kishorkishor/Terrarium/tools/report/assets/bench-photo.jpg

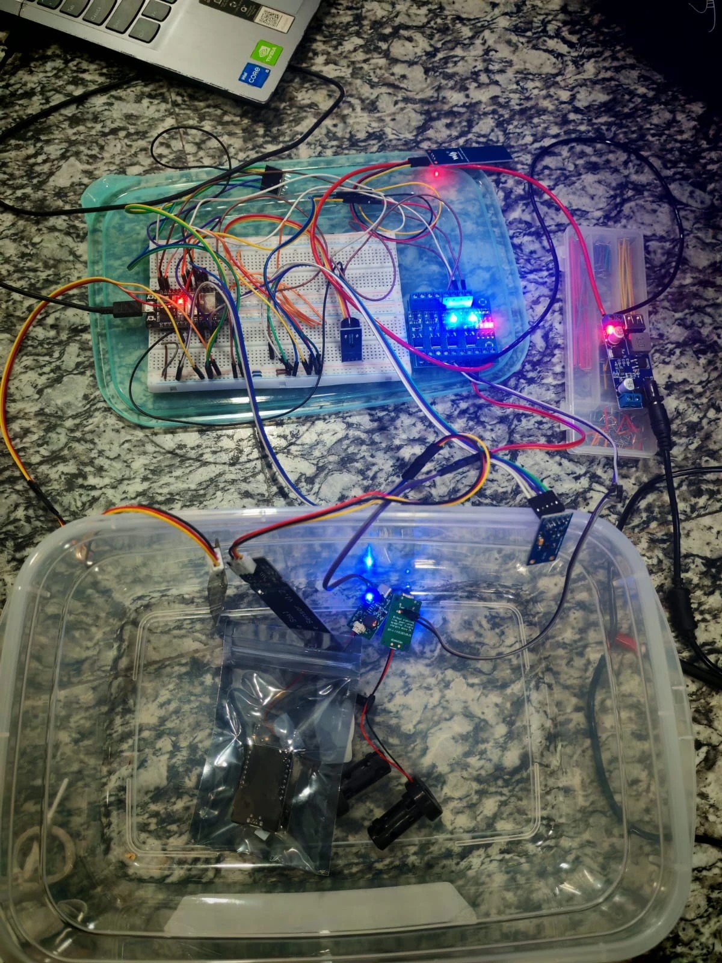
tools/report/assets/bench-photo.jpg
