kishorkishor/Terrarium/tools/report/assets/prototype-photo.jpg

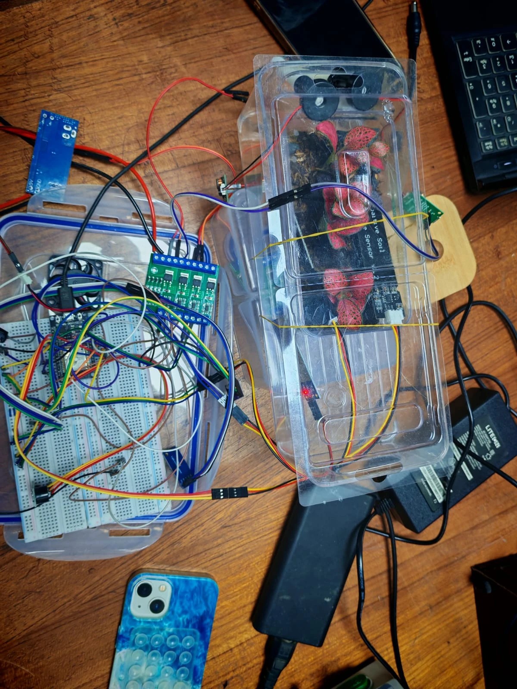
tools/report/assets/prototype-photo.jpg
