kishorkishor/Terrarium/3d/acrylic/README.md

# Bigger transparent enclosure (laser-cut clear acrylic)

Generated by `make_acrylic.py`. Change a number at the top of the script and run it again to resize everything.

## Size

| | mm | ft |
|---|---|---|
| Whole box, outside | 548 x 222 x 256 | 1.80 x 0.73 x 0.84 |
| Terrarium bay, inside (two fittonias) | 320 x 200 x 250 | 1.05 x 0.66 x 0.82 |
| Electronics bay, inside | 110 x 200 x 250 | 0.36 x 0.66 x 0.82 |
| Air-unit bay, inside | 90 x 200 x 250 | 0.30 x 0.66 x 0.82 |

## What to give the cutting shop

Folder `cut-files/`. Each sheet comes as `.ai`, `.pdf`, `.dxf` and `.svg`; they are the same drawing, 1:1 in mm, red hairline cut lines, no text.

| File | Material | Sheet |
|---|---|---|
| `sheet_A_3mm` | 3 mm clear **cast** acrylic | 900 x 600 mm |
| `sheet_B_3mm` | 3 mm clear **cast** acrylic | 900 x 600 mm |
| `sheet_C_2mm` | 2 mm clear acrylic (damper plate only) | 206 x 305 mm offcut |

If their bed is smaller than 900 x 600, they can re-nest the parts; every part is a closed shape.
The `.ai` files are PDF-format Illustrator files. Open in Illustrator and Save As if the shop wants a specific AI version.
`PART-MAP_sheet_*.pdf` shows which outline is which part. Do not send the part map for cutting.

## Every component and where it goes

| Component (firmware pin) | Where | Opening / mount provided |
|---|---|---|
| ESP32 DevKit | electronics bay | `electronics_tray`, 10 mm grid of M3 holes; USB slot in `end_electronics` |
| MOSFET board(s) for fans, light, mist | electronics bay | tray grid |
| LM2596 buck converter | electronics bay | tray grid |
| Two mist driver boards (GPIO25, GPIO16) | electronics bay | tray grid; disc cables through low grommets |
| Buzzer (GPIO26) | electronics bay | tray grid; vents let the sound out |
| 12 V DC input jack | `end_electronics` | 8 mm hole |
| 5x20 fuse holder | `end_electronics` | 12 mm hole |
| Spare switch / button | `end_electronics` | 6 mm hole |
| Electronics cooling | `end_electronics`, `back`, `lid_electronics` | vent slots low and high |
| BME280 + BH1750 (I2C 21/22) | terrarium, hung high on the solid divider | 12 mm high grommet |
| Soil probes x2 (GPIO34, 35) | in the two pots | low grommets, 12 mm x4 |
| Float switch (GPIO27), leak probe (GPIO32) | terrarium floor / water cup | low grommets |
| Mist discs x2 | water cup in the terrarium | low grommets; 25 mm refill port in `lid_terrarium` |
| DS18B20 (GPIO4, reserved) | terrarium | low grommets |
| LED light strip (GPIO19) | under `lid_terrarium` | 6 mm cable hole in the lid |
| Circulation fan 40 mm (GPIO18) | hangs under `lid_terrarium` | `fan_bracket` + two slots in the lid |
| Exhaust fan 40 mm (GPIO17) | `end_fan` | 38 mm hole, 4 x 3.4 mm screws at 32 mm; cable runs through the 8 mm top-corner holes in both dividers |
| Slide damper | between terrarium and air unit | `divider_damper` + `damper_plate` + 2 spacers + 2 covers; notch in `lid_air` |
| Fresh-air intake | `lid_terrarium`, electronics end | 5 slots |
| Peltier (optional) | air-unit bay | 6 mm drain hole in the base; no cutout made, add when the module is chosen |

Measure your DC jack, fuse holder and grommets before cutting. Hole sizes are one line each in the script.

## Assembly

1. Dry-fit first. Cross panels (2 ends, 2 dividers) tab into the front, back and base.
2. Glue with acrylic solvent cement (or chloroform from a sign shop). Run a bead of aquarium silicone along every inside seam of the terrarium bay and over the tab slots in its floor.
3. Damper: glue `guide_spacer` strips to the air-unit side of `divider_damper`, flush with the front and back walls, 5 mm above the floor. Drop the 2 mm plate between them, then glue `guide_cover` strips on top of the spacers so they overhang the plate. Plate resting on the floor = closed. Lift 10 mm and push an M3 screw through the lower tab hole so it rests on the lids = open.
4. Glue four `lid_locator` strips under each lid, just inside the walls, so lids cannot slide.
5. Keep the fittonias in pots or a plastic tray with drainage layer; do not fill the acrylic box itself with water.

## Onshape

- Quick look: import `acrylic-assembled.stl` (units: millimeter).
- Native, editable parts: import the files in `onshape-dxf-per-part/`, then in a Part Studio start a sketch, use **Insert DXF or DWG**, and extrude 3 mm (2 mm for the damper plate).
