kishorkishor/Terrarium/ffffffffffffffffffffffffffff (1) (2).docx

| AMERICAN INTERNATIONAL UNIVERSITY-BANGLADESH (AIUB) Faculty of Engineering Department of CSE, EEE, and CoE EEE4103 MICROPROCESSOR AND EMBEDDED SYSTEMS

COURSE CAPSTONE PROJECT PROPOSAL

Design and Implementation of an IoT-Based Automated Tropical Terrarium Environmental Monitoring and Control System

Semester | Summer 2025-26
Section | [INSERT SECTION]
Faculty Member | [INSERT FACULTY MEMBER]
Project Group No. | [INSERT GROUP NUMBER]
Submission Date | [INSERT DATE]
Survey Link | [INSERT GOOGLE/MICROSOFT FORMS LINK]

Prepared in accordance with the official EEE4103 capstone proposal requirements for Summer 2025-26.

Group Members

Sl. | Student Name | Student ID | Program / Email
1
2
3
4
5
6

Note: The official form permits a maximum of six members. A four-member group may be allowed depending on capability, but the form states that fewer than four students are not permitted.

1. Project Title [2 Marks]

Design and Implementation of an IoT-Based Automated Tropical Terrarium Environmental Monitoring and Control System

The title identifies the target system (a tropical terrarium), the engineering method (ESP32-based embedded control and IoT communication), and the intended outcome (automated environmental monitoring and regulation). Both a physical prototype and a functional simulation will be demonstrated.

2. Project Description and Problem Statement

Indoor terrariums require regular observation and careful balancing of air temperature, relative humidity, soil moisture, illumination, ventilation, and water availability. Manual care may become inconsistent when users are busy, away from home, or unfamiliar with plant requirements. Overwatering can produce waterlogging, root damage, odour, and fungal growth; underwatering, high temperature, poor ventilation, and inadequate lighting can weaken plants. A compact embedded system can reduce these risks by sensing the environment, applying controlled corrective actions, and warning the user when intervention is required.

The proposed system will use an ESP32 DevKit V1 as the local decision-making unit. It will measure temperature and humidity using a DHT22 module, root-zone moisture using a capacitive sensor, illumination using a BH1750, reservoir availability using a sealed float switch, and accidental leakage using a drip-tray sensor. Configurable thresholds, hysteresis, time limits, and safety interlocks will control a 5 V irrigation pump, 5 V mist maker, 5 V exhaust fan, and 5 V grow light through a 3.3 V-trigger opto-isolated relay module. A mobile IoT dashboard will provide live values, historical graphs, alerts, manual control, threshold adjustment, and automatic/manual operating modes. Local automatic operation will continue if Wi-Fi becomes unavailable.

3. Survey [12 Marks]

A Google Forms or Microsoft Forms survey will evaluate the practical need, user expectations, affordability, electrical-safety concerns, environmental value, and societal acceptance of the automated terrarium. The survey contains 20 questions, exceeding the minimum requirement of 12 questions, and will collect at least 40 genuine responses.

No. | Question | Type | Options / Scale
1 | What is your age group? | Multiple choice | Below 18; 18-24; 25-34; 35-44; 45 or above
2 | What is your current occupation? | Multiple choice | Student; Teacher; Service holder; Businessperson; Homemaker; Other
3 | Where do you currently live? | Multiple choice | Urban area; Suburban area; Rural area
4 | Are you familiar with terrariums or enclosed indoor plant ecosystems? | Multiple choice | Yes; Somewhat; No
5 | Do you currently keep indoor plants at your home, office, or educational institution? | Multiple choice | Yes; No; Previously did
6 | How often do you forget to water or care for indoor plants? | Multiple choice | Never; Rarely; Sometimes; Often; Very often
7 | Have any of your indoor plants become unhealthy or died because of improper watering, lighting, temperature, or humidity? | Multiple choice | Yes; No; Not sure
8 | Which environmental factor is the most difficult for you to maintain? | Multiple choice | Soil moisture; Temperature; Humidity; Lighting; Ventilation; All of these
9 | How useful would automatic soil-moisture monitoring and irrigation be? | Linear scale (1-5) | 1 = Not useful; 5 = Extremely useful
10 | How useful would automatic temperature and humidity control be? | Linear scale (1-5) | 1 = Not useful; 5 = Extremely useful
11 | How useful would automatic grow-light control based on environmental light be? | Linear scale (1-5) | 1 = Not useful; 5 = Extremely useful
12 | Would you like to monitor the terrarium's temperature, humidity, soil moisture, light level, and reservoir status through a mobile app? | Multiple choice | Yes; Maybe; No
13 | Which mobile-app feature would be most useful to you? | Multiple choice | Live sensor readings; Manual controls; Alerts; Historical graphs; Adjustable thresholds; All features
14 | Would you prefer the system to have both automatic and manual operating modes? | Multiple choice | Yes; No; Not sure
15 | Which warning would be most important to you? | Multiple choice | Empty water tank; Dry soil; High temperature; Low humidity; Water leakage; Sensor failure
16 | How concerned would you be about electrical safety when using an automated system containing water, pumps, and electronic components? | Linear scale (1-5) | 1 = Not concerned; 5 = Extremely concerned
17 | Would safety features such as low-voltage operation, leakage detection, automatic pump shutdown, and an external electronics box increase your trust in the system? | Multiple choice | Yes; Maybe; No
18 | Do you believe an automated terrarium could encourage indoor gardening and environmental awareness among students and urban residents? | Likert scale | Strongly disagree; Disagree; Neutral; Agree; Strongly agree
19 | Do you believe automatic irrigation could reduce water wastage compared with manual watering? | Likert scale | Strongly disagree; Disagree; Neutral; Agree; Strongly agree
20 | What price range would you consider reasonable for a complete small automated terrarium system in Bangladesh? | Multiple choice | Below BDT 5,000; BDT 5,000-8,000; BDT 8,001-12,000; BDT 12,001-16,000; Above BDT 16,000

Planned analysis: Responses will be summarized using colour pie charts and bar charts for plant-care difficulties, feature acceptance, app-control preference, safety concern, perceived environmental impact, and acceptable price range. The findings will be connected to design decisions such as low-voltage operation, leak detection, local manual controls, and the selection of automatic functions.

Link : https://docs.google.com/forms/d/e/1FAIpQLScDCc7va5FKP2GrCQ1w3iLBoVPyHjYZuqwSofswbJRvDBjAcg/viewform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

1. To design an ESP32-based embedded system that measures air temperature, relative humidity, soil moisture, light intensity, reservoir water level, and accidental leakage in and around a tropical terrarium.

2. To implement automatic control of irrigation, misting, ventilation, and artificial lighting using configurable thresholds, hysteresis, timing limits, and safety interlocks.

3. To integrate a mobile IoT application for real-time monitoring, historical visualization, notification alerts, automatic/manual mode selection, threshold adjustment, and remote actuator control.

4. To simulate the sensor inputs and control logic before hardware integration and compare simulated behaviour with the physical prototype.

5. To evaluate the system using measurable indicators including sensor error, actuator response time, irrigation volume, connectivity reliability, water usage, and environmental stability.

6. To develop a low-voltage, externally enclosed, and leak-protected prototype suitable for educational demonstration and responsible indoor plant care.

5. Literature Review [12 Marks]

Recent publications show that IoT sensors, embedded controllers, cloud dashboards, and automatic actuators can improve environmental awareness, plant-growth control, and resource management. Seven recent studies were reviewed to identify useful design ideas and gaps relevant to a compact terrarium.

Publication | Approach | Useful finding | Identified limitation | Use in proposed project
Galon, Tumaliwan, and Sejera, 2025 [1] | ESP32 and Blynk greenhouse monitoring and control of temperature, humidity, light, and soil moisture. | Directly demonstrates ESP32/mobile monitoring and multi-parameter actuator control. | The work targets a greenhouse and does not emphasise compact leak protection, terrarium substrate, or offline safety logic. | Adopt ESP32/Blynk concepts while adding local fail-safe operation, float-switch protection, leak sensing, and a glass enclosure.
Gupta et al., 2025 [2] | IoT-enabled automated irrigation using soil moisture, temperature, and humidity data with predictive resource optimisation. | Shows the value of data-based irrigation and water/energy efficiency. | Agricultural-scale predictive design is more complex than required for a compact indoor system. | Use calibrated moisture thresholds, short timed irrigation, a soak delay, and a maximum runtime.
Witczak and Szymoniak, 2024 [3] | Review of IoT monitoring/control architectures, applications, protocols, data integration, and challenges. | Supports a clear sensing-network-processing-application architecture. | Broad review without a validated terrarium prototype. | Keep the cloud interface separate from local automatic control so the system remains functional offline.
Thomopoulos et al., 2024 [4] | Small-scale smart greenhouse using fuzzy logic and IoT to create a self-regulating microclimate. | Demonstrates the feasibility of autonomous environmental adjustment in a small controlled plant enclosure. | Fuzzy control and greenhouse infrastructure may be unnecessarily complex for an introductory capstone. | Use understandable threshold/hysteresis logic while retaining multi-actuator microclimate control.
Kumar et al., 2024 [5] | Comprehensive review of IoT in smart irrigation, crop monitoring, greenhouses, and sustainable agriculture. | Highlights reduced resource waste and improved monitoring, while identifying cost, connectivity, security, and adoption issues. | Review is broad and not focused on a single indoor prototype. | Use low-cost components, simple app controls, local display, and safe autonomous operation.
Rajak et al., 2023 [6] | Review of IoT smart sensors for monitoring moisture, humidity, temperature, soil, and other agricultural variables. | Confirms that integrated smart sensors are central to resource-aware plant monitoring. | Cost, digital literacy, and data-security challenges remain; no single compact ecosystem is proposed. | Use common sensors, a simple dashboard, and limited data collection without sensitive user information.
Kaur, Upadhyaya, and Chawla, 2023 [7] | Comparison of automated and unautomated IoT-enabled controlled-environment vertical farming. | Reports measurable plant-growth benefits from automated environmental control. | Hydroponic pH/TDS control and vertical-farm infrastructure are unsuitable for a simple soil terrarium. | Retain temperature, humidity, lighting, and water control while using a layered soil substrate.

## 5.1 Identified Research and Design Gap

Existing work commonly targets agricultural fields, full-size greenhouses, hydroponics, or monitoring-only platforms. A compact educational terrarium requires a different balance: layered soil, condensation management, low-voltage operation near water, local autonomous control, app-based manual override, reservoir protection, leak shutdown, and simple maintenance. The proposed project addresses this gap by combining these features in one demonstrable embedded-system prototype.

6. Experimental Block Diagram [6 Marks]

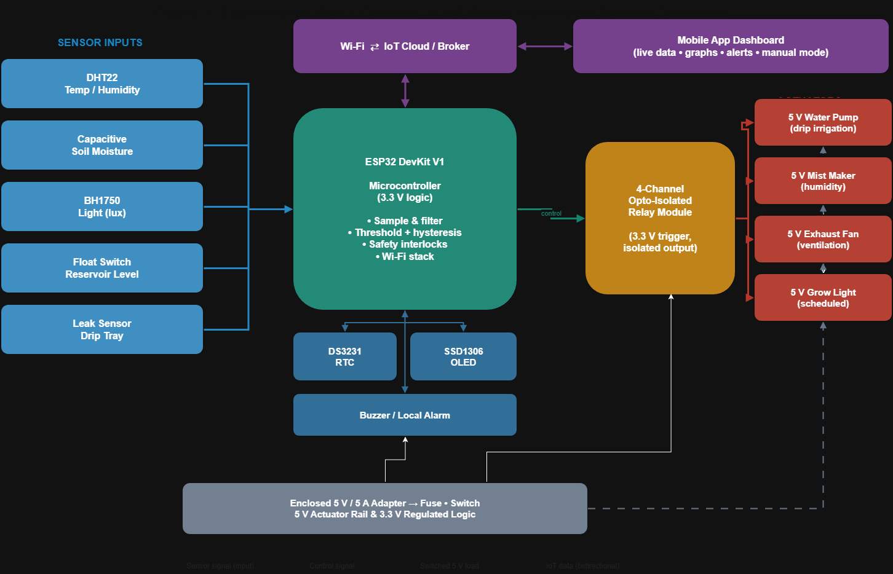
[picture p9: figure]

Figure 1. Experimental block diagram showing sensor inputs, ESP32 processing, IoT communication, isolated switching, actuators, and low-voltage power distribution.

## 6.1 Physical Terrarium Structure

Layer / assembly | Recommended specification | Function
Glass enclosure | Approx. 45 cm x 30 cm x 35 cm, open top, aquarium-safe silicone joints | Provides a visible enclosed plant environment.
Removable acrylic lid | Approx. 3 mm acrylic with fan, intake, tube, and cable openings | Allows safe machining without drilling glass and supports ventilation.
Drainage layer | 3-4 cm LECA or washed aquarium gravel | Stores excess water below the root zone.
Separator mesh | Fibreglass or plastic mesh | Prevents soil from entering the drainage layer.
Charcoal layer | Thin horticultural activated-charcoal layer | Reduces odour and improves lower-layer cleanliness.
Growing substrate | Coco peat, perlite, bark/coco chips, and a small amount of vermicompost | Provides moisture retention, aeration, and plant support.
Plants | Fittonia, small Peperomia, small fern/Selaginella, and live moss | Uses species with broadly compatible tropical moisture requirements.
External reservoirs | Separate irrigation reservoir and mist chamber | Keeps standing water outside the glass enclosure.
External electronics box | ABS project box mounted above reservoir level | Separates ESP32, relay, and power distribution from humidity and splashes.

## 6.2 Main Components and Compatibility

Component | Qty. | Role | Compatibility / safety requirement
ESP32 DevKit V1 | 1 | Main embedded controller and Wi-Fi interface | 3.3 V GPIO; powered from regulated 5 V input.
DHT22 module | 1 | Air temperature and humidity | Use a module compatible with 3.3 V data levels.
Capacitive soil-moisture sensor | 1 | Root-zone moisture estimation | Power from 3.3 V so analog output remains within ESP32 ADC range.
BH1750 light sensor | 1 | Digital light intensity in lux | 3.3 V-compatible I2C device.
Sealed float switch | 1 | Low-reservoir detection | Passive switch with ESP32 pull-up; physically sealed.
Leak sensor | 1 | Detects water in external drip tray | Triggers water-output shutdown and alert.
SSD1306 I2C OLED | 1 | Local readings and equipment status | Shares I2C bus with BH1750 and RTC.
DS3231 RTC | 1 | Offline day/night lighting schedule | Maintains time when Wi-Fi is unavailable.
3.3 V-trigger opto-isolated relay module | 1 x 4-channel | Switches the four 5 V loads | Must explicitly accept 3.3 V trigger signals; output terminals enclosed.
5 V submersible pump | 1 | Timed drip irrigation | Powered from actuator rail, never from ESP32 pin.
5 V complete mist-maker kit | 1 | Humidity increase | Complete driver, atomizer, wick, and external chamber.
5 V brushless fan | 1 | Heat/excess-humidity exhaust | Mounted with guards and passive intake.
5 V USB grow light | 1 | Scheduled supplemental lighting | Low-voltage DC only; no exposed mains wiring near water.
Enclosed 5 V / 5 A adapter | 1 | System power | Low-voltage fuse, switch, terminal distribution, and suitable wire.

## 6.3 Working Principle

1. At startup, the ESP32 initializes the sensors, OLED, real-time clock, Wi-Fi connection, and mobile application interface.

2. The controller samples temperature, humidity, soil moisture, light intensity, reservoir state, and leak state at fixed intervals.

3. Readings are filtered and compared with upper and lower thresholds. Hysteresis prevents rapid switching.

4. If soil moisture is below the calibrated minimum and the reservoir is available, the pump runs for a short fixed interval, then waits for a soak delay before the next decision.

5. If humidity is below the lower limit, the mist maker runs for a limited interval. Excessive humidity blocks misting and may activate ventilation.

6. If temperature or humidity exceeds its upper limit, the exhaust fan operates while a passive intake provides replacement air.

7. During the configured daytime schedule, the grow light turns on only when illumination is below the selected threshold.

8. If the reservoir is empty or leakage is detected, the pump and mist maker are disabled, the buzzer activates, and an app notification is generated.

9. Manual commands are accepted in manual mode, but maximum runtimes and safety interlocks remain active.

10. If Wi-Fi fails, the ESP32 continues local automatic operation and displays the connection status on the OLED.

## 6.4 Proposed Control Conditions

Condition | Automatic action | Stop/reset condition | Safety rule
Soil moisture below calibrated minimum | Pump ON for 2-5 s | Timed cycle ends; recheck after soak delay | Blocked by empty reservoir or leak state.
Humidity below lower threshold | Mist maker ON for a limited interval | Humidity reaches upper threshold or timer ends | Maximum runtime and reservoir check.
Temperature or humidity above upper threshold | Ventilation fan ON | Values return below lower thresholds | Fan remains available if app is offline.
Low lux during daytime schedule | Grow light ON | Lux rises or daytime schedule ends | Maximum daily lighting duration.
Reservoir empty | Pump and mist OFF; buzzer/app alert | Reservoir refilled and state acknowledged | No manual bypass for water outputs.
Leak detected | Pump and mist OFF; alert | Leak cleared and manual reset performed | Highest-priority shutdown condition.

7. Simulation and Hardware Implementation Plan

## 7.1 Simulation

The system will be simulated using Wokwi or an equivalent microcontroller simulator. DHT22 inputs will represent temperature and humidity. Potentiometers or virtual analog controls will represent soil moisture, light level, water availability, and leak state when direct models are unavailable. LEDs will represent the pump, mist maker, fan, and grow light. The serial monitor and virtual OLED will show measured values and output states. Test cases will include dry soil, low humidity, high temperature, low light, empty reservoir, leakage, manual mode, and Wi-Fi interruption logic.

## 7.2 Hardware Implementation

- Construct and leak-test the glass enclosure before adding plants or electronics.
- Prepare drainage, mesh, charcoal, and substrate layers; plant species with compatible humidity requirements.
- Prototype and calibrate each sensor separately on a breadboard.
- Test each actuator using the external 5 V supply and relay module before connecting it to the terrarium.
- Assemble the final circuit on veroboard or a custom PCB with labelled detachable connectors.
- Mount electronics outside the terrarium and above reservoir level; route cables through acrylic-lid glands.
- Integrate the mobile dashboard and verify that automatic operation continues when the app is disconnected.
- Perform fuse, low-water, leak-shutdown, and emergency-output-disable tests before extended operation.

## 7.3 Evaluation Metrics

Metric | Method | Proposed acceptance target
Temperature error | Compare with a reference thermometer | Report mean absolute error; target approximately within 1-2 C.
Humidity error | Compare with a reference hygrometer | Report mean absolute error and compare with sensor specification.
Soil calibration | Record dry and saturated ADC endpoints | Stable percentage conversion with repeatable threshold switching.
Actuator response time | Time condition/command to output activation | Target below 2 s for local automatic actions.
Irrigation volume | Measure water delivered per timed cycle | Repeatable small dose without visible flooding.
Connectivity reliability | Record app updates and reconnection | Automatic control continues during network loss.
Safety response | Trigger empty-tank and leak states | Immediate pump/mist shutdown and visible/audible alert.
Environmental stability | Log values during repeated operation | Reduced extreme excursions compared with no-control operation.

8. Possible Outcomes and Societal/Cultural Impact [4 Marks]

- A functional glass tropical terrarium capable of continuous environmental sensing and automatic corrective control.
- Reduced dependence on frequent manual observation and lower risk of overwatering, underwatering, overheating, prolonged high humidity, or inadequate lighting.
- More deliberate water use through measured irrigation cycles rather than unrestricted manual watering.
- Remote awareness through live mobile readings, history graphs, and alerts when users are away.
- An educational demonstration of microcontrollers, sensors, feedback control, IoT communication, electrical safety, plant biology, and environmental responsibility.
- Encouragement of indoor gardening and environmental interest in homes, classrooms, and small urban spaces.
- A modular platform that can later be adapted for seedling boxes, indoor plant cabinets, small greenhouses, or educational ecosystem displays.
- A reproducible performance report containing calibration data, response times, irrigation measurements, and safety-test results.

9. Project Timeline (Gantt Chart) [7 Marks]

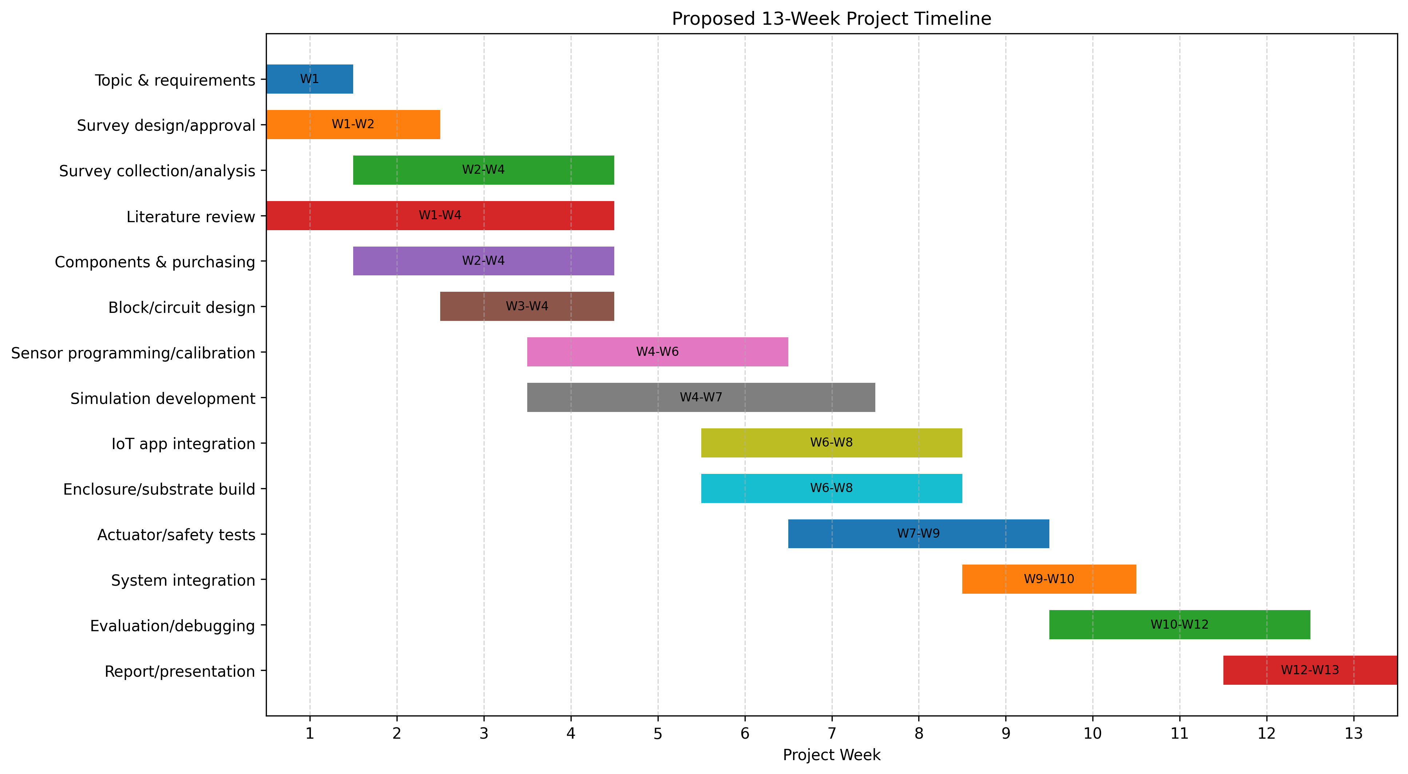
[picture p10: figure]

Figure 2. Proposed 13-week development schedule showing the active period for each project task.

10. References [3 Marks]

[1] M. L. Q. Galon, M. V. R. Tumaliwan, and M. M. Sejera, “Automated Monitoring and Control System of Solar Greenhouse Using ESP32 and Blynk Application,” Engineering Proceedings, vol. 92, no. 1, Art. no. 57, 2025, doi: 10.3390/engproc2025092057.

[2] S. Gupta, S. Chowdhury, R. Govindaraj, K. T. T. Amesho, S. Shangdiar, T. Kadhila, and S. Iikela, “Smart agriculture using IoT for automated irrigation, water and energy efficiency,” Smart Agricultural Technology, vol. 12, Art. no. 101081, 2025, doi: 10.1016/j.atech.2025.101081.

[3] D. Witczak and S. Szymoniak, “Review of Monitoring and Control Systems Based on Internet of Things,” Applied Sciences, vol. 14, no. 19, Art. no. 8943, 2024, doi: 10.3390/app14198943.

[4] V. Thomopoulos, F. Tolis, T.-F. Blounas, D. Tsipianitis, and A. Kavga, “Application of Fuzzy logic and IoT in a small-scale Smart Greenhouse System,” Smart Agricultural Technology, vol. 8, Art. no. 100446, 2024, doi: 10.1016/j.atech.2024.100446.

[5] V. Kumar, K. V. Sharma, N. Kedam, A. Patel, T. R. Kate, and U. Rathnayake, “A comprehensive review on smart and sustainable agriculture using IoT technologies,” Smart Agricultural Technology, vol. 8, Art. no. 100487, 2024, doi: 10.1016/j.atech.2024.100487.

[6] P. Rajak, A. Ganguly, S. Adhikary, and S. Bhattacharya, “Internet of Things and smart sensors in agriculture: Scopes and challenges,” Journal of Agriculture and Food Research, vol. 14, Art. no. 100776, 2023, doi: 10.1016/j.jafr.2023.100776.

[7] G. Kaur, P. Upadhyaya, and P. Chawla, “Comparative analysis of IoT-based controlled environment and uncontrolled environment plant growth monitoring system for hydroponic indoor vertical farm,” Environmental Research, vol. 222, Art. no. 115313, 2023, doi: 10.1016/j.envres.2023.115313.

Appendix A: Complete Bill of Materials

Category | Items | Quantity / specification | Purpose
Structure | Glass enclosure; acrylic lid; aquarium-safe silicone; rubber feet; drip tray; ABS electronics box; cable glands | 45 x 30 x 35 cm enclosure; approx. 3 mm lid; 1 set | Safe visible enclosure and external electronics protection.
Drainage/substrate | LECA/gravel; mesh; activated charcoal; coco peat; perlite; bark/coco chips; vermicompost; sphagnum moss | 4-5 L LECA; 500 g charcoal; 5 L coco peat; 2 L perlite; 1.5 L bark; 500 g compost | Stable tropical growing medium and drainage.
Plants | Fittonia; Peperomia; small fern/Selaginella; live moss | Approx. 4-5 small plants | Compatible tropical plant community.
Controller/sensors | ESP32; DHT22; capacitive soil sensor; BH1750; float switch; leak sensor; DS3231; OLED | 1 each | Monitoring, timing, decision-making, and display.
Actuators | 5 V pump; 5 V mist-maker kit; 5 V fan; 5 V USB grow light; buzzer | 1 each | Irrigation, humidity, ventilation, lighting, and alarm.
Switching/power | 4-channel opto-isolated relay; 5 V/5 A enclosed adapter; fuse; switch; terminal blocks; suitable wire; heat-shrink | 1 set | Safe low-voltage load switching and power distribution.
Water system | 1.5-2 L reservoir; mist chamber; 8 x 6 mm tube; T-piece; check valve; drip emitters; clamps | 1 set | Controlled irrigation and external mist generation.
Assembly/testing | Breadboard; jumper wires; veroboard; JST connectors; screw terminals; multimeter; reference thermometer/hygrometer; measuring cup | As required | Prototype, final assembly, calibration, and evaluation.

Appendix B: Pre-Submission Compliance Checklist

Check | Requirement | Status / Notes
[ ] | Project title clearly identifies the engineering problem, method, target, and expected outcome.
[ ] | Embedded platform, sensors, actuators, hardware implementation, and simulation are clearly identified.
[ ] | Survey contains at least 12 questions and has at least 40 genuine respondents.
[ ] | Survey link and colour pie/bar charts have replaced the placeholders.
[ ] | At least three measurable objectives use action verbs such as design, implement, integrate, simulate, and evaluate.
[ ] | At least six recent published papers are reviewed with problems, limitations, and relevance.
[ ] | Colour block diagram shows sensor, control, actuator, IoT, and power flows.
[ ] | Possible societal and cultural outcomes are explained.
[ ] | Gantt chart shows ordered tasks across specific weeks.
[ ] | References use IEEE style and published journal/conference sources.
[ ] | Group member, section, faculty, group number, date, and survey link fields are completed.
[ ] | All pages, diagrams, tables, and charts are printed in colour.

IoT Automated Terrarium Capstone Proposal Page

AIUB | EEE4103 Microprocessor and Embedded Systems
