kishorkishor/Terrarium/3d/acrylic/cut-files/CUT-LIST.pdf

# Terrarium enclosure: cut list

Cut each file ONE time. Every piece is already drawn the number of times it is needed, so nothing has to be repeated.

File | Material | Sheet size | Cut how many times
sheet_A_3mm.ai | 3 mm clear CAST acrylic | 900 x 600 mm | 1
sheet_B_3mm.ai | 3 mm clear CAST acrylic | 900 x 600 mm | 1
sheet_C_2mm.ai | 2 mm clear acrylic | 206 x 305 mm | 1

### Pieces you should receive

Part | Pieces | On sheet
front | 1 | A
back | 1 | A
end wall, electronics side | 1 | A
end wall, fan side | 1 | A
base | 1 | B
divider, solid (5 round holes) | 1 | B
divider, damper (27 slots) | 1 | B
lid, electronics | 1 | B
lid, terrarium | 1 | B
lid, air unit | 1 | B
electronics tray (hole grid) | 1 | B
guide spacer strip, 6 x 240 mm | 2 | B
guide cover strip, 16 x 240 mm | 2 | B
fan bracket | 1 | B
lid locator strip, 10 x 50 mm | 12 | B
damper plate | 1 | C
TOTAL | 29

Scale 1:1, units millimetres. Check: the front panel is 548 mm long. All lines are cut lines, no engraving. Use cast acrylic only, never PVC. Parts may be re-nested onto smaller sheets.
