kishorkishor/Terrarium/3d/acrylic/PART-MAP_sheet_A_3mm.pdf

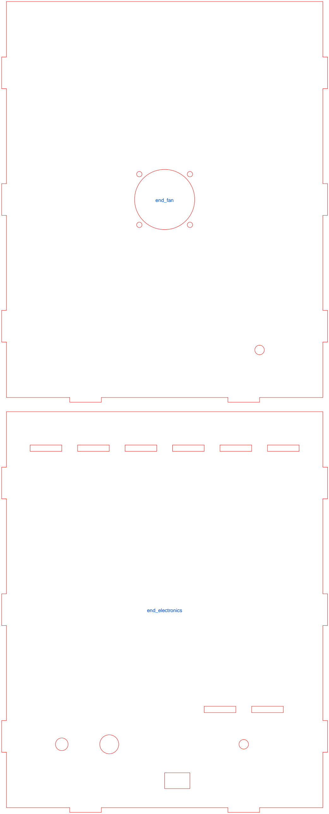
[picture p14: figure]
end_electronics; end_fan

front

back
