kishorkishor/Terrarium/3d/acrylic/cut-files/sheet_A_3mm.pdf

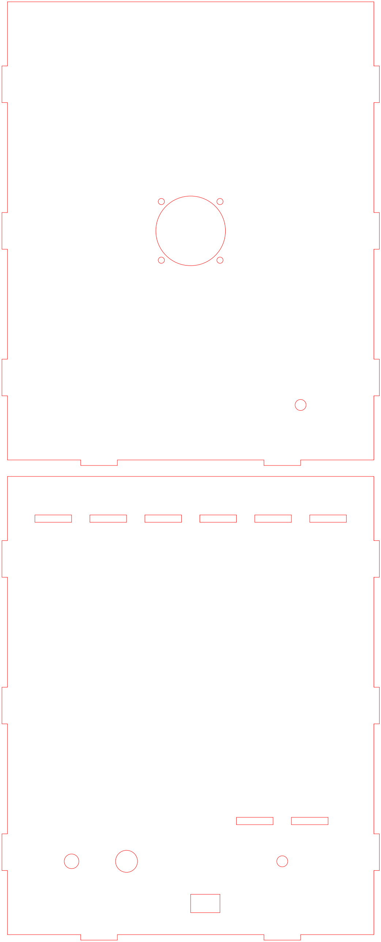
[picture p15: figure]
