kishorkishor/Terrarium/3d/acrylic/preview_exploded.png

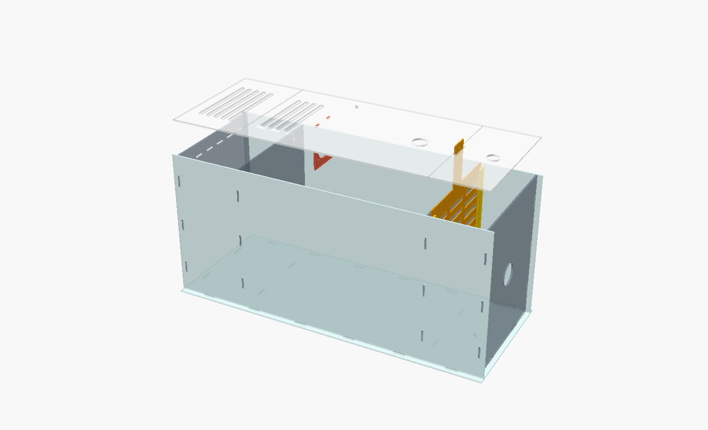
3d/acrylic/preview_exploded.png
