kishorkishor/Terrarium/3d/acrylic/preview_sheets.png

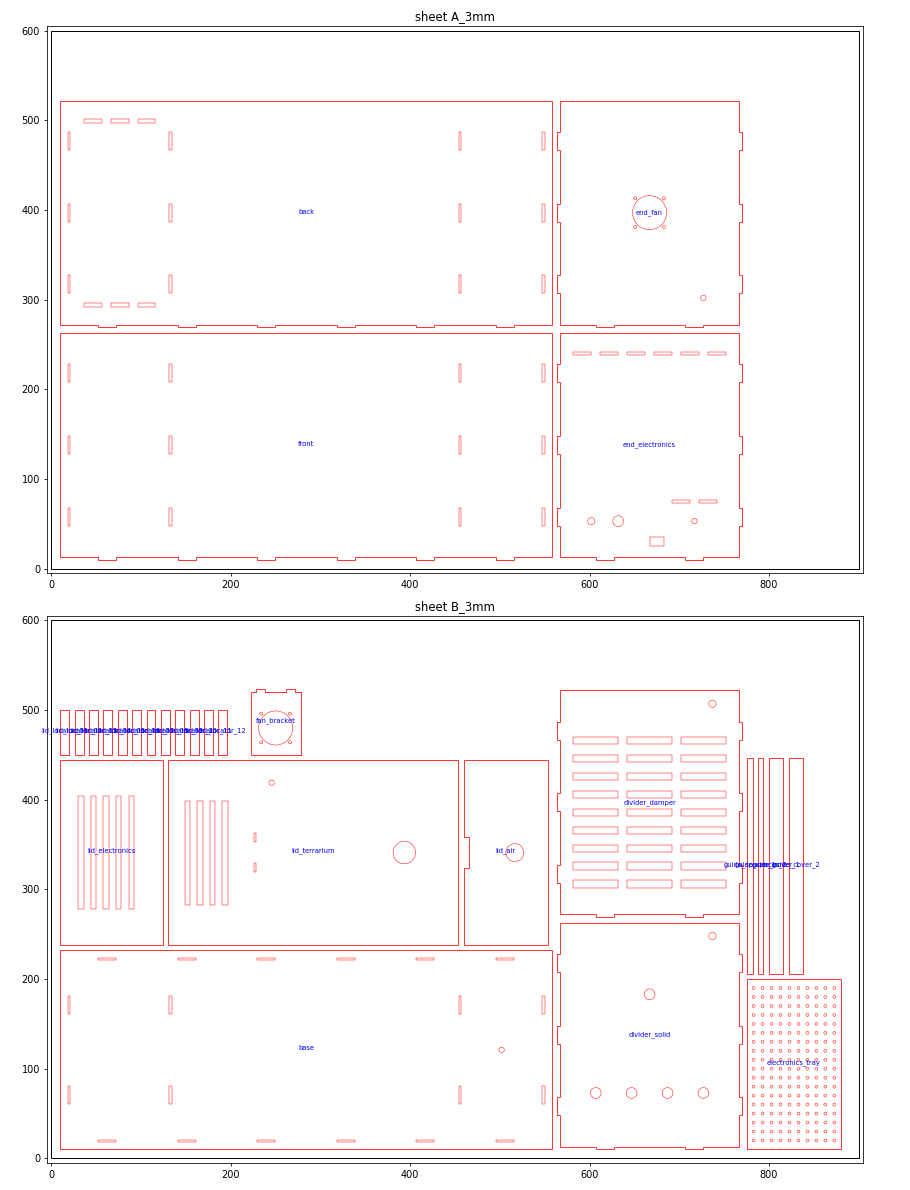
3d/acrylic/preview_sheets.png
