kishorkishor/Terrarium/3d/preview_3bay_damper_end.png

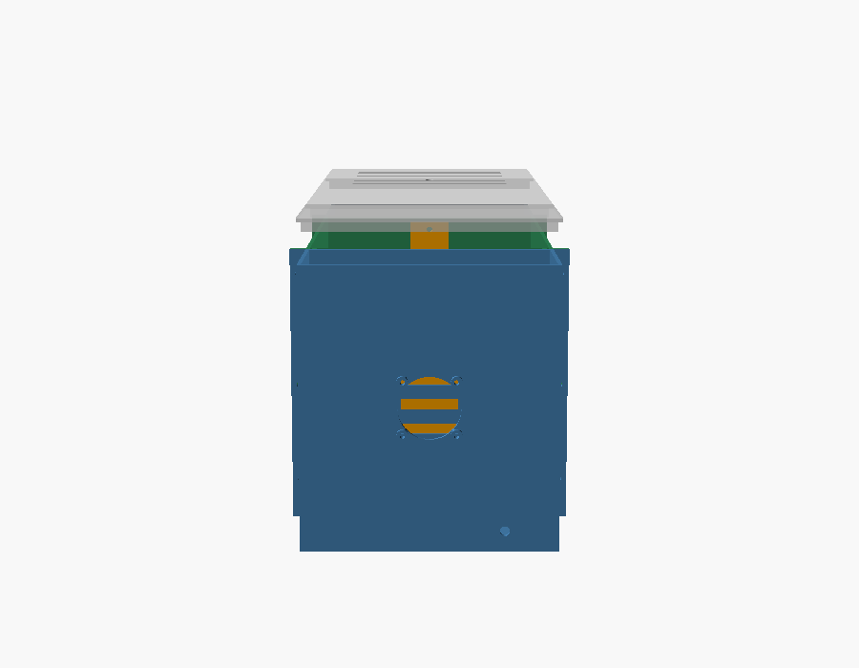
3d/preview_3bay_damper_end.png
