kishorkishor/Terrarium/3d/preview_box.png

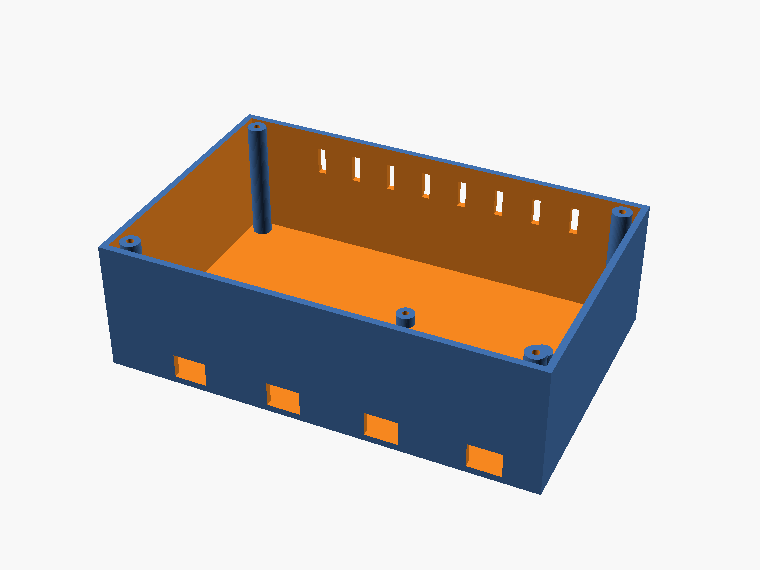
3d/preview_box.png
