kishorkishor/Terrarium/3d/preview_fan_duct.png

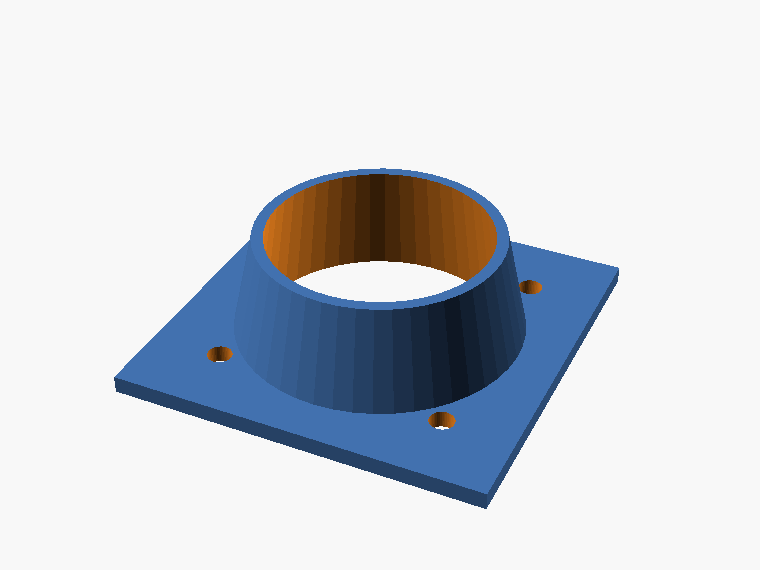
3d/preview_fan_duct.png
