kishorkishor/Terrarium/3d/preview_grommet.png

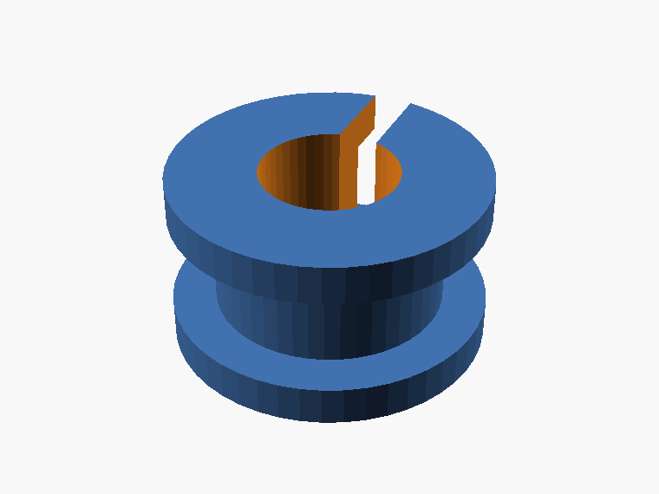
3d/preview_grommet.png
