kishorkishor/Terrarium/3d/preview_lid.png

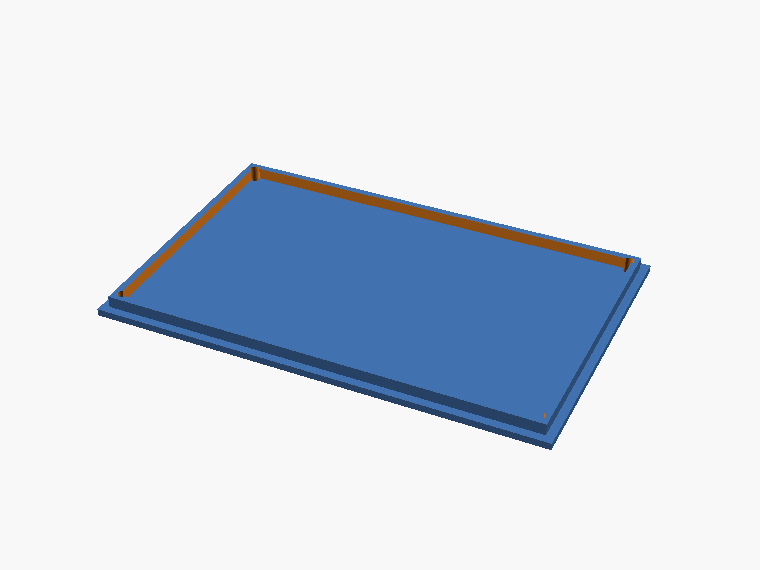
3d/preview_lid.png
