kishorkishor/Terrarium/3d/preview_sensor_shield.png

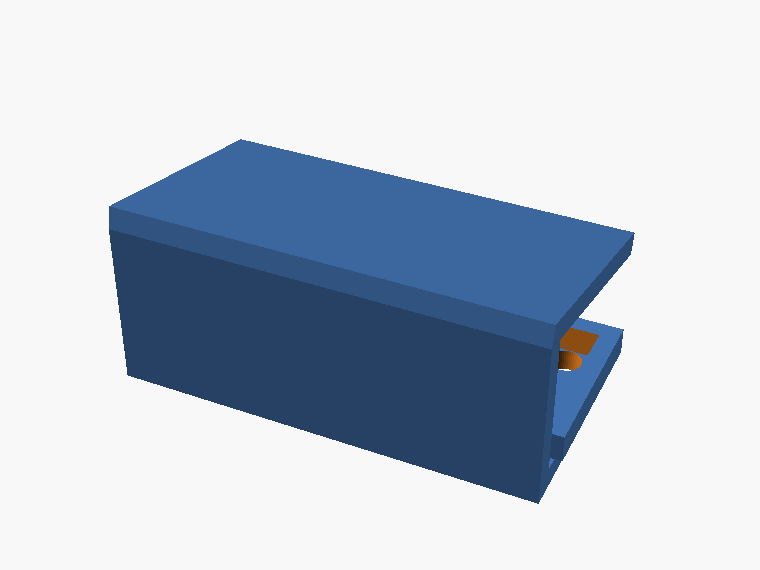
3d/preview_sensor_shield.png
