kishorkishor/Terrarium/3d/preview_soil_collar.png

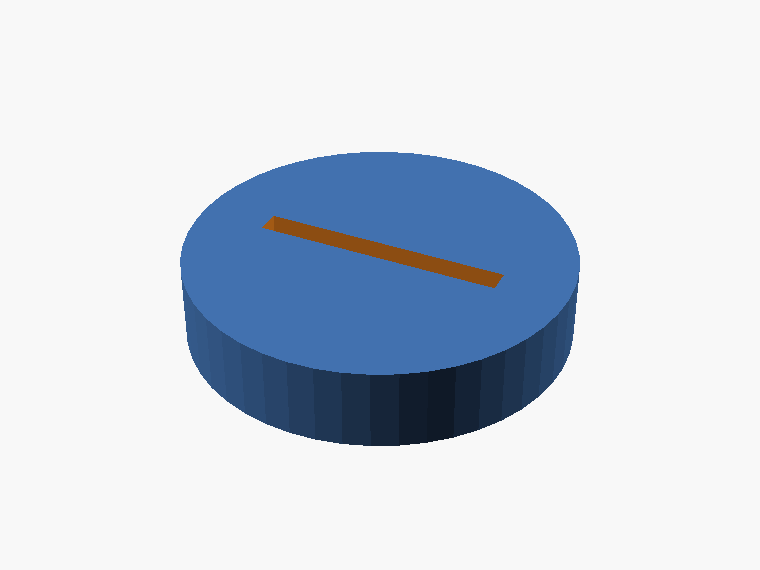
3d/preview_soil_collar.png
