kishorkishor/Terrarium/3d/sys_canopy_corner.png

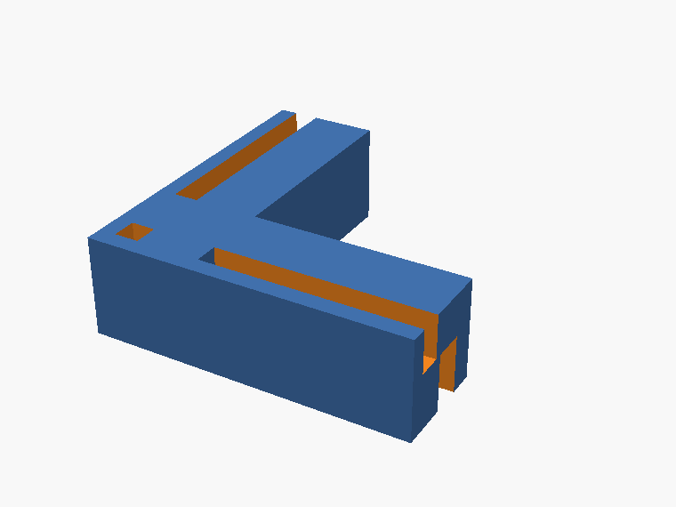
3d/sys_canopy_corner.png
