kishorkishor/Terrarium/3d/sys_canopy_rail.png

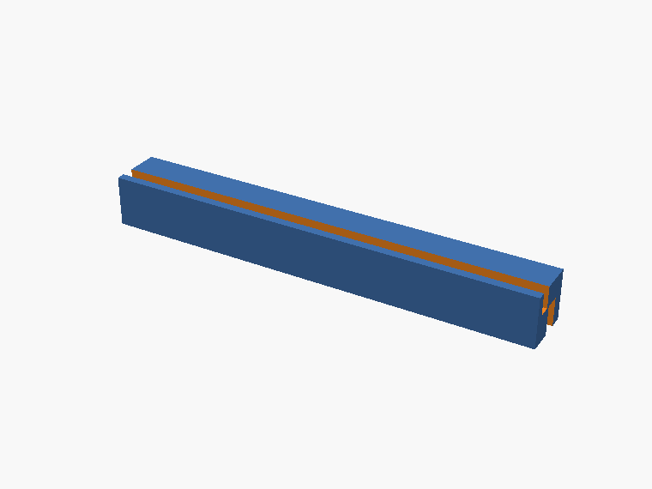
3d/sys_canopy_rail.png
