kishorkishor/Terrarium/3d/sys_divider.png

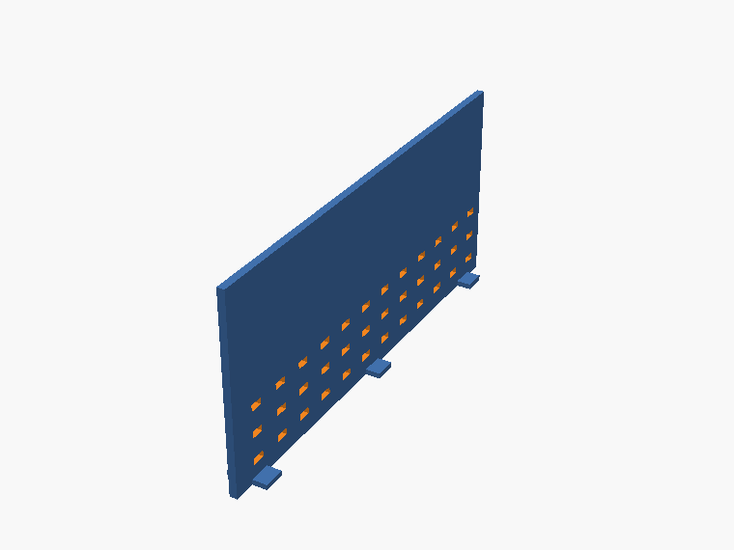
3d/sys_divider.png
