kishorkishor/Terrarium/3d/sys_fan_module.png

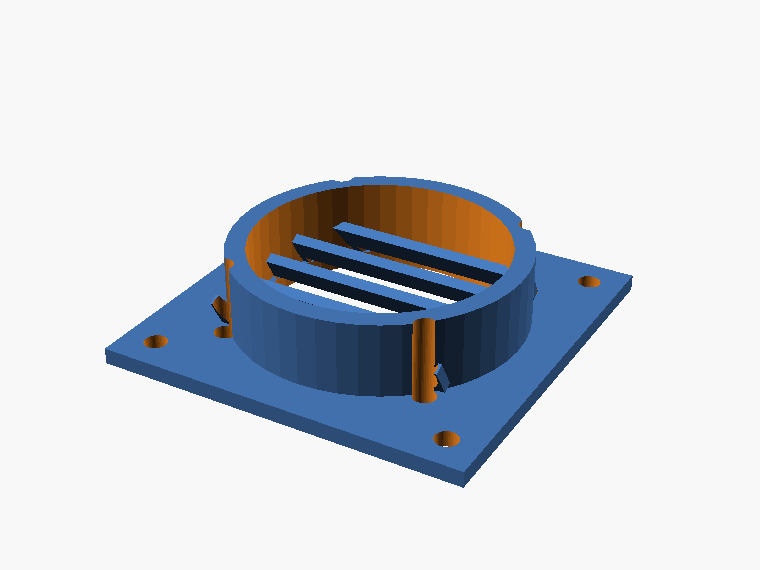
3d/sys_fan_module.png
