kishorkishor/Terrarium/3d/sys_light_rail.png

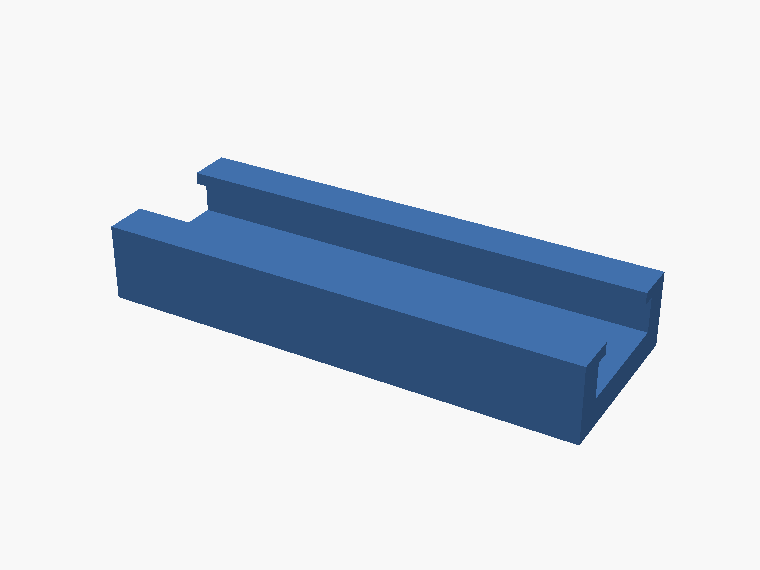
3d/sys_light_rail.png
