kishorkishor/Terrarium/data/box-humidity-2026-09-25.png

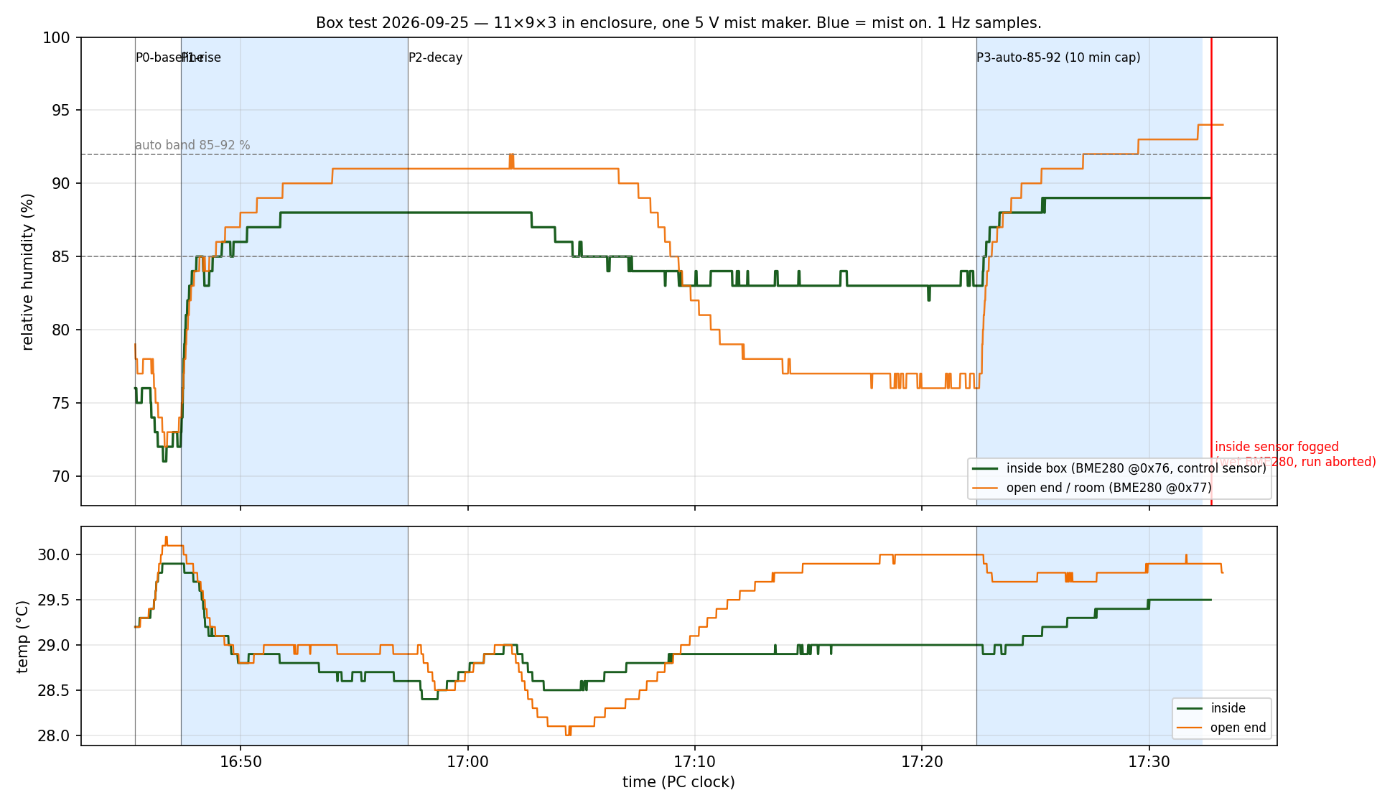
data/box-humidity-2026-09-25.png
