kishorkishor/Terrarium/docs/figures/brain-sim-demo.png

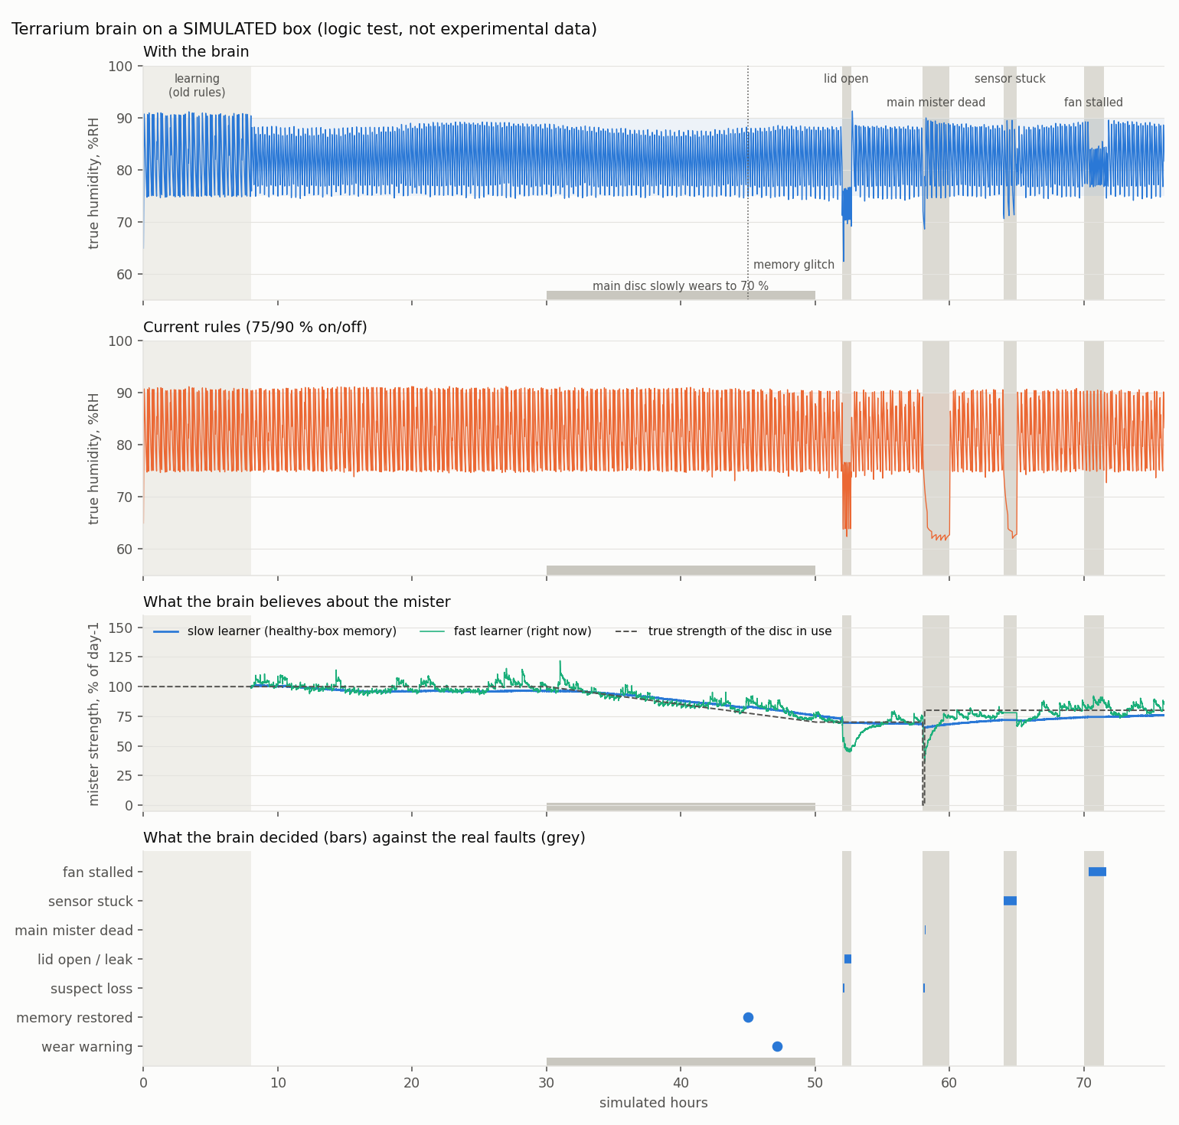
docs/figures/brain-sim-demo.png
