kishorkishor/Terrarium/docs/figures/session-2026-09-26.png

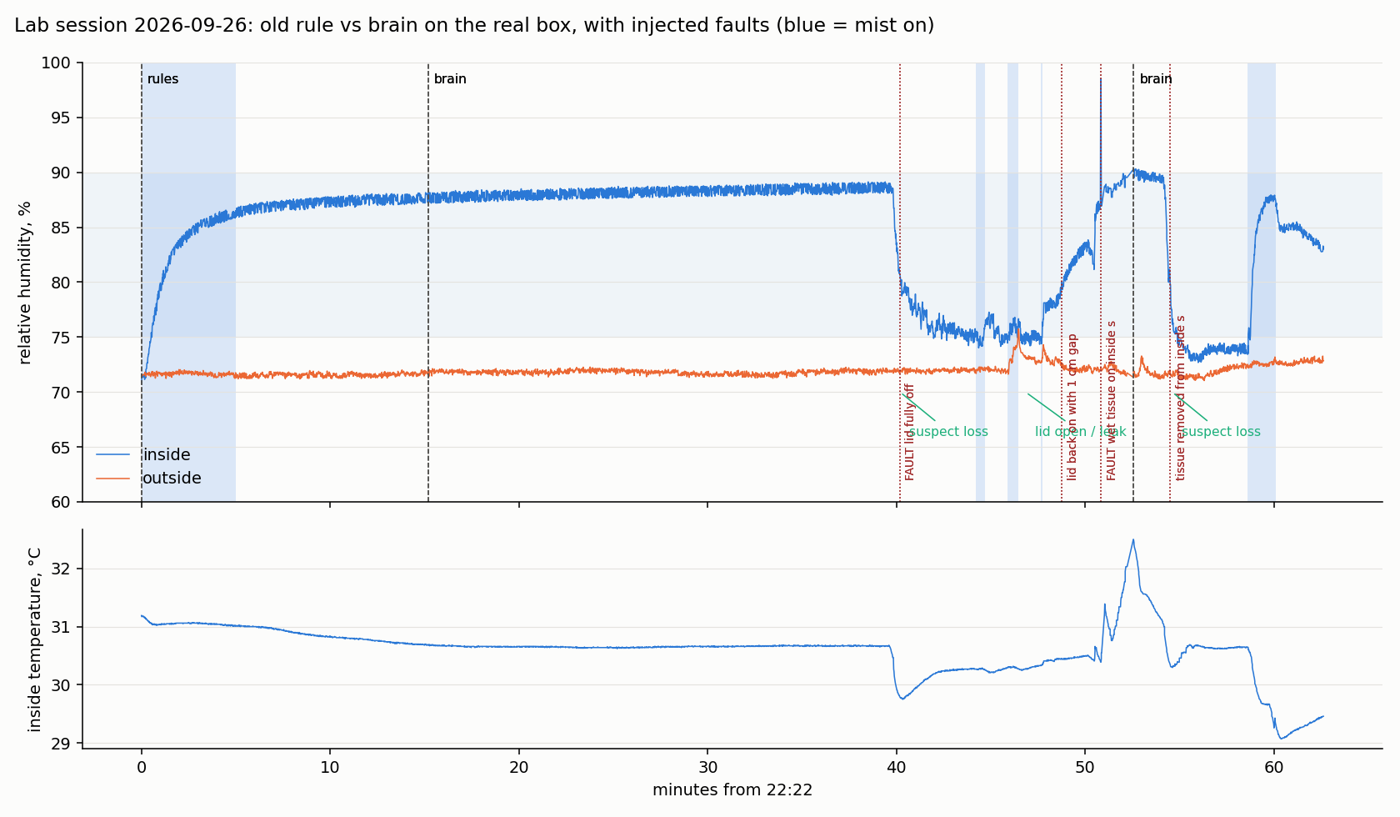
docs/figures/session-2026-09-26.png
