kishorkishor/Terrarium/docs/figures/session-2026-09-27-0055.png

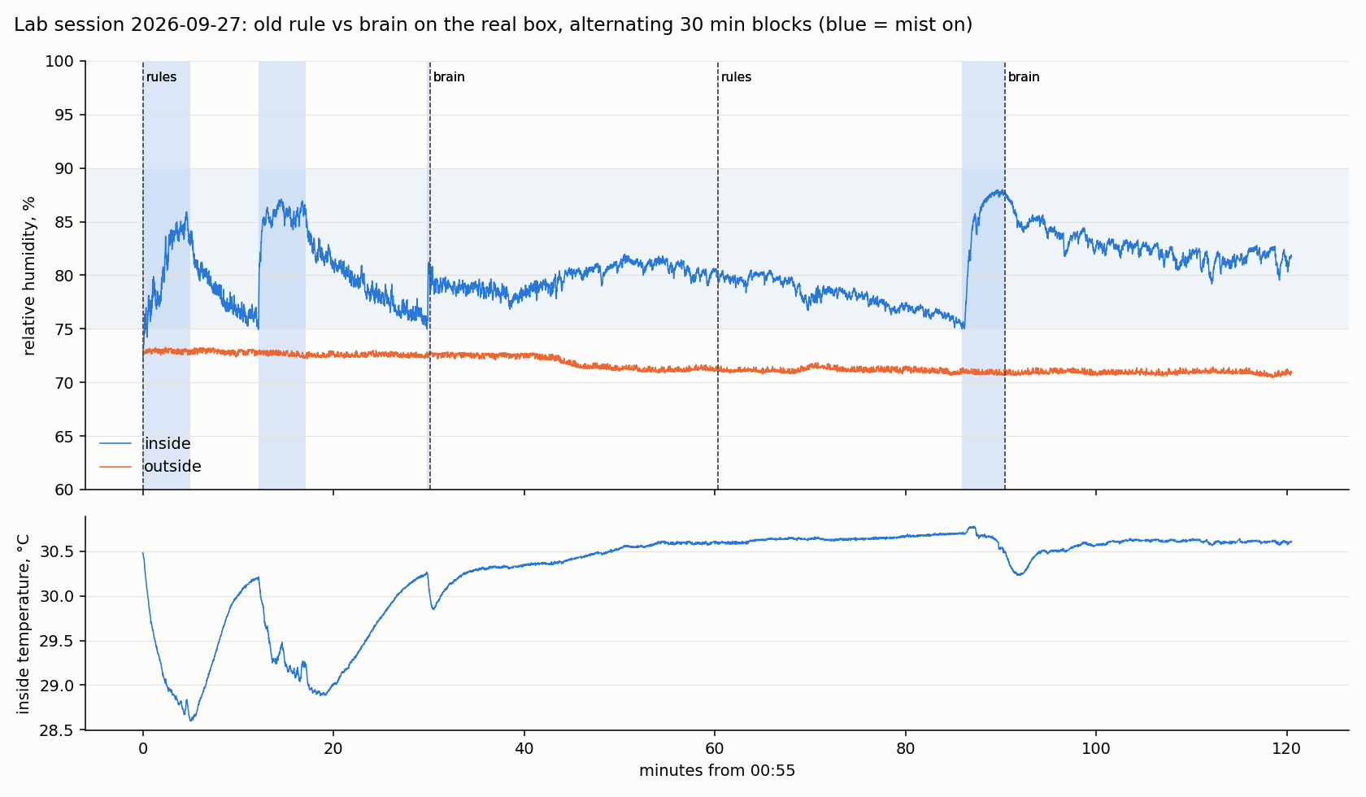
docs/figures/session-2026-09-27-0055.png
