kishorkishor/Terrarium/docs/figures/session-2026-09-27-2003.png

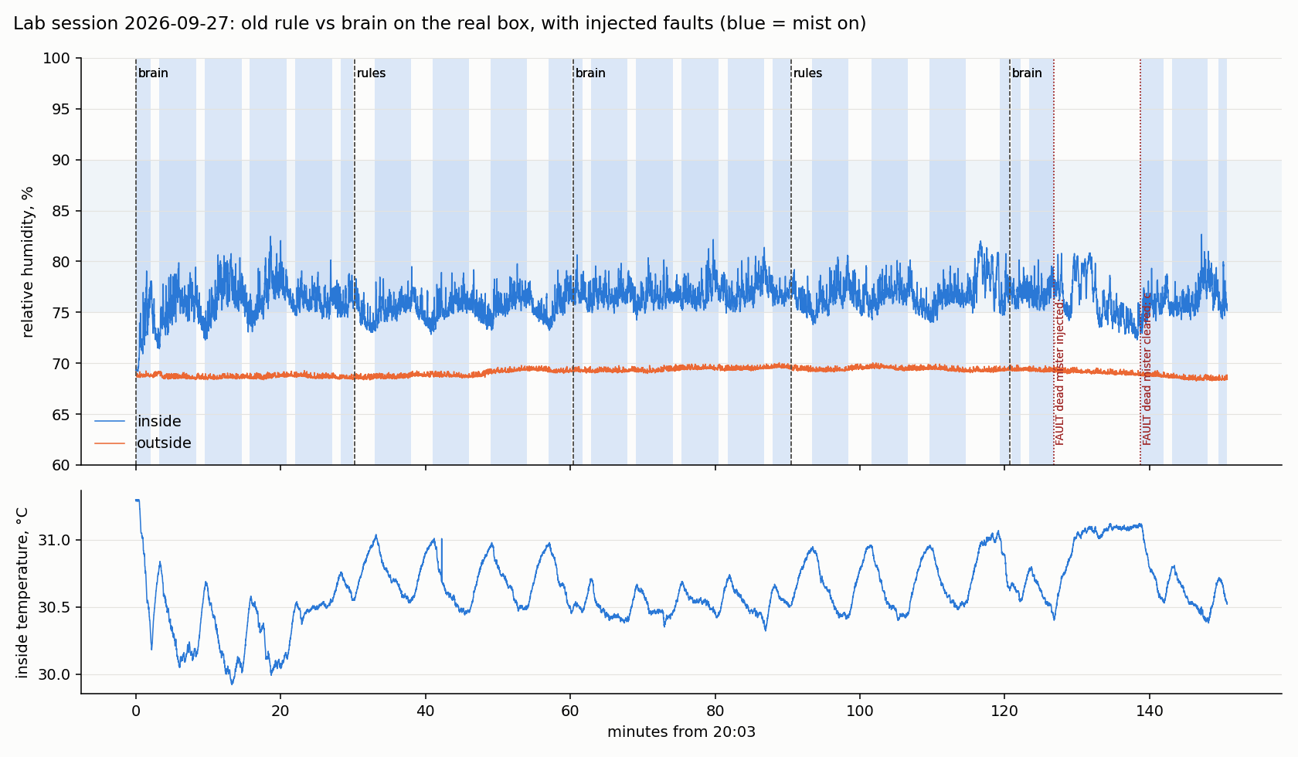
docs/figures/session-2026-09-27-2003.png
