kishorkishor/Terrarium/docs/figures/system-block-diagram.png

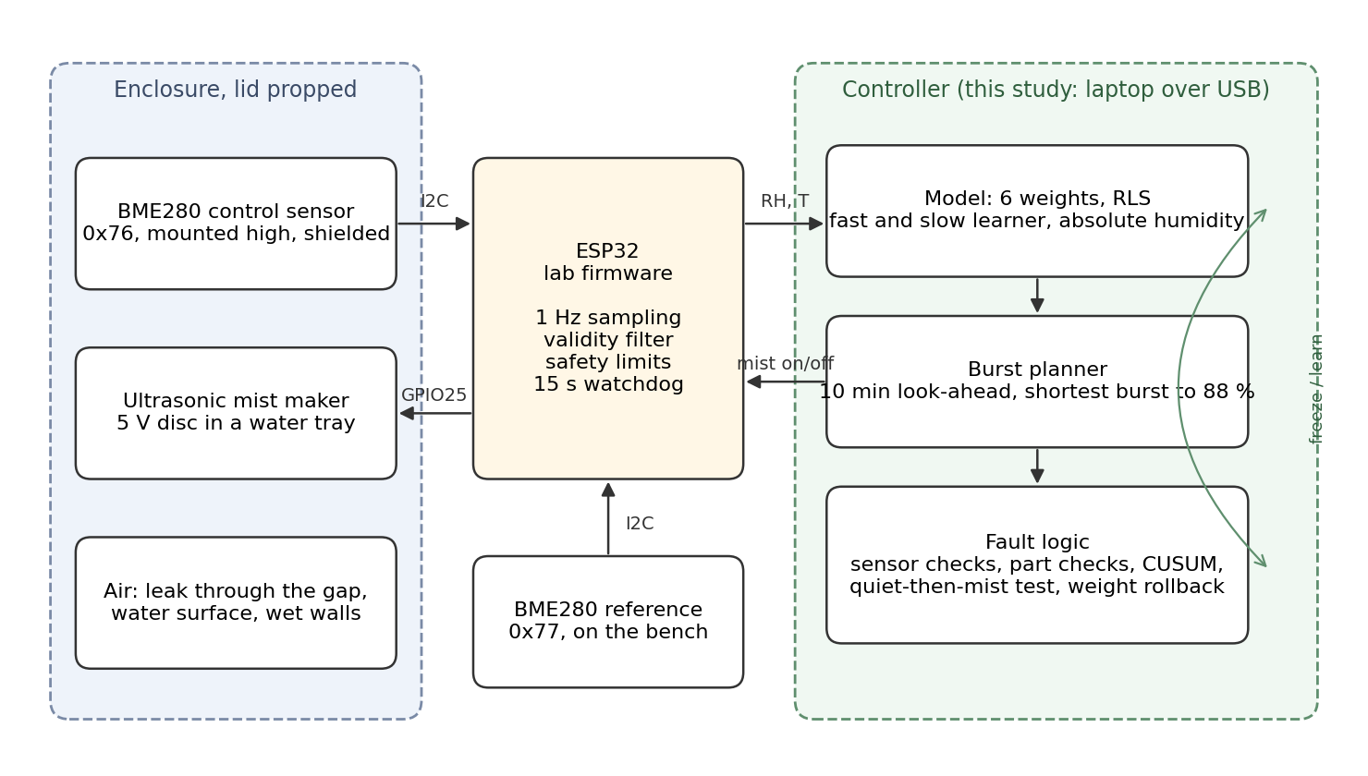
docs/figures/system-block-diagram.png
