kishorkishor/Terrarium/PROJECT/Pasted image 20260730215049.png

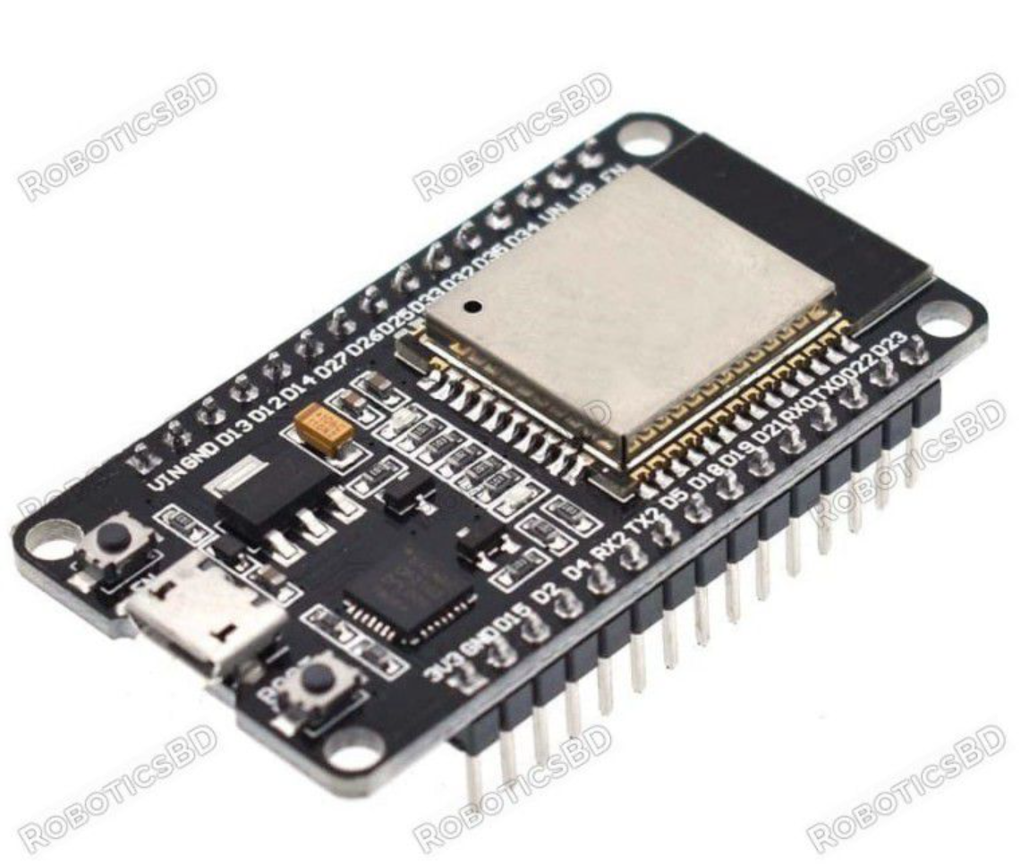
PROJECT/Pasted image 20260730215049.png
