kishorkishor/Terrarium/PROJECT/Pasted image 20260730215133.png

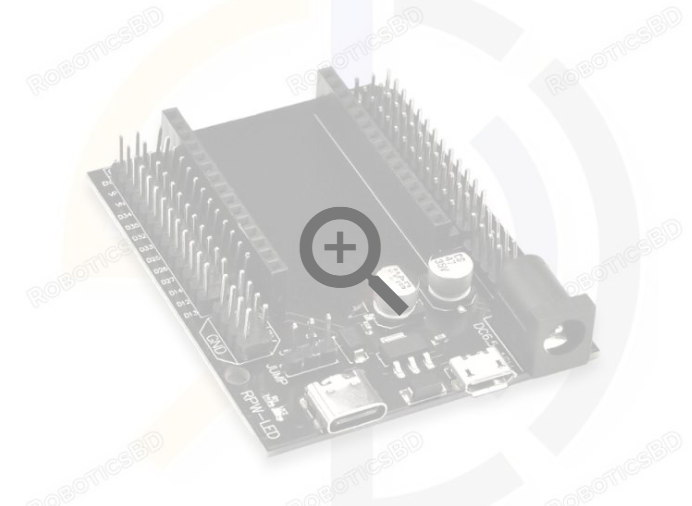
PROJECT/Pasted image 20260730215133.png
