kishorkishor/Terrarium/PROJECT/Pasted image 20260730215155.png

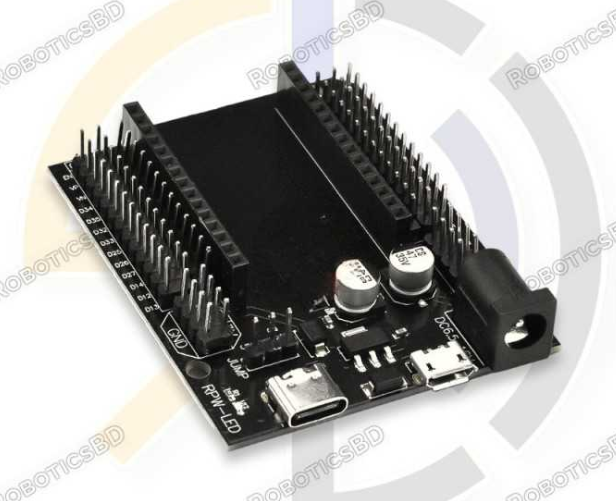
PROJECT/Pasted image 20260730215155.png
