kishorkishor/Terrarium/PROJECT/Pasted image 20260730215815.png

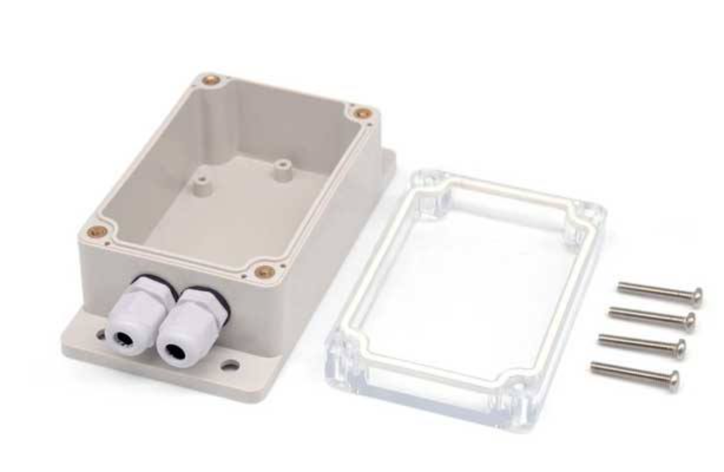
PROJECT/Pasted image 20260730215815.png
