kishorkishor/Terrarium/tools/report/assets/control-flow.png

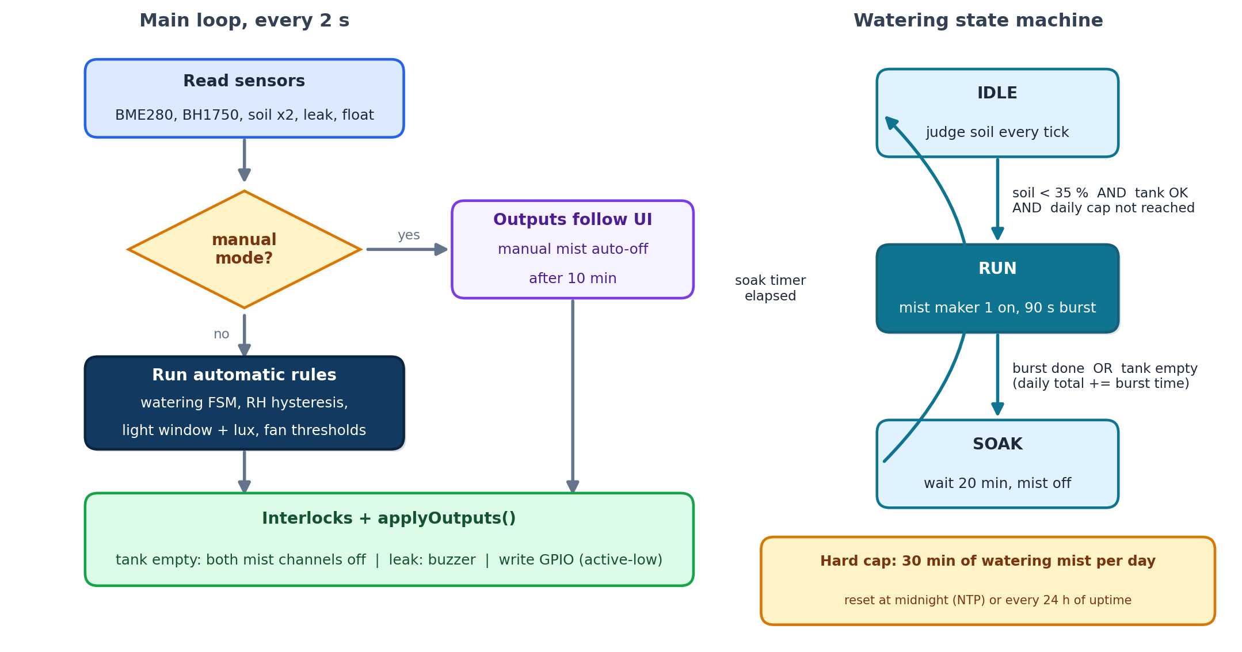
tools/report/assets/control-flow.png
