kishorkishor/Terrarium/tools/report/assets/image1.png

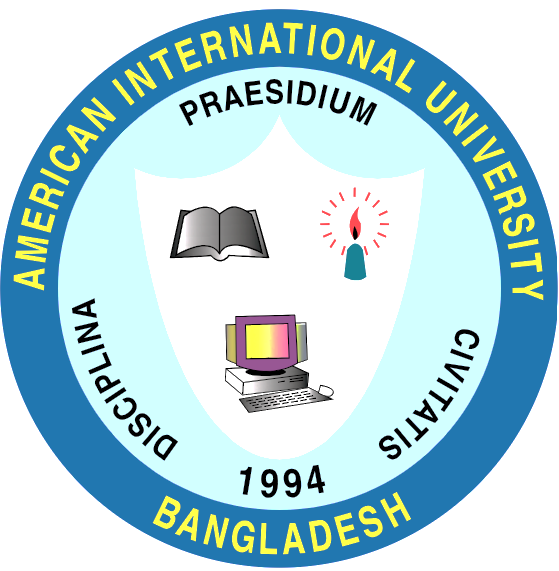
tools/report/assets/image1.png
