kishorkishor/Terrarium/tools/report/assets/software-arch.png

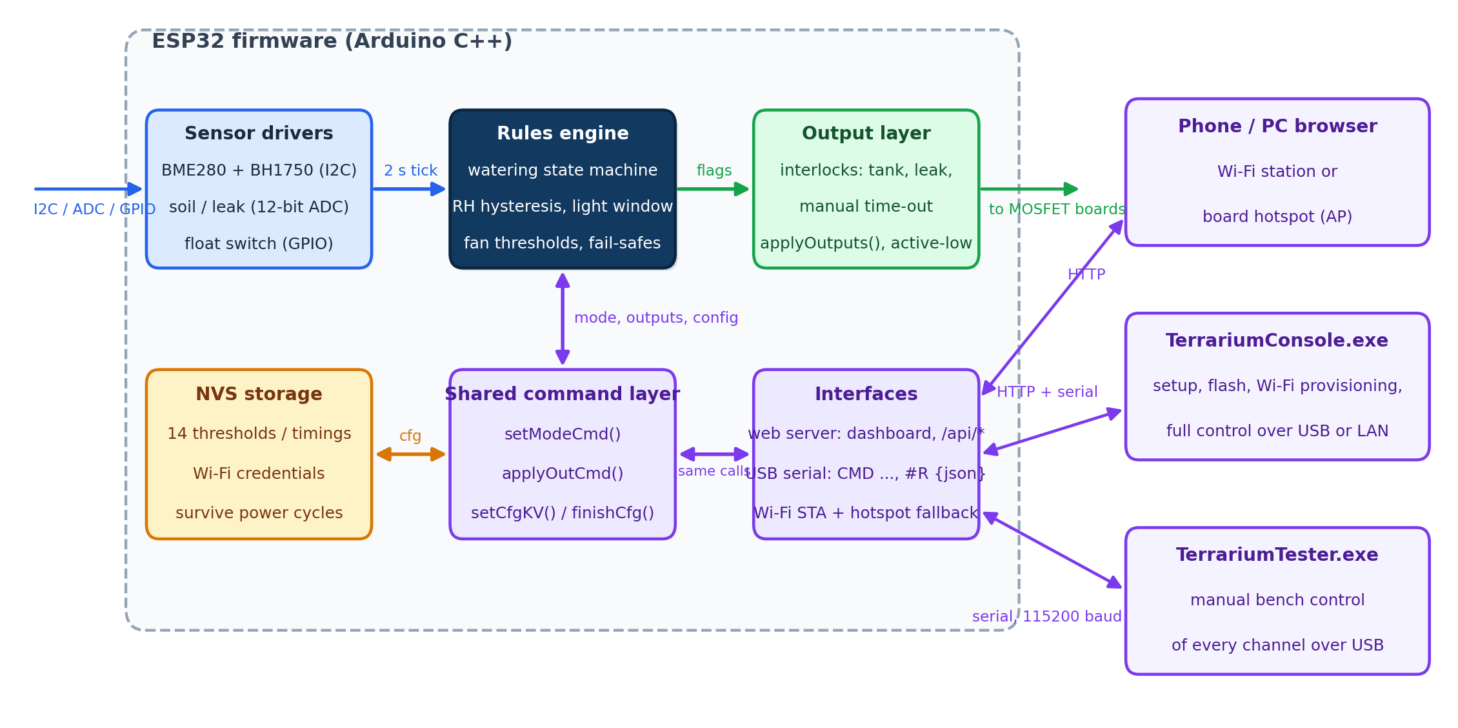
tools/report/assets/software-arch.png
