kishorkishor/Terrarium/PROJECT/KNOWLEDGE/Suppliers & Links.md

---
tags: [terrarium, suppliers]
updated: 2026-08-06
---

# Suppliers & Links

## RoboticsBD — main supplier
House 5, Road 3, Sector 7, Uttara, Dhaka (behind Rajuk Complex, Azampur)
📞 01792 007 004 · ask@roboticsbd.com · bKash/Nagad/COD, 1–3 days

**Final shared cart (354660, ৳9,299):**
[Open cart 354660](https://store.roboticsbd.com/cart-detail?sharedCart=1&cart_id=354660&key=FPatRTd3)
Adjustments before ordering → [[Parts & Cart]]

Every product page below returns HTTP 200 — re-verified 2026-08-09. Click straight through.

**Sensors**
- [ESP32 DevKit V1 CP2102 — 2267](https://store.roboticsbd.com/development-boards/2267-esp32-dev-board-cp2102-robotics-bangladesh.html)
- [GY-BME280 3.3V — 1946](https://store.roboticsbd.com/sensors/1946-gy-bme280-33v-temperature-and-humidity-sensor-robotics-bangladesh.html)
- [BH1750FVI — 429](https://store.roboticsbd.com/sensors/429-bh1750fvi-digital-light-intensity-sensor-robotics-bangladesh.html)
- [Capacitive soil sensor — 1042](https://store.roboticsbd.com/temperature-humidity/1042-capacitive-soil-moisture-sensor-robtoics-bangladesh.html)
- [52mm PP float switch — 1677](https://store.roboticsbd.com/sensors/1677-52mm-pp-liquid-water-level-sensor-horizontal-float-switch-down-robotics-bangladesh.html)
- [Leak sensor, gold-coated — 1935](https://store.roboticsbd.com/sensors/1935-water-level-sensor-gold-coating-robotics-bangladesh.html)

**Actuators & switching**
- [USB mist maker kit — 2426](https://store.roboticsbd.com/arduino-shield/2426-usb-mini-humidifier-mist-maker-and-driver-circuit-board-diy-kits-robotics-bangladesh.html)
- [MOSFET F5305S 4-channel — 2940](https://store.roboticsbd.com/electronics-module/2940-mosfet-f5305s-4-channel-pulse-trigger-switch-controller-robotics-bangladesh.html) ← **buy 2**
- [D4184 MOSFET module — 2757](https://store.roboticsbd.com/electronics-module/2757-d4184-mosfet-control-module-robotics-bangladesh.html) (per-channel alternative)
- [12V 40mm fan — 727](https://store.roboticsbd.com/3d-printer/727-12v-mini-cooling-fan-40x40x10mm-robotics-bangladesh.html)
- [Active buzzer module — 2301](https://store.roboticsbd.com/audio-voice-piezo-buzzer-speech-module/2301-active-buzzer-module-robotics-bangladesh.html)
- [Grow light — Daraz search](https://www.daraz.com.bd/tag/plant-grow-light/) (buy last, after measuring the tank)

**Power chain**
- [12V 5A adapter — 3020](https://store.roboticsbd.com/chargers-balancer/3020-12v-5a-power-supply-adapter-robotics-bangladesh.html)
- [Barrel jack female — 1587](https://store.roboticsbd.com/tools-accessories/1587-barrel-connector-female-robotics-bangladesh.html)
- [BLX-A fuse holder — 2055](https://store.roboticsbd.com/components/2055-blx-a-cover-with-fuse-holder-robotics-bangladesh.html)
- [KCD1-1 illuminated rocker — 4048](https://store.roboticsbd.com/electronic-switches/4048-kcd1-1-bistable-illuminated-rocker-switch-red-1521mm-3pin-robotics-bangladesh.html)
- [LM2596S buck 12V→5V — 2222](https://store.roboticsbd.com/power-module-adapter/2222-lm2596s-dc-dc-24v12v-to-5v-5a-step-down-power-supply-buck-converter-charging-module-robotics-bangladesh.html)
- [1000µF 25V capacitor — 4225](https://store.roboticsbd.com/capacitor/4225-1000uf-25v-capacitor-robotics-bangladesh.html)
- [1N5819 Schottky 40V 1A — 3376](https://store.roboticsbd.com/diode/3376-1n5819-schottky-diode-40v-1a-robotics-bangladesh.html)

**Build materials**
- [Breadboard 830 tie-point — 133](https://store.roboticsbd.com/components/133-breadboard-full-size-bare-830-tie-points-robotics-bangladesh.html)
- [Jumper wires M-F 30cm — 2104](https://store.roboticsbd.com/connector/2104-male-to-female-jumper-wires-40-pin-30cm-robotics-bangladesh.html)
- [Jumper wires M-M 20cm — 31](https://store.roboticsbd.com/robotics-parts/31-3-jumper-wire-40-pcs-set-20cm-robotics-bangladesh.html)
- [Resistor pack (10k) — 245](https://store.roboticsbd.com/components/245-34-resistor-robotics-bangladesh.html#/25-resistor_pack_of_5-10_k)
- [Veroboard line type — 1363](https://store.roboticsbd.com/robotics-parts/1363-veroboard-line-type-robotics-bangladesh.html)
- [Female pin header 2.54mm — 1122](https://store.roboticsbd.com/connector/1122-female-pin-header-254mm-pitch-blue-robotics-bangladesh.html)
- [Screw terminal 2-pin 5mm — 1184](https://store.roboticsbd.com/tools-accessories/1184-2-pin-pitch-50mm-straight-pin-screw-pcb-terminal-block-connector-robotics-bangladesh.html)
- [Heat shrink tube kit — 984](https://store.roboticsbd.com/assorted-kit/984-99--heat-shrink-tube-robotics-bangladesh.html)
- [UT33B+ digital multimeter — 910](https://store.roboticsbd.com/digital-multimeters-roboticsbd/910-ut33b-digital-multimeter-robotics-bangladesh.html)
- [ESP32-CAM + MB shield — 4493](https://store.roboticsbd.com/development-boards/4493-esp32-cam-wifi-bluetooth-development-board-with-mb-programmer-shield-robotics-bangladesh.html) (optional)

## Others
- **TechShopBD** — ESP32 ৳485 alt, resistor/cap/veroboard packs, jumper packs, heat-shrink kit
- **BDTronics** — 24V fogger (upgrade path), ESP32-CAM ৳820 without MB
- **Daraz** — grow light (12V 5050 cool-white strip, ~1m, buy after measuring tank), D20 mist modules ৳170
- **Katabon market** — glass fuses 3A 5×20, 18AWG wire, cheapest passives in person
- **ZerOneTech BD** — has ESP32 ৳650, 12V 5A adapter (PAD007 ৳400), LM2596-with-display (PCM010 ৳450);
  ⚠ their MOSFETs are bare non-logic-level transistors (unusable here), soil SNM047 is resistive (reject),
  no BME280/BH1750

## Counter checks (say these at the shop)
ESP32 shield must say **WROOM-32** · BME280 must be the **3.3V** board · soil must be
**capacitive (solid paddle)** · mist module must **start misting on power, no button** —
test before leaving.

## Learning links
- randomnerdtutorials.com — "ESP32 + <part>" solves ~everything (BME280/BH1750/soil/web server)
- DroneBot Workshop — transistors & MOSFETs (low-side switching)
- Adafruit soldering guide · SparkFun breadboard + multimeter guides

[[Terrarium Hub]]
