kishorkishor/Terrarium/3d/acrylic/acrylic-assembled.stl

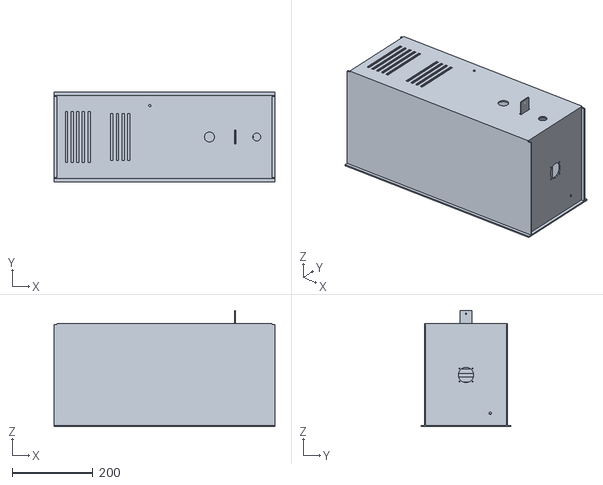
[picture p43: CAD file, 2026-09-18]
3d/acrylic/acrylic-assembled.stl
548.0 x 222.0 x 288.0
