kishorkishor/Terrarium/3d/onshape-import/0_WHOLE_BOX_assembled.stl

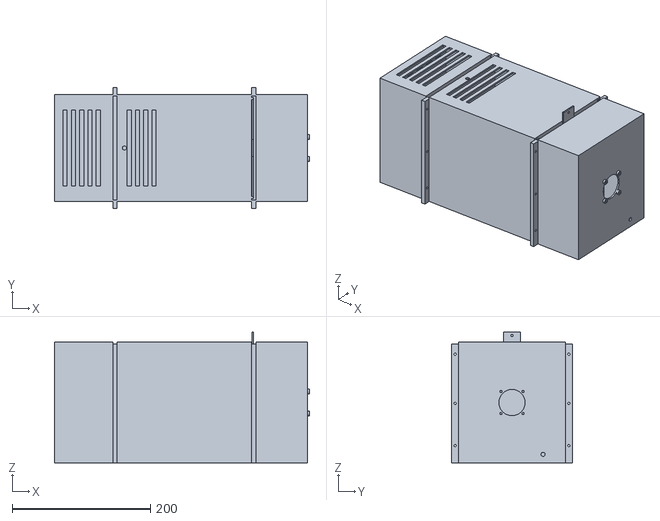
[picture p44: CAD file, 2026-09-18]
3d/onshape-import/0_WHOLE_BOX_assembled.stl
369.4 x 174.8 x 189.4
