kishorkishor/Terrarium/3d/acrylic/cut-files/sheet_A_3mm.dxf

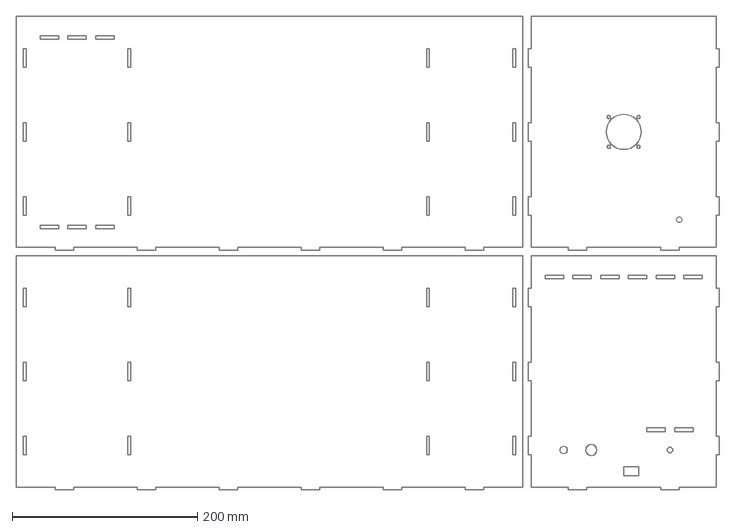
[picture p45: CAD file, 2026-09-18]
3d/acrylic/cut-files/sheet_A_3mm.dxf
760.0 x 512.0 mm
