kishorkishor/Terrarium/3d/acrylic/onshape-dxf-per-part/end_electronics.dxf

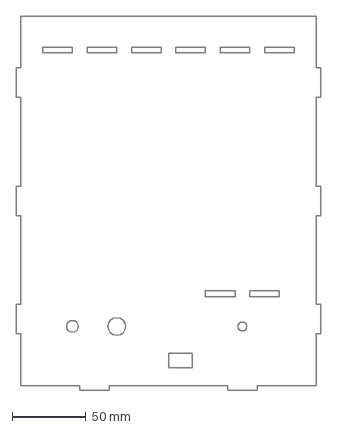
[picture p46: CAD file, 2026-09-18]
3d/acrylic/onshape-dxf-per-part/end_electronics.dxf
206.0 x 253.0 mm
