kishorkishor/Terrarium/3d/fan_duct.stl

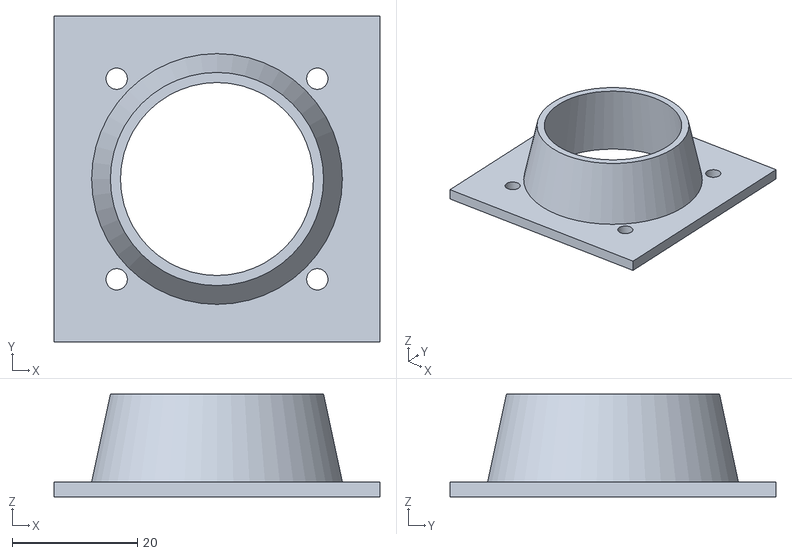
[picture p47: CAD file, 2026-08-25]
3d/fan_duct.stl
52.0 x 52.0 x 16.4
