kishorkishor/Terrarium/3d/acrylic/cut-files/sheet_C_2mm.dxf

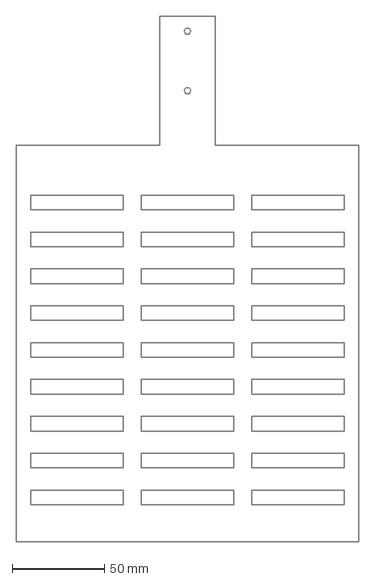
[picture p48: CAD file, 2026-09-18]
3d/acrylic/cut-files/sheet_C_2mm.dxf
186.0 x 285.0 mm
