kishorkishor/Terrarium/3d/acrylic/onshape-dxf-per-part/back.dxf

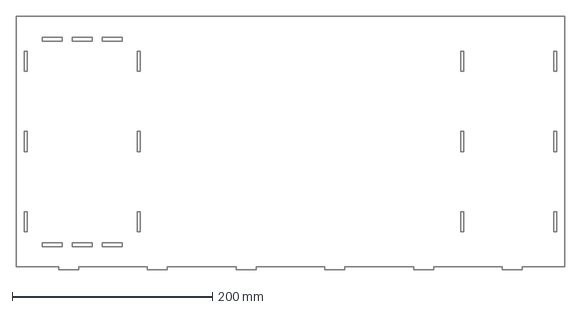
[picture p49: CAD file, 2026-09-18]
3d/acrylic/onshape-dxf-per-part/back.dxf
548.0 x 253.0 mm
