kishorkishor/Terrarium/3d/light_rail.stl

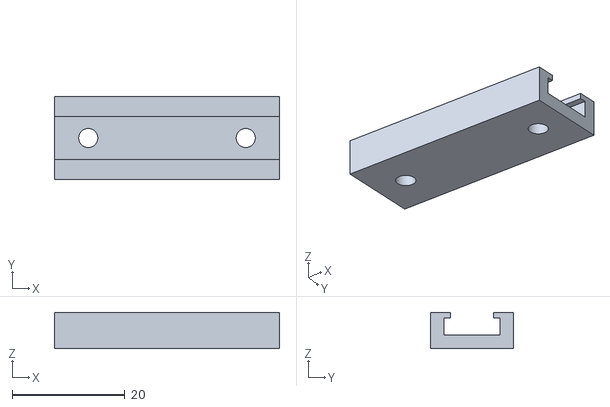
[picture p50: CAD file, 2026-08-25]
3d/light_rail.stl
40.0 x 14.8 x 6.40
