kishorkishor/Terrarium/3d/onshape-import/6_terrarium_lid.stl

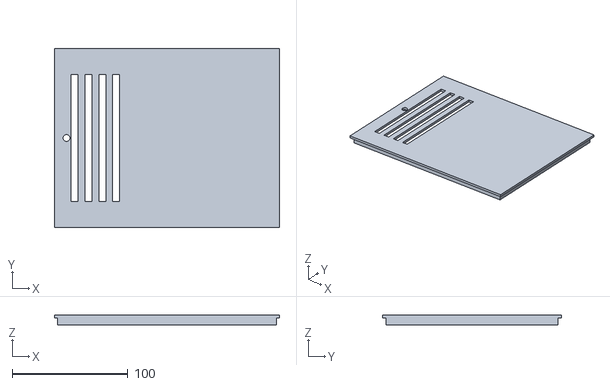
[picture p51: CAD file, 2026-09-17]
3d/onshape-import/6_terrarium_lid.stl
194.8 x 154.8 x 8.40
