kishorkishor/Terrarium/3d/acrylic/cut-files/sheet_B_3mm.dxf

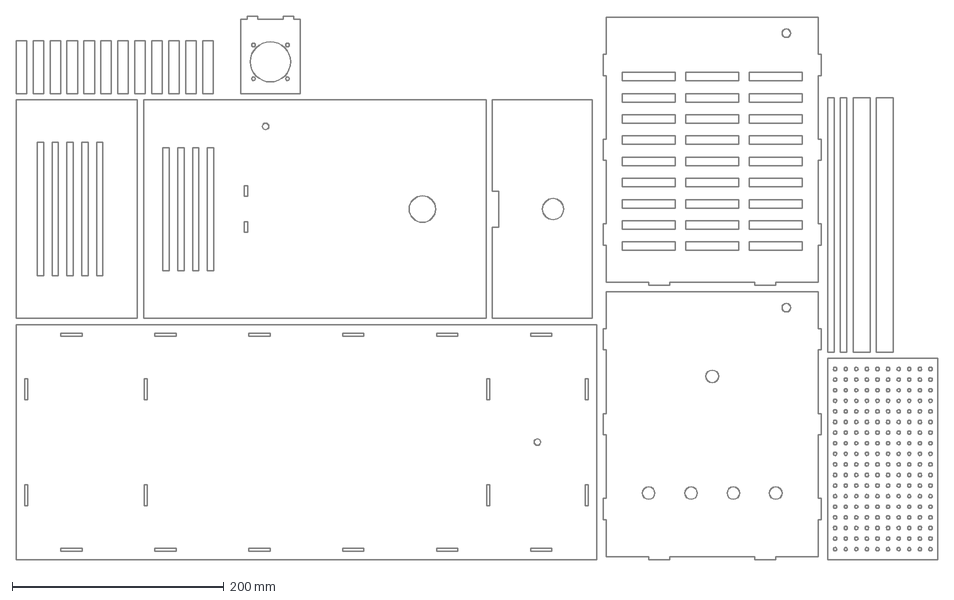
[picture p52: CAD file, 2026-09-18]
3d/acrylic/cut-files/sheet_B_3mm.dxf
870.0 x 513.0 mm
