kishorkishor/Terrarium/3d/acrylic/onshape-dxf-per-part/divider_solid.dxf

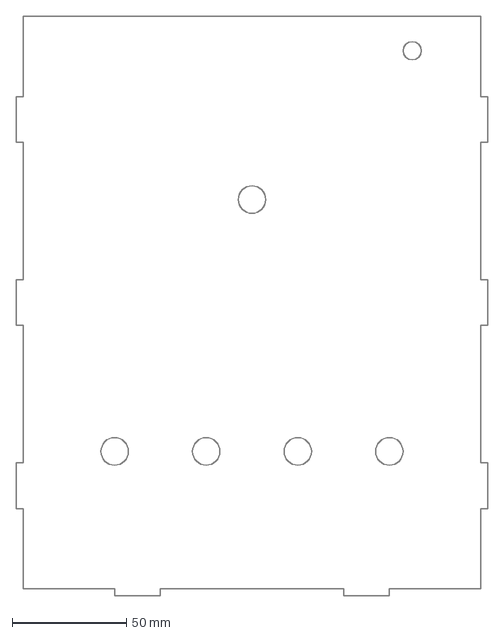
[picture p53: CAD file, 2026-09-18]
3d/acrylic/onshape-dxf-per-part/divider_solid.dxf
206.0 x 253.0 mm
