kishorkishor/Terrarium/3d/fan_module.stl

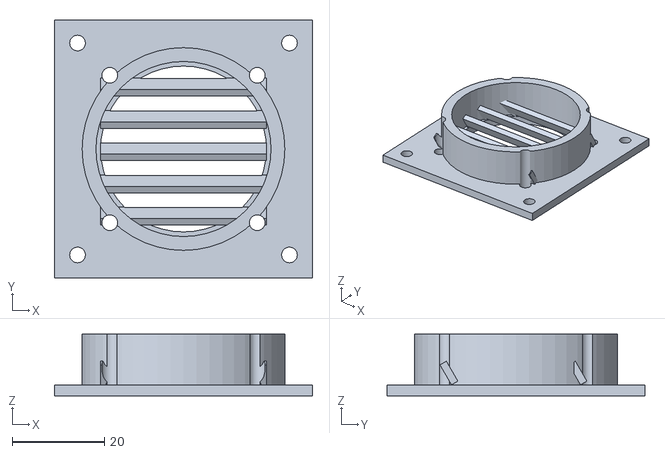
[picture p54: CAD file, 2026-08-25]
3d/fan_module.stl
56.0 x 56.0 x 13.4
