kishorkishor/Terrarium/3d/onshape-import/4_damper_plate.stl

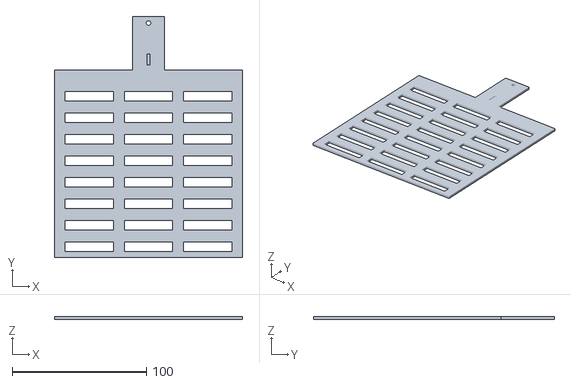
[picture p55: CAD file, 2026-09-17]
3d/onshape-import/4_damper_plate.stl
140.0 x 179.4 x 2.00
