kishorkishor/Terrarium/3d/acrylic/onshape-dxf-per-part/electronics_tray.dxf

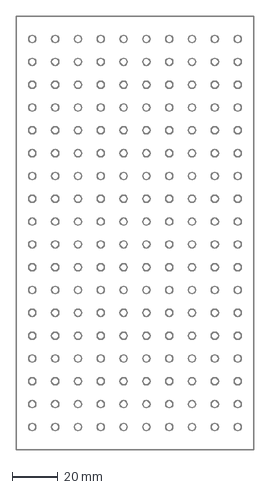
[picture p56: CAD file, 2026-09-18]
3d/acrylic/onshape-dxf-per-part/electronics_tray.dxf
104.0 x 190.0 mm
