kishorkishor/Terrarium/3d/disc_holder.stl

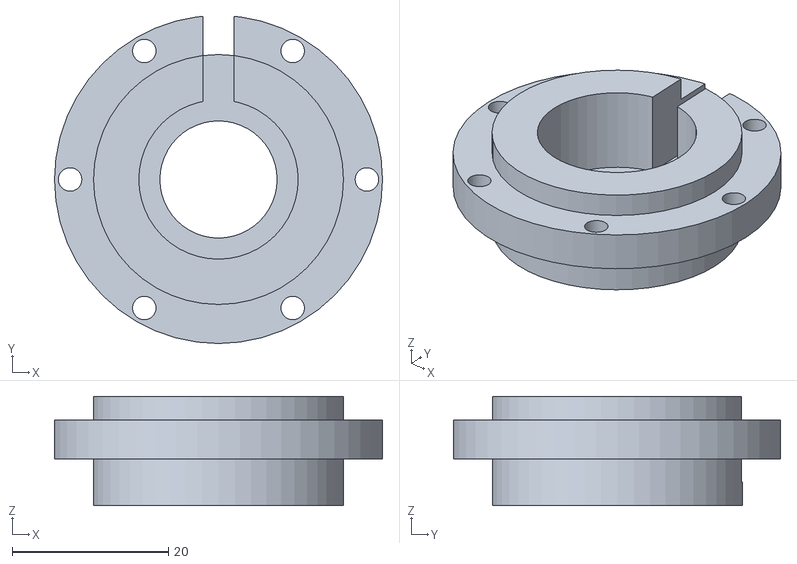
[picture p57: CAD file, 2026-08-25]
3d/disc_holder.stl
42.0 x 41.9 x 14.0
