kishorkishor/Terrarium/3d/onshape-import/5_electronics_lid.stl

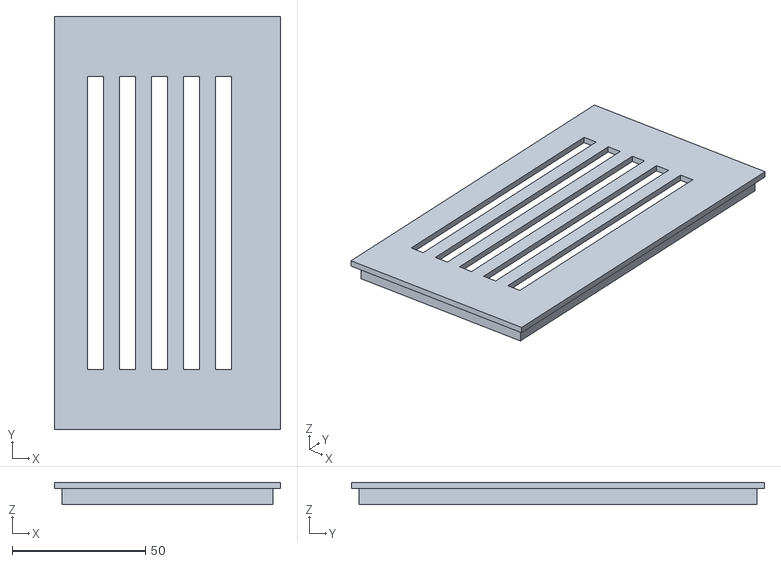
[picture p58: CAD file, 2026-09-17]
3d/onshape-import/5_electronics_lid.stl
84.8 x 154.8 x 8.40
