kishorkishor/Terrarium/3d/acrylic/onshape-dxf-per-part/fan_bracket.dxf

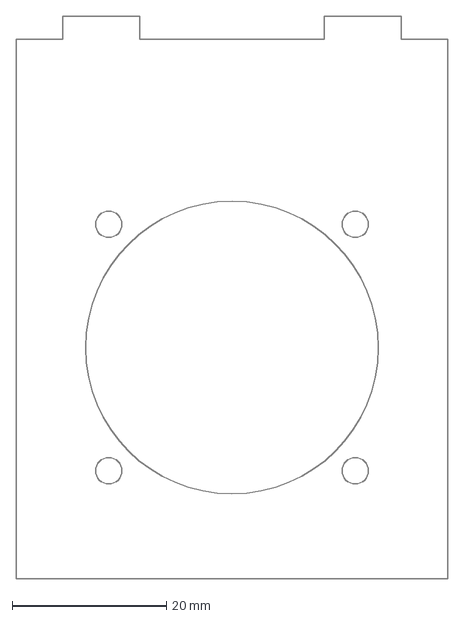
[picture p59: CAD file, 2026-09-18]
3d/acrylic/onshape-dxf-per-part/fan_bracket.dxf
56.0 x 73.0 mm
