kishorkishor/Terrarium/3d/onshape-import/1_electronics_bay.stl

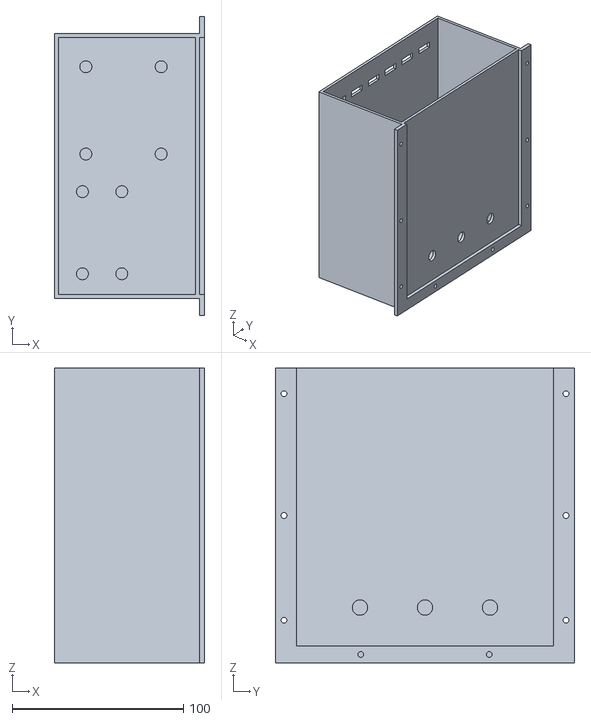
[picture p60: CAD file, 2026-09-17]
3d/onshape-import/1_electronics_bay.stl
87.8 x 174.8 x 172.4
