kishorkishor/Terrarium/3d/sensor_shield.stl

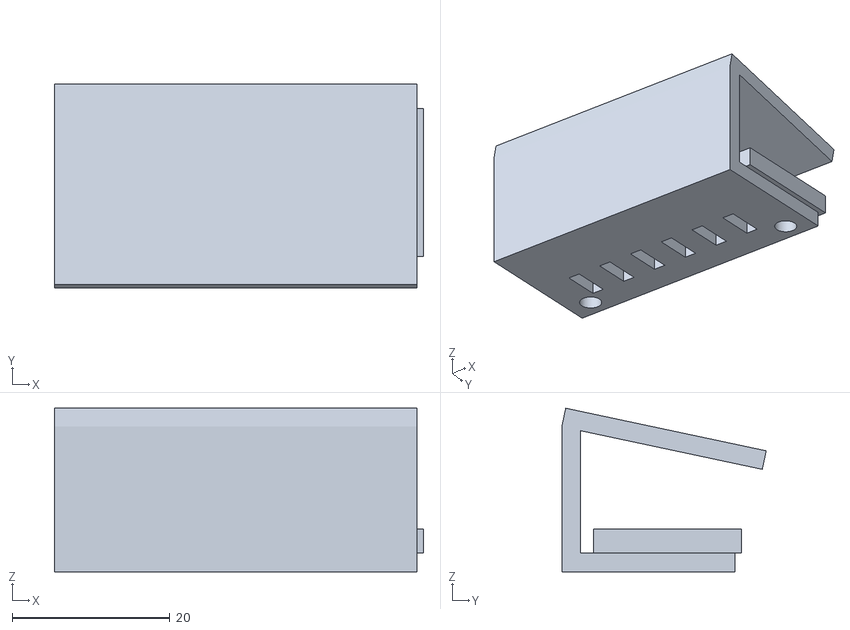
[picture p61: CAD file, 2026-08-25]
3d/sensor_shield.stl
46.8 x 25.9 x 20.7
