kishorkishor/Terrarium/3d/acrylic/onshape-dxf-per-part/lid_air.dxf

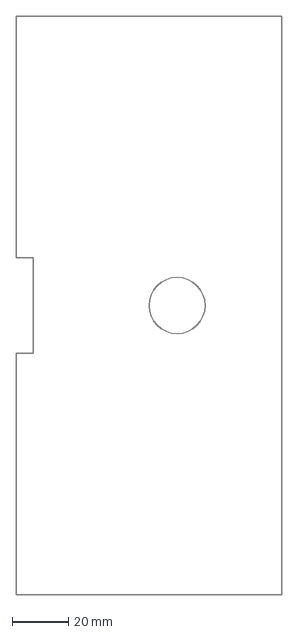
[picture p62: CAD file, 2026-09-18]
3d/acrylic/onshape-dxf-per-part/lid_air.dxf
94.5 x 206.0 mm
