kishorkishor/Terrarium/3d/onshape-import/3_air_bay.stl

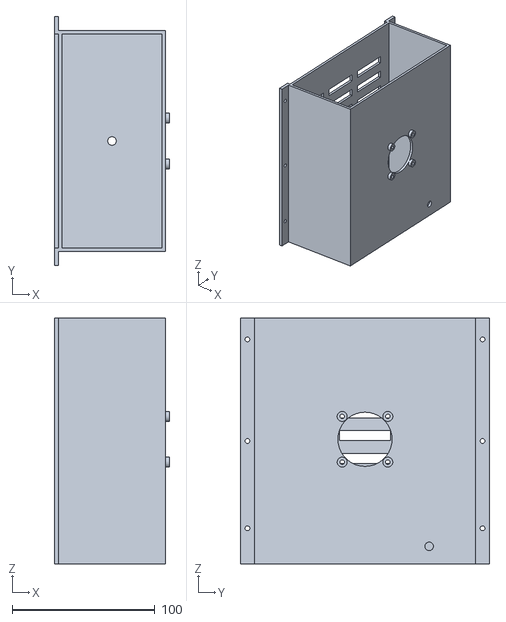
[picture p63: CAD file, 2026-09-17]
3d/onshape-import/3_air_bay.stl
80.8 x 174.8 x 172.4
