kishorkishor/Terrarium/3d/soil_collar.stl

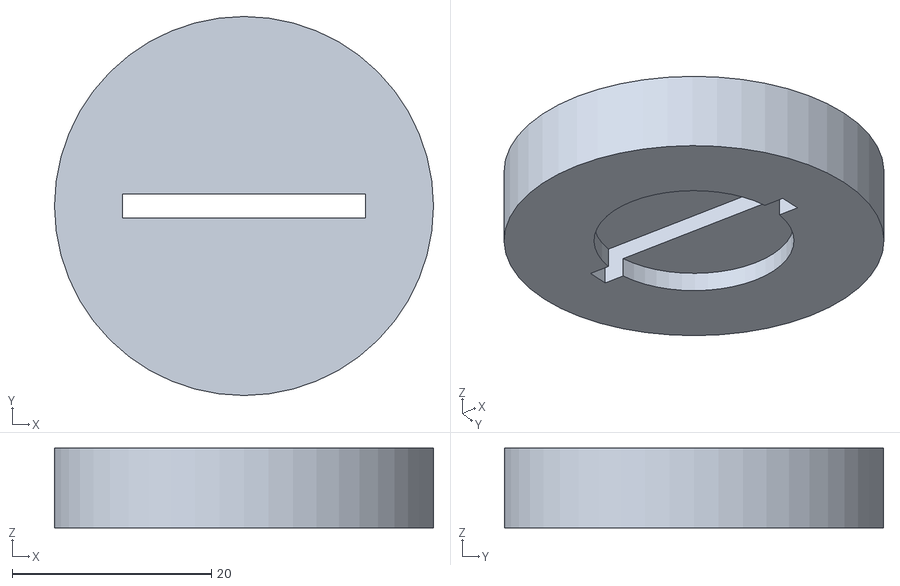
[picture p64: CAD file, 2026-08-25]
3d/soil_collar.stl
38.0 x 38.0 x 8.00
