kishorkishor/Terrarium/3d/acrylic/onshape-dxf-per-part/guide_cover_1.dxf

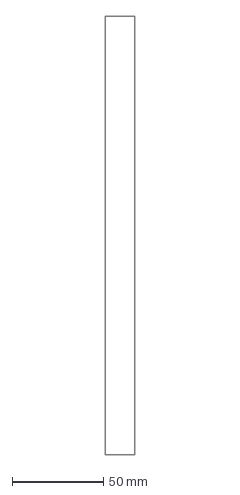
[picture p65: CAD file, 2026-09-18]
3d/acrylic/onshape-dxf-per-part/guide_cover_1.dxf
16.0 x 240.0 mm
