kishorkishor/Terrarium/3d/grommet.stl

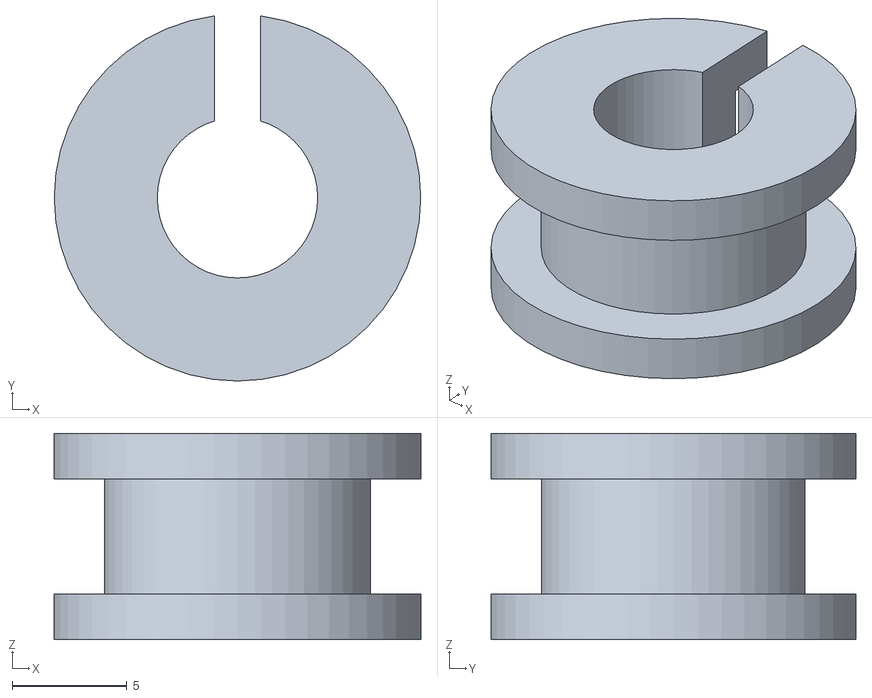
[picture p66: CAD file, 2026-08-25]
3d/grommet.stl
16.0 x 15.9 x 9.00
