kishorkishor/Terrarium/3d/onshape-import/7_air_lid.stl

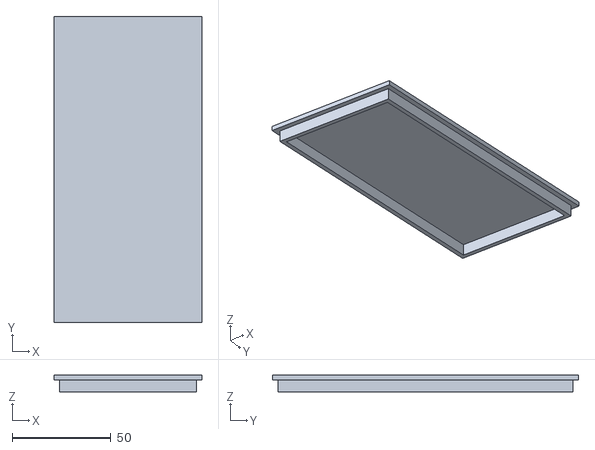
[picture p67: CAD file, 2026-09-17]
3d/onshape-import/7_air_lid.stl
74.8 x 154.8 x 8.40
