kishorkishor/Terrarium/3d/acrylic/onshape-dxf-per-part/divider_damper.dxf

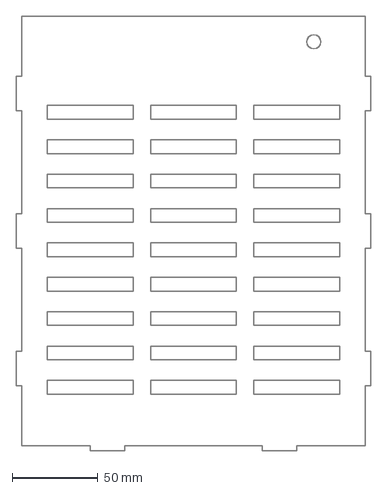
[picture p68: CAD file, 2026-09-18]
3d/acrylic/onshape-dxf-per-part/divider_damper.dxf
206.0 x 253.0 mm
