kishorkishor/Terrarium/3d/lid.stl

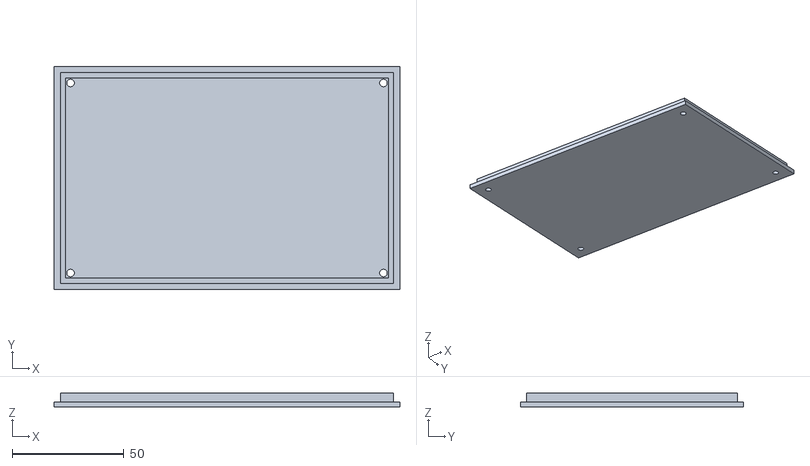
[picture p69: CAD file, 2026-08-25]
3d/lid.stl
154.8 x 99.8 x 6.40
