kishorkishor/Terrarium/3d/onshape-import/2_terrarium_bay.stl

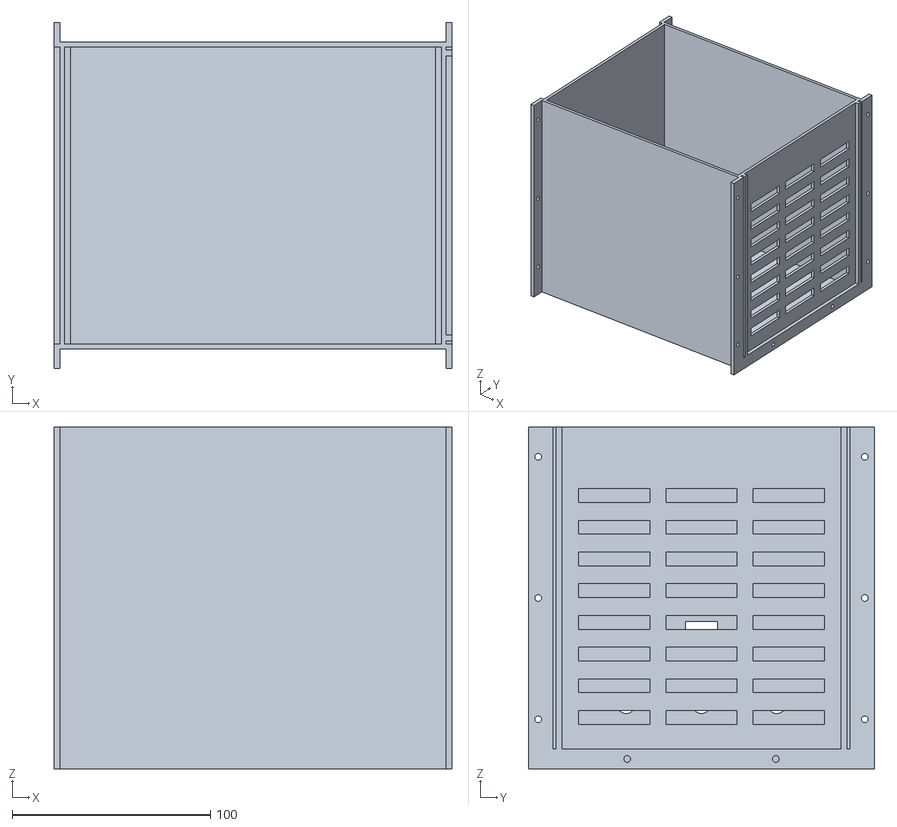
[picture p70: CAD file, 2026-09-17]
3d/onshape-import/2_terrarium_bay.stl
200.8 x 174.8 x 172.4
