kishorkishor/Terrarium/3d/acrylic/onshape-dxf-per-part/lid_electronics.dxf

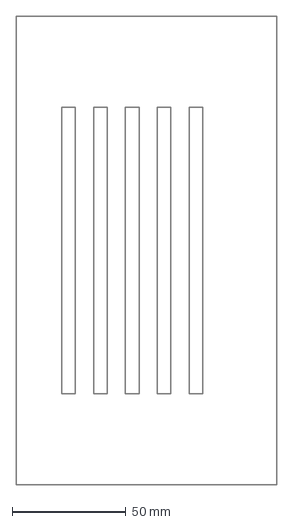
[picture p71: CAD file, 2026-09-18]
3d/acrylic/onshape-dxf-per-part/lid_electronics.dxf
114.5 x 206.0 mm
