kishorkishor/Terrarium/3d/canopy_corner.stl

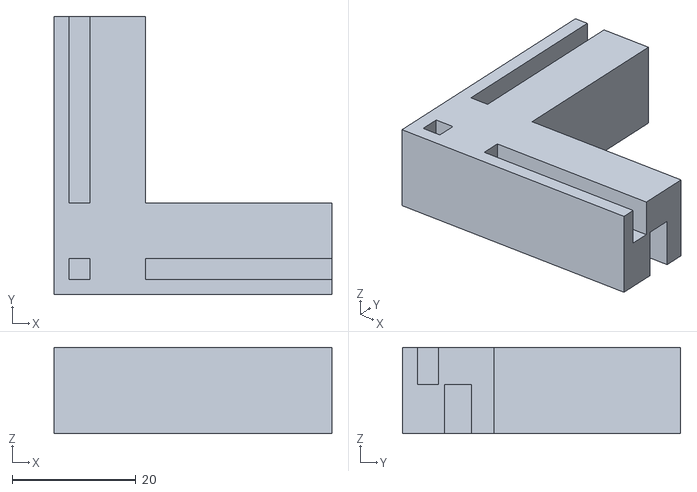
[picture p72: CAD file, 2026-08-25]
3d/canopy_corner.stl
45.0 x 45.0 x 14.0
