kishorkishor/Terrarium/3d/acrylic/onshape-dxf-per-part/lid_terrarium.dxf

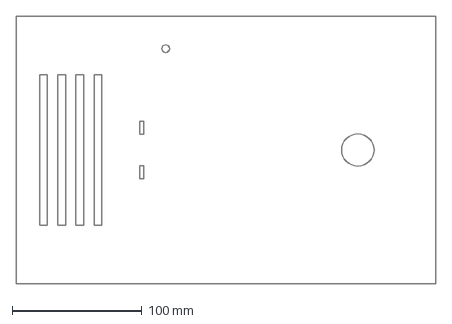
[picture p73: CAD file, 2026-09-18]
3d/acrylic/onshape-dxf-per-part/lid_terrarium.dxf
323.0 x 206.0 mm
