kishorkishor/Terrarium/3d/box.stl

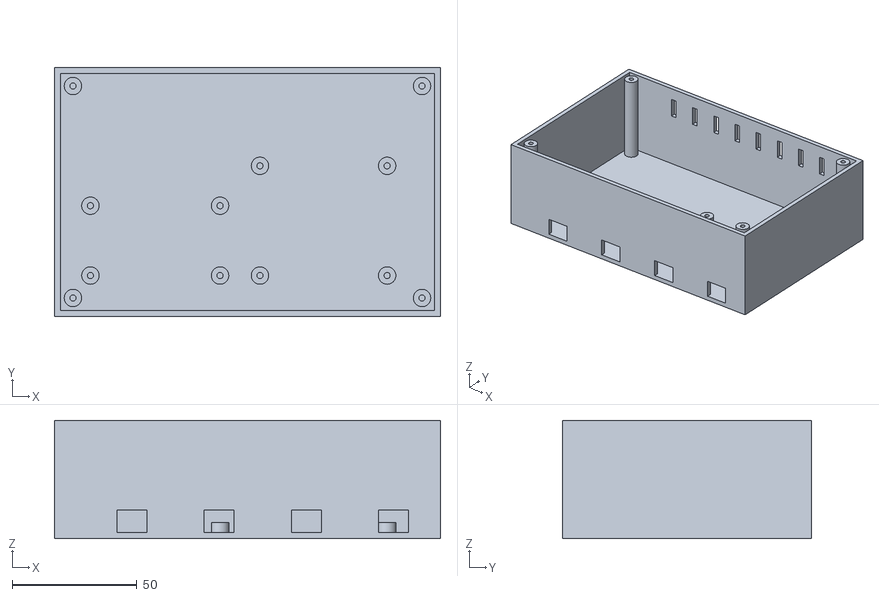
[picture p74: CAD file, 2026-08-25]
3d/box.stl
154.8 x 99.8 x 47.4
