kishorkishor/Terrarium/3d/acrylic/onshape-dxf-per-part/base.dxf

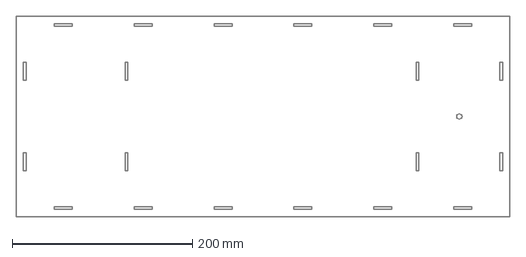
[picture p75: CAD file, 2026-09-18]
3d/acrylic/onshape-dxf-per-part/base.dxf
548.0 x 222.0 mm
