kishorkishor/Terrarium/3d/divider.stl

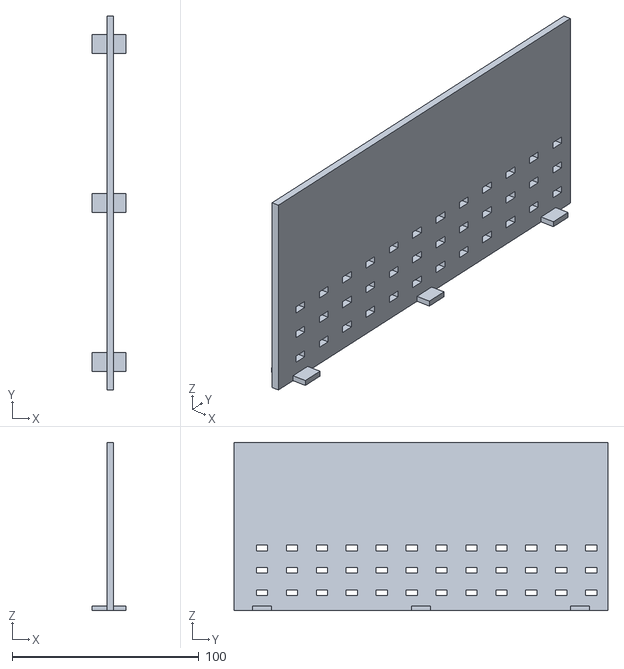
[picture p76: CAD file, 2026-08-25]
3d/divider.stl
18.0 x 200.0 x 90.0
