kishorkishor/Terrarium/3d/acrylic/onshape-dxf-per-part/end_fan.dxf

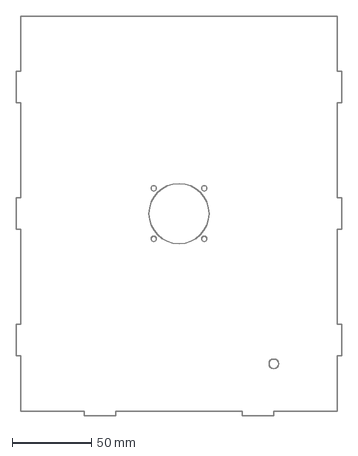
[picture p77: CAD file, 2026-09-18]
3d/acrylic/onshape-dxf-per-part/end_fan.dxf
206.0 x 253.0 mm
