kishorkishor/Terrarium/3d/canopy_rail.stl

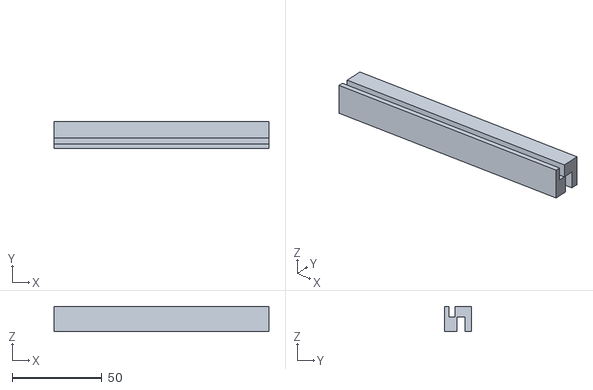
[picture p78: CAD file, 2026-08-25]
3d/canopy_rail.stl
120.0 x 14.8 x 14.0
