kishorkishor/Terrarium/3d/acrylic/onshape-dxf-per-part/lid_locator_01.dxf

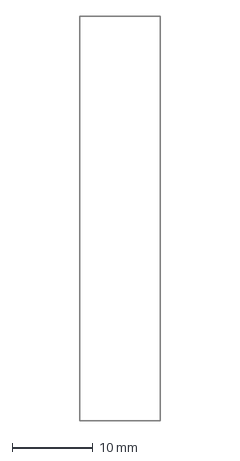
[picture p80: CAD file, 2026-09-18]
3d/acrylic/onshape-dxf-per-part/lid_locator_01.dxf
10.0 x 50.0 mm
