kishorkishor/Terrarium/3d/acrylic/onshape-dxf-per-part/guide_spacer_1.dxf

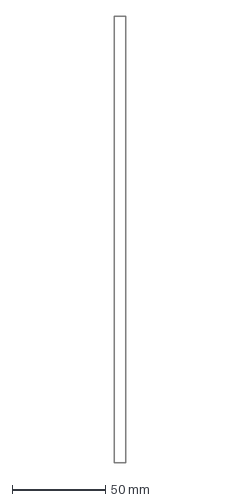
[picture p81: CAD file, 2026-09-18]
3d/acrylic/onshape-dxf-per-part/guide_spacer_1.dxf
6.00 x 240.0 mm
