kishorkishor/Terrarium/3d/acrylic/onshape-dxf-per-part/damper_plate.dxf

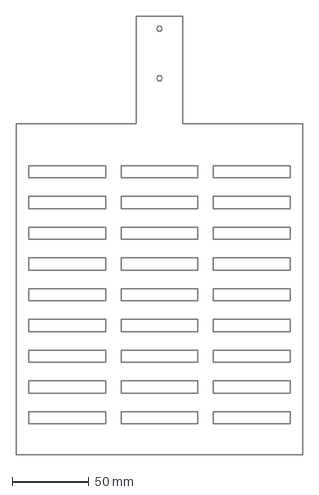
[picture p82: CAD file, 2026-09-18]
3d/acrylic/onshape-dxf-per-part/damper_plate.dxf
186.0 x 285.0 mm
