kishorkishor/Terrarium/3d/acrylic/acrylic-assembly.scad

// generated by make_acrylic.py - do not edit, change the script instead
EXPLODE = 0;   // 0 = assembled, 1 = lids and damper lifted
A = 0.45;        // see-through preview
module base() { linear_extrude(3.0) difference() { polygon([[0.000,0.000],[548.000,0.000],[548.000,222.000],[0.000,222.000]]);
  translate([42.333,8.000]) square([20.000,3.000]);
  translate([42.333,211.000]) square([20.000,3.000]);
  translate([131.000,8.000]) square([20.000,3.000]);
  translate([131.000,211.000]) square([20.000,3.000]);
  translate([219.667,8.000]) square([20.000,3.000]);
  translate([219.667,211.000]) square([20.000,3.000]);
  translate([308.333,8.000]) square([20.000,3.000]);
  translate([308.333,211.000]) square([20.000,3.000]);
  translate([397.000,8.000]) square([20.000,3.000]);
  translate([397.000,211.000]) square([20.000,3.000]);
  translate([485.667,8.000]) square([20.000,3.000]);
  translate([485.667,211.000]) square([20.000,3.000]);
  translate([8.000,51.000]) square([3.000,20.000]);
  translate([8.000,151.000]) square([3.000,20.000]);
  translate([121.000,51.000]) square([3.000,20.000]);
  translate([121.000,151.000]) square([3.000,20.000]);
  translate([444.000,51.000]) square([3.000,20.000]);
  translate([444.000,151.000]) square([3.000,20.000]);
  translate([537.000,51.000]) square([3.000,20.000]);
  translate([537.000,151.000]) square([3.000,20.000]);
  translate([492.000,111.000]) circle(d=6.000, $fn=32);
} }
module front() { linear_extrude(3.0) difference() { polygon([[0.000,0.000],[42.333,0.000],[42.333,-3.000],[62.333,-3.000],[62.333,0.000],[131.000,0.000],[131.000,-3.000],[151.000,-3.000],[151.000,0.000],[219.667,0.000],[219.667,-3.000],[239.667,-3.000],[239.667,0.000],[308.333,0.000],[308.333,-3.000],[328.333,-3.000],[328.333,0.000],[397.000,0.000],[397.000,-3.000],[417.000,-3.000],[417.000,0.000],[485.667,0.000],[485.667,-3.000],[505.667,-3.000],[505.667,0.000],[548.000,0.000],[548.000,250.000],[0.000,250.000]]);
  translate([8.000,35.000]) square([3.000,20.000]);
  translate([8.000,115.000]) square([3.000,20.000]);
  translate([8.000,195.000]) square([3.000,20.000]);
  translate([121.000,35.000]) square([3.000,20.000]);
  translate([121.000,115.000]) square([3.000,20.000]);
  translate([121.000,195.000]) square([3.000,20.000]);
  translate([444.000,35.000]) square([3.000,20.000]);
  translate([444.000,115.000]) square([3.000,20.000]);
  translate([444.000,195.000]) square([3.000,20.000]);
  translate([537.000,35.000]) square([3.000,20.000]);
  translate([537.000,115.000]) square([3.000,20.000]);
  translate([537.000,195.000]) square([3.000,20.000]);
} }
module back() { linear_extrude(3.0) difference() { polygon([[0.000,0.000],[42.333,0.000],[42.333,-3.000],[62.333,-3.000],[62.333,0.000],[131.000,0.000],[131.000,-3.000],[151.000,-3.000],[151.000,0.000],[219.667,0.000],[219.667,-3.000],[239.667,-3.000],[239.667,0.000],[308.333,0.000],[308.333,-3.000],[328.333,-3.000],[328.333,0.000],[397.000,0.000],[397.000,-3.000],[417.000,-3.000],[417.000,0.000],[485.667,0.000],[485.667,-3.000],[505.667,-3.000],[505.667,0.000],[548.000,0.000],[548.000,250.000],[0.000,250.000]]);
  translate([8.000,35.000]) square([3.000,20.000]);
  translate([8.000,115.000]) square([3.000,20.000]);
  translate([8.000,195.000]) square([3.000,20.000]);
  translate([121.000,35.000]) square([3.000,20.000]);
  translate([121.000,115.000]) square([3.000,20.000]);
  translate([121.000,195.000]) square([3.000,20.000]);
  translate([444.000,35.000]) square([3.000,20.000]);
  translate([444.000,115.000]) square([3.000,20.000]);
  translate([444.000,195.000]) square([3.000,20.000]);
  translate([537.000,35.000]) square([3.000,20.000]);
  translate([537.000,115.000]) square([3.000,20.000]);
  translate([537.000,195.000]) square([3.000,20.000]);
  translate([26.000,20.000]) square([20.000,4.000]);
  translate([56.000,20.000]) square([20.000,4.000]);
  translate([86.000,20.000]) square([20.000,4.000]);
  translate([26.000,225.000]) square([20.000,4.000]);
  translate([56.000,225.000]) square([20.000,4.000]);
  translate([86.000,225.000]) square([20.000,4.000]);
} }
module end_electronics() { linear_extrude(3.0) difference() { polygon([[0.000,0.000],[40.000,0.000],[40.000,-3.000],[60.000,-3.000],[60.000,0.000],[140.000,0.000],[140.000,-3.000],[160.000,-3.000],[160.000,0.000],[200.000,0.000],[200.000,35.000],[203.000,35.000],[203.000,55.000],[200.000,55.000],[200.000,115.000],[203.000,115.000],[203.000,135.000],[200.000,135.000],[200.000,195.000],[203.000,195.000],[203.000,215.000],[200.000,215.000],[200.000,250.000],[0.000,250.000],[0.000,215.000],[-3.000,215.000],[-3.000,195.000],[0.000,195.000],[0.000,135.000],[-3.000,135.000],[-3.000,115.000],[0.000,115.000],[0.000,55.000],[-3.000,55.000],[-3.000,35.000],[0.000,35.000]]);
  translate([35.000,40.000]) circle(d=8.000, $fn=32);
  translate([65.000,40.000]) circle(d=12.000, $fn=32);
  translate([100.000,12.000]) square([16.000,10.000]);
  translate([150.000,40.000]) circle(d=6.000, $fn=32);
  translate([15.000,225.000]) square([20.000,4.000]);
  translate([45.000,225.000]) square([20.000,4.000]);
  translate([75.000,225.000]) square([20.000,4.000]);
  translate([105.000,225.000]) square([20.000,4.000]);
  translate([135.000,225.000]) square([20.000,4.000]);
  translate([165.000,225.000]) square([20.000,4.000]);
  translate([125.000,60.000]) square([20.000,4.000]);
  translate([155.000,60.000]) square([20.000,4.000]);
} }
module divider_solid() { linear_extrude(3.0) difference() { polygon([[0.000,0.000],[40.000,0.000],[40.000,-3.000],[60.000,-3.000],[60.000,0.000],[140.000,0.000],[140.000,-3.000],[160.000,-3.000],[160.000,0.000],[200.000,0.000],[200.000,35.000],[203.000,35.000],[203.000,55.000],[200.000,55.000],[200.000,115.000],[203.000,115.000],[203.000,135.000],[200.000,135.000],[200.000,195.000],[203.000,195.000],[203.000,215.000],[200.000,215.000],[200.000,250.000],[0.000,250.000],[0.000,215.000],[-3.000,215.000],[-3.000,195.000],[0.000,195.000],[0.000,135.000],[-3.000,135.000],[-3.000,115.000],[0.000,115.000],[0.000,55.000],[-3.000,55.000],[-3.000,35.000],[0.000,35.000]]);
  translate([40.000,60.000]) circle(d=12.000, $fn=32);
  translate([80.000,60.000]) circle(d=12.000, $fn=32);
  translate([120.000,60.000]) circle(d=12.000, $fn=32);
  translate([160.000,60.000]) circle(d=12.000, $fn=32);
  translate([100.000,170.000]) circle(d=12.000, $fn=32);
  translate([170.000,235.000]) circle(d=8.000, $fn=32);
} }
module divider_damper() { linear_extrude(3.0) difference() { polygon([[0.000,0.000],[40.000,0.000],[40.000,-3.000],[60.000,-3.000],[60.000,0.000],[140.000,0.000],[140.000,-3.000],[160.000,-3.000],[160.000,0.000],[200.000,0.000],[200.000,35.000],[203.000,35.000],[203.000,55.000],[200.000,55.000],[200.000,115.000],[203.000,115.000],[203.000,135.000],[200.000,135.000],[200.000,195.000],[203.000,195.000],[203.000,215.000],[200.000,215.000],[200.000,250.000],[0.000,250.000],[0.000,215.000],[-3.000,215.000],[-3.000,195.000],[0.000,195.000],[0.000,135.000],[-3.000,135.000],[-3.000,115.000],[0.000,115.000],[0.000,55.000],[-3.000,55.000],[-3.000,35.000],[0.000,35.000]]);
  translate([15.000,30.000]) square([50.000,8.000]);
  translate([75.000,30.000]) square([50.000,8.000]);
  translate([135.000,30.000]) square([50.000,8.000]);
  translate([15.000,50.000]) square([50.000,8.000]);
  translate([75.000,50.000]) square([50.000,8.000]);
  translate([135.000,50.000]) square([50.000,8.000]);
  translate([15.000,70.000]) square([50.000,8.000]);
  translate([75.000,70.000]) square([50.000,8.000]);
  translate([135.000,70.000]) square([50.000,8.000]);
  translate([15.000,90.000]) square([50.000,8.000]);
  translate([75.000,90.000]) square([50.000,8.000]);
  translate([135.000,90.000]) square([50.000,8.000]);
  translate([15.000,110.000]) square([50.000,8.000]);
  translate([75.000,110.000]) square([50.000,8.000]);
  translate([135.000,110.000]) square([50.000,8.000]);
  translate([15.000,130.000]) square([50.000,8.000]);
  translate([75.000,130.000]) square([50.000,8.000]);
  translate([135.000,130.000]) square([50.000,8.000]);
  translate([15.000,150.000]) square([50.000,8.000]);
  translate([75.000,150.000]) square([50.000,8.000]);
  translate([135.000,150.000]) square([50.000,8.000]);
  translate([15.000,170.000]) square([50.000,8.000]);
  translate([75.000,170.000]) square([50.000,8.000]);
  translate([135.000,170.000]) square([50.000,8.000]);
  translate([15.000,190.000]) square([50.000,8.000]);
  translate([75.000,190.000]) square([50.000,8.000]);
  translate([135.000,190.000]) square([50.000,8.000]);
  translate([170.000,235.000]) circle(d=8.000, $fn=32);
} }
module end_fan() { linear_extrude(3.0) difference() { polygon([[0.000,0.000],[40.000,0.000],[40.000,-3.000],[60.000,-3.000],[60.000,0.000],[140.000,0.000],[140.000,-3.000],[160.000,-3.000],[160.000,0.000],[200.000,0.000],[200.000,35.000],[203.000,35.000],[203.000,55.000],[200.000,55.000],[200.000,115.000],[203.000,115.000],[203.000,135.000],[200.000,135.000],[200.000,195.000],[203.000,195.000],[203.000,215.000],[200.000,215.000],[200.000,250.000],[0.000,250.000],[0.000,215.000],[-3.000,215.000],[-3.000,195.000],[0.000,195.000],[0.000,135.000],[-3.000,135.000],[-3.000,115.000],[0.000,115.000],[0.000,55.000],[-3.000,55.000],[-3.000,35.000],[0.000,35.000]]);
  translate([100.000,125.000]) circle(d=38.000, $fn=32);
  translate([84.000,109.000]) circle(d=3.400, $fn=32);
  translate([84.000,141.000]) circle(d=3.400, $fn=32);
  translate([116.000,109.000]) circle(d=3.400, $fn=32);
  translate([116.000,141.000]) circle(d=3.400, $fn=32);
  translate([160.000,30.000]) circle(d=6.000, $fn=32);
} }
module damper_plate() { linear_extrude(2.0) difference() { polygon([[0.000,0.000],[186.000,0.000],[186.000,215.000],[108.000,215.000],[108.000,285.000],[78.000,285.000],[78.000,215.000],[0.000,215.000]]);
  translate([8.000,20.000]) square([50.000,8.000]);
  translate([68.000,20.000]) square([50.000,8.000]);
  translate([128.000,20.000]) square([50.000,8.000]);
  translate([8.000,40.000]) square([50.000,8.000]);
  translate([68.000,40.000]) square([50.000,8.000]);
  translate([128.000,40.000]) square([50.000,8.000]);
  translate([8.000,60.000]) square([50.000,8.000]);
  translate([68.000,60.000]) square([50.000,8.000]);
  translate([128.000,60.000]) square([50.000,8.000]);
  translate([8.000,80.000]) square([50.000,8.000]);
  translate([68.000,80.000]) square([50.000,8.000]);
  translate([128.000,80.000]) square([50.000,8.000]);
  translate([8.000,100.000]) square([50.000,8.000]);
  translate([68.000,100.000]) square([50.000,8.000]);
  translate([128.000,100.000]) square([50.000,8.000]);
  translate([8.000,120.000]) square([50.000,8.000]);
  translate([68.000,120.000]) square([50.000,8.000]);
  translate([128.000,120.000]) square([50.000,8.000]);
  translate([8.000,140.000]) square([50.000,8.000]);
  translate([68.000,140.000]) square([50.000,8.000]);
  translate([128.000,140.000]) square([50.000,8.000]);
  translate([8.000,160.000]) square([50.000,8.000]);
  translate([68.000,160.000]) square([50.000,8.000]);
  translate([128.000,160.000]) square([50.000,8.000]);
  translate([8.000,180.000]) square([50.000,8.000]);
  translate([68.000,180.000]) square([50.000,8.000]);
  translate([128.000,180.000]) square([50.000,8.000]);
  translate([93.000,244.700]) circle(d=3.400, $fn=32);
  translate([93.000,277.000]) circle(d=3.400, $fn=32);
} }
module guide_spacer_1() { linear_extrude(3.0) difference() { polygon([[0.000,0.000],[6.000,0.000],[6.000,240.000],[0.000,240.000]]);
} }
module guide_cover_1() { linear_extrude(3.0) difference() { polygon([[0.000,0.000],[16.000,0.000],[16.000,240.000],[0.000,240.000]]);
} }
module guide_spacer_2() { linear_extrude(3.0) difference() { polygon([[0.000,0.000],[6.000,0.000],[6.000,240.000],[0.000,240.000]]);
} }
module guide_cover_2() { linear_extrude(3.0) difference() { polygon([[0.000,0.000],[16.000,0.000],[16.000,240.000],[0.000,240.000]]);
} }
module lid_electronics() { linear_extrude(3.0) difference() { polygon([[0.000,0.000],[114.500,0.000],[114.500,206.000],[0.000,206.000]]);
  translate([20.000,40.000]) square([6.000,126.000]);
  translate([34.000,40.000]) square([6.000,126.000]);
  translate([48.000,40.000]) square([6.000,126.000]);
  translate([62.000,40.000]) square([6.000,126.000]);
  translate([76.000,40.000]) square([6.000,126.000]);
} }
module lid_terrarium() { linear_extrude(3.0) difference() { polygon([[0.000,0.000],[323.000,0.000],[323.000,206.000],[0.000,206.000]]);
  translate([18.000,45.000]) square([6.000,116.000]);
  translate([32.000,45.000]) square([6.000,116.000]);
  translate([46.000,45.000]) square([6.000,116.000]);
  translate([60.000,45.000]) square([6.000,116.000]);
  translate([95.000,81.000]) square([3.000,10.000]);
  translate([95.000,115.000]) square([3.000,10.000]);
  translate([115.000,181.000]) circle(d=6.000, $fn=32);
  translate([263.000,103.000]) circle(d=25.000, $fn=32);
} }
module lid_air() { linear_extrude(3.0) difference() { polygon([[0.000,0.000],[94.500,0.000],[94.500,206.000],[0.000,206.000],[0.000,120.000],[6.000,120.000],[6.000,86.000],[0.000,86.000]]);
  translate([57.250,103.000]) circle(d=20.000, $fn=32);
} }
module lid_locator_01() { linear_extrude(3.0) difference() { polygon([[0.000,0.000],[10.000,0.000],[10.000,50.000],[0.000,50.000]]);
} }
module lid_locator_02() { linear_extrude(3.0) difference() { polygon([[0.000,0.000],[10.000,0.000],[10.000,50.000],[0.000,50.000]]);
} }
module lid_locator_03() { linear_extrude(3.0) difference() { polygon([[0.000,0.000],[10.000,0.000],[10.000,50.000],[0.000,50.000]]);
} }
module lid_locator_04() { linear_extrude(3.0) difference() { polygon([[0.000,0.000],[10.000,0.000],[10.000,50.000],[0.000,50.000]]);
} }
module lid_locator_05() { linear_extrude(3.0) difference() { polygon([[0.000,0.000],[10.000,0.000],[10.000,50.000],[0.000,50.000]]);
} }
module lid_locator_06() { linear_extrude(3.0) difference() { polygon([[0.000,0.000],[10.000,0.000],[10.000,50.000],[0.000,50.000]]);
} }
module lid_locator_07() { linear_extrude(3.0) difference() { polygon([[0.000,0.000],[10.000,0.000],[10.000,50.000],[0.000,50.000]]);
} }
module lid_locator_08() { linear_extrude(3.0) difference() { polygon([[0.000,0.000],[10.000,0.000],[10.000,50.000],[0.000,50.000]]);
} }
module lid_locator_09() { linear_extrude(3.0) difference() { polygon([[0.000,0.000],[10.000,0.000],[10.000,50.000],[0.000,50.000]]);
} }
module lid_locator_10() { linear_extrude(3.0) difference() { polygon([[0.000,0.000],[10.000,0.000],[10.000,50.000],[0.000,50.000]]);
} }
module lid_locator_11() { linear_extrude(3.0) difference() { polygon([[0.000,0.000],[10.000,0.000],[10.000,50.000],[0.000,50.000]]);
} }
module lid_locator_12() { linear_extrude(3.0) difference() { polygon([[0.000,0.000],[10.000,0.000],[10.000,50.000],[0.000,50.000]]);
} }
module fan_bracket() { linear_extrude(3.0) difference() { polygon([[0.000,0.000],[56.000,0.000],[56.000,70.000],[50.000,70.000],[50.000,73.000],[40.000,73.000],[40.000,70.000],[16.000,70.000],[16.000,73.000],[6.000,73.000],[6.000,70.000],[0.000,70.000]]);
  translate([28.000,30.000]) circle(d=38.000, $fn=32);
  translate([12.000,14.000]) circle(d=3.400, $fn=32);
  translate([12.000,46.000]) circle(d=3.400, $fn=32);
  translate([44.000,14.000]) circle(d=3.400, $fn=32);
  translate([44.000,46.000]) circle(d=3.400, $fn=32);
} }
module electronics_tray() { linear_extrude(3.0) difference() { polygon([[0.000,0.000],[104.000,0.000],[104.000,190.000],[0.000,190.000]]);
  translate([7.000,10.000]) circle(d=3.200, $fn=32);
  translate([7.000,20.000]) circle(d=3.200, $fn=32);
  translate([7.000,30.000]) circle(d=3.200, $fn=32);
  translate([7.000,40.000]) circle(d=3.200, $fn=32);
  translate([7.000,50.000]) circle(d=3.200, $fn=32);
  translate([7.000,60.000]) circle(d=3.200, $fn=32);
  translate([7.000,70.000]) circle(d=3.200, $fn=32);
  translate([7.000,80.000]) circle(d=3.200, $fn=32);
  translate([7.000,90.000]) circle(d=3.200, $fn=32);
  translate([7.000,100.000]) circle(d=3.200, $fn=32);
  translate([7.000,110.000]) circle(d=3.200, $fn=32);
  translate([7.000,120.000]) circle(d=3.200, $fn=32);
  translate([7.000,130.000]) circle(d=3.200, $fn=32);
  translate([7.000,140.000]) circle(d=3.200, $fn=32);
  translate([7.000,150.000]) circle(d=3.200, $fn=32);
  translate([7.000,160.000]) circle(d=3.200, $fn=32);
  translate([7.000,170.000]) circle(d=3.200, $fn=32);
  translate([7.000,180.000]) circle(d=3.200, $fn=32);
  translate([17.000,10.000]) circle(d=3.200, $fn=32);
  translate([17.000,20.000]) circle(d=3.200, $fn=32);
  translate([17.000,30.000]) circle(d=3.200, $fn=32);
  translate([17.000,40.000]) circle(d=3.200, $fn=32);
  translate([17.000,50.000]) circle(d=3.200, $fn=32);
  translate([17.000,60.000]) circle(d=3.200, $fn=32);
  translate([17.000,70.000]) circle(d=3.200, $fn=32);
  translate([17.000,80.000]) circle(d=3.200, $fn=32);
  translate([17.000,90.000]) circle(d=3.200, $fn=32);
  translate([17.000,100.000]) circle(d=3.200, $fn=32);
  translate([17.000,110.000]) circle(d=3.200, $fn=32);
  translate([17.000,120.000]) circle(d=3.200, $fn=32);
  translate([17.000,130.000]) circle(d=3.200, $fn=32);
  translate([17.000,140.000]) circle(d=3.200, $fn=32);
  translate([17.000,150.000]) circle(d=3.200, $fn=32);
  translate([17.000,160.000]) circle(d=3.200, $fn=32);
  translate([17.000,170.000]) circle(d=3.200, $fn=32);
  translate([17.000,180.000]) circle(d=3.200, $fn=32);
  translate([27.000,10.000]) circle(d=3.200, $fn=32);
  translate([27.000,20.000]) circle(d=3.200, $fn=32);
  translate([27.000,30.000]) circle(d=3.200, $fn=32);
  translate([27.000,40.000]) circle(d=3.200, $fn=32);
  translate([27.000,50.000]) circle(d=3.200, $fn=32);
  translate([27.000,60.000]) circle(d=3.200, $fn=32);
  translate([27.000,70.000]) circle(d=3.200, $fn=32);
  translate([27.000,80.000]) circle(d=3.200, $fn=32);
  translate([27.000,90.000]) circle(d=3.200, $fn=32);
  translate([27.000,100.000]) circle(d=3.200, $fn=32);
  translate([27.000,110.000]) circle(d=3.200, $fn=32);
  translate([27.000,120.000]) circle(d=3.200, $fn=32);
  translate([27.000,130.000]) circle(d=3.200, $fn=32);
  translate([27.000,140.000]) circle(d=3.200, $fn=32);
  translate([27.000,150.000]) circle(d=3.200, $fn=32);
  translate([27.000,160.000]) circle(d=3.200, $fn=32);
  translate([27.000,170.000]) circle(d=3.200, $fn=32);
  translate([27.000,180.000]) circle(d=3.200, $fn=32);
  translate([37.000,10.000]) circle(d=3.200, $fn=32);
  translate([37.000,20.000]) circle(d=3.200, $fn=32);
  translate([37.000,30.000]) circle(d=3.200, $fn=32);
  translate([37.000,40.000]) circle(d=3.200, $fn=32);
  translate([37.000,50.000]) circle(d=3.200, $fn=32);
  translate([37.000,60.000]) circle(d=3.200, $fn=32);
  translate([37.000,70.000]) circle(d=3.200, $fn=32);
  translate([37.000,80.000]) circle(d=3.200, $fn=32);
  translate([37.000,90.000]) circle(d=3.200, $fn=32);
  translate([37.000,100.000]) circle(d=3.200, $fn=32);
  translate([37.000,110.000]) circle(d=3.200, $fn=32);
  translate([37.000,120.000]) circle(d=3.200, $fn=32);
  translate([37.000,130.000]) circle(d=3.200, $fn=32);
  translate([37.000,140.000]) circle(d=3.200, $fn=32);
  translate([37.000,150.000]) circle(d=3.200, $fn=32);
  translate([37.000,160.000]) circle(d=3.200, $fn=32);
  translate([37.000,170.000]) circle(d=3.200, $fn=32);
  translate([37.000,180.000]) circle(d=3.200, $fn=32);
  translate([47.000,10.000]) circle(d=3.200, $fn=32);
  translate([47.000,20.000]) circle(d=3.200, $fn=32);
  translate([47.000,30.000]) circle(d=3.200, $fn=32);
  translate([47.000,40.000]) circle(d=3.200, $fn=32);
  translate([47.000,50.000]) circle(d=3.200, $fn=32);
  translate([47.000,60.000]) circle(d=3.200, $fn=32);
  translate([47.000,70.000]) circle(d=3.200, $fn=32);
  translate([47.000,80.000]) circle(d=3.200, $fn=32);
  translate([47.000,90.000]) circle(d=3.200, $fn=32);
  translate([47.000,100.000]) circle(d=3.200, $fn=32);
  translate([47.000,110.000]) circle(d=3.200, $fn=32);
  translate([47.000,120.000]) circle(d=3.200, $fn=32);
  translate([47.000,130.000]) circle(d=3.200, $fn=32);
  translate([47.000,140.000]) circle(d=3.200, $fn=32);
  translate([47.000,150.000]) circle(d=3.200, $fn=32);
  translate([47.000,160.000]) circle(d=3.200, $fn=32);
  translate([47.000,170.000]) circle(d=3.200, $fn=32);
  translate([47.000,180.000]) circle(d=3.200, $fn=32);
  translate([57.000,10.000]) circle(d=3.200, $fn=32);
  translate([57.000,20.000]) circle(d=3.200, $fn=32);
  translate([57.000,30.000]) circle(d=3.200, $fn=32);
  translate([57.000,40.000]) circle(d=3.200, $fn=32);
  translate([57.000,50.000]) circle(d=3.200, $fn=32);
  translate([57.000,60.000]) circle(d=3.200, $fn=32);
  translate([57.000,70.000]) circle(d=3.200, $fn=32);
  translate([57.000,80.000]) circle(d=3.200, $fn=32);
  translate([57.000,90.000]) circle(d=3.200, $fn=32);
  translate([57.000,100.000]) circle(d=3.200, $fn=32);
  translate([57.000,110.000]) circle(d=3.200, $fn=32);
  translate([57.000,120.000]) circle(d=3.200, $fn=32);
  translate([57.000,130.000]) circle(d=3.200, $fn=32);
  translate([57.000,140.000]) circle(d=3.200, $fn=32);
  translate([57.000,150.000]) circle(d=3.200, $fn=32);
  translate([57.000,160.000]) circle(d=3.200, $fn=32);
  translate([57.000,170.000]) circle(d=3.200, $fn=32);
  translate([57.000,180.000]) circle(d=3.200, $fn=32);
  translate([67.000,10.000]) circle(d=3.200, $fn=32);
  translate([67.000,20.000]) circle(d=3.200, $fn=32);
  translate([67.000,30.000]) circle(d=3.200, $fn=32);
  translate([67.000,40.000]) circle(d=3.200, $fn=32);
  translate([67.000,50.000]) circle(d=3.200, $fn=32);
  translate([67.000,60.000]) circle(d=3.200, $fn=32);
  translate([67.000,70.000]) circle(d=3.200, $fn=32);
  translate([67.000,80.000]) circle(d=3.200, $fn=32);
  translate([67.000,90.000]) circle(d=3.200, $fn=32);
  translate([67.000,100.000]) circle(d=3.200, $fn=32);
  translate([67.000,110.000]) circle(d=3.200, $fn=32);
  translate([67.000,120.000]) circle(d=3.200, $fn=32);
  translate([67.000,130.000]) circle(d=3.200, $fn=32);
  translate([67.000,140.000]) circle(d=3.200, $fn=32);
  translate([67.000,150.000]) circle(d=3.200, $fn=32);
  translate([67.000,160.000]) circle(d=3.200, $fn=32);
  translate([67.000,170.000]) circle(d=3.200, $fn=32);
  translate([67.000,180.000]) circle(d=3.200, $fn=32);
  translate([77.000,10.000]) circle(d=3.200, $fn=32);
  translate([77.000,20.000]) circle(d=3.200, $fn=32);
  translate([77.000,30.000]) circle(d=3.200, $fn=32);
  translate([77.000,40.000]) circle(d=3.200, $fn=32);
  translate([77.000,50.000]) circle(d=3.200, $fn=32);
  translate([77.000,60.000]) circle(d=3.200, $fn=32);
  translate([77.000,70.000]) circle(d=3.200, $fn=32);
  translate([77.000,80.000]) circle(d=3.200, $fn=32);
  translate([77.000,90.000]) circle(d=3.200, $fn=32);
  translate([77.000,100.000]) circle(d=3.200, $fn=32);
  translate([77.000,110.000]) circle(d=3.200, $fn=32);
  translate([77.000,120.000]) circle(d=3.200, $fn=32);
  translate([77.000,130.000]) circle(d=3.200, $fn=32);
  translate([77.000,140.000]) circle(d=3.200, $fn=32);
  translate([77.000,150.000]) circle(d=3.200, $fn=32);
  translate([77.000,160.000]) circle(d=3.200, $fn=32);
  translate([77.000,170.000]) circle(d=3.200, $fn=32);
  translate([77.000,180.000]) circle(d=3.200, $fn=32);
  translate([87.000,10.000]) circle(d=3.200, $fn=32);
  translate([87.000,20.000]) circle(d=3.200, $fn=32);
  translate([87.000,30.000]) circle(d=3.200, $fn=32);
  translate([87.000,40.000]) circle(d=3.200, $fn=32);
  translate([87.000,50.000]) circle(d=3.200, $fn=32);
  translate([87.000,60.000]) circle(d=3.200, $fn=32);
  translate([87.000,70.000]) circle(d=3.200, $fn=32);
  translate([87.000,80.000]) circle(d=3.200, $fn=32);
  translate([87.000,90.000]) circle(d=3.200, $fn=32);
  translate([87.000,100.000]) circle(d=3.200, $fn=32);
  translate([87.000,110.000]) circle(d=3.200, $fn=32);
  translate([87.000,120.000]) circle(d=3.200, $fn=32);
  translate([87.000,130.000]) circle(d=3.200, $fn=32);
  translate([87.000,140.000]) circle(d=3.200, $fn=32);
  translate([87.000,150.000]) circle(d=3.200, $fn=32);
  translate([87.000,160.000]) circle(d=3.200, $fn=32);
  translate([87.000,170.000]) circle(d=3.200, $fn=32);
  translate([87.000,180.000]) circle(d=3.200, $fn=32);
  translate([97.000,10.000]) circle(d=3.200, $fn=32);
  translate([97.000,20.000]) circle(d=3.200, $fn=32);
  translate([97.000,30.000]) circle(d=3.200, $fn=32);
  translate([97.000,40.000]) circle(d=3.200, $fn=32);
  translate([97.000,50.000]) circle(d=3.200, $fn=32);
  translate([97.000,60.000]) circle(d=3.200, $fn=32);
  translate([97.000,70.000]) circle(d=3.200, $fn=32);
  translate([97.000,80.000]) circle(d=3.200, $fn=32);
  translate([97.000,90.000]) circle(d=3.200, $fn=32);
  translate([97.000,100.000]) circle(d=3.200, $fn=32);
  translate([97.000,110.000]) circle(d=3.200, $fn=32);
  translate([97.000,120.000]) circle(d=3.200, $fn=32);
  translate([97.000,130.000]) circle(d=3.200, $fn=32);
  translate([97.000,140.000]) circle(d=3.200, $fn=32);
  translate([97.000,150.000]) circle(d=3.200, $fn=32);
  translate([97.000,160.000]) circle(d=3.200, $fn=32);
  translate([97.000,170.000]) circle(d=3.200, $fn=32);
  translate([97.000,180.000]) circle(d=3.200, $fn=32);
} }
module assembly() {
 color("LightCyan", A) translate([-8.0,-8.0,-3.0]) base();
 color("LightCyan", A) translate([-8.0,3.0,0]) rotate([90,0,0]) front();
 color("LightCyan", A) translate([-8.0,206.0,0]) rotate([90,0,0]) back();
 color("LightSlateGray", A) translate([0.000,3.000,0]) rotate([90,0,90]) end_electronics();
 color("LightSlateGray", A) translate([113.000,3.000,0]) rotate([90,0,90]) divider_solid();
 color("LightSlateGray", A) translate([436.000,3.000,0]) rotate([90,0,90]) divider_damper();
 color("LightSlateGray", A) translate([529.000,3.000,0]) rotate([90,0,90]) end_fan();
 color("Orange", 0.8) translate([439.500,10.000,EXPLODE*40]) rotate([90,0,90]) damper_plate();
 color("Gold", 0.7) translate([439.000,3.000,5]) rotate([90,0,90]) guide_spacer_1();
 color("Gold", 0.7) translate([439.000,197.000,5]) rotate([90,0,90]) guide_spacer_2();
 color("Gold", 0.7) translate([442.000,3.000,5]) rotate([90,0,90]) guide_cover_1();
 color("Gold", 0.7) translate([442.000,187.000,5]) rotate([90,0,90]) guide_cover_2();
 color("White", A) translate([0,0,250.0 + EXPLODE*60]) lid_electronics();
 color("White", A) translate([114.500,0,250.0 + EXPLODE*60]) lid_terrarium();
 color("White", A) translate([437.500,0,250.0 + EXPLODE*60]) lid_air();
 color("Tomato", 0.8) translate([209.500,75.000,180.0 + EXPLODE*60]) rotate([90,0,90]) fan_bracket();
 color("DarkSeaGreen", 0.8) translate([6.000,8.000,8]) electronics_tray();
}
assembly();
