kishorkishor/Terrarium/docs/lab-step-2026-09-25.md

# Step test, 2026-09-25 19:10 to 20:30 (measured data)

Rig: closed box, one BME280 inside (0x76, high, shielded), one outside (0x77, on the table), one ultrasonic mist maker (channel A, GPIO25). Firmware `firmware/lab`, runner `tools/lab/logger.py --protocol step --mists A`, analysis `tools/lab/analyze_step.py`. Data `data/lab-step-2026-09-25-1910.csv` (4825 rows, 1 Hz, 100 % good). Figure `docs/figures/lab-step-2026-09-25-1910.png`.

Protocol per round: 5 min quiet, mist on until the inside humidity stops rising, 20 min off. Three rounds.

| Round | Start %RH | Peak %RH | Mist time s | Mister strength g/m³/s (dry air) | Drop in 20 min %RH | Cooling °C |
|---|---|---|---|---|---|---|
| A1 | 83.0 | 89.0 | 110 | 0.086 | 1.8 | 0.65 |
| A2 | 86.9 | 89.5 | 97 | 0.110 | 2.0 | 0.31 |
| A3 | 87.1 | 89.9 | 104 | 0.099 | 1.2 | 0.24 |
| mean ± sd | | 89.5 ± 0.4 | 104 ± 7 | 0.098 ± 0.012 | 1.7 ± 0.4 | |

## What it means
1. **The mister has a hard ceiling of about 89.5 %RH** at the inside sensor, reached in under 2 minutes, and it is repeatable to 0.4 %. Misting longer adds droplets, not humidity. A burst cap of 2 to 3 minutes is enough for this box; the old 5 minute cap wastes water.
2. **The closed box barely dries.** With the room at 75 %RH, the inside falls only 1.7 % in 20 minutes. A decay time constant cannot be fitted from this run because the inside and outside air are too close. The earlier run today with one end open fell 5 % in 25 min.
3. **Temperature moves with the mist:** the inside warms 0.2 to 0.4 °C while the disc runs (the disc heats the water), then falls 0.5 °C below the start as the fog evaporates. The model must include temperature, or work in absolute humidity, which the brain already does.
4. **Consequence for the controller comparison:** in this room, with the lid closed and no fan, the on/off rules will mist perhaps once every few hours. There is little for any controller to do. To make the comparison meaningful, the box needs a drying path: the exhaust fan on a schedule, or a fixed vent gap. Decide this before the brain run.

## Model constants (for tools/brain/sim_box.py)
- k_mist (dry-air equivalent): 0.10 g/m³/s with this disc in the closed box, 0.17 in the afternoon run with the end open. Use 0.10 for the closed rig.
- Ceiling: the (1 − RH/100) factor alone does not explain a hard stop at 89.5 %; add condensation on the walls as a sink above about 88 %.
- Leak: too small to measure closed. Measure again with the vent or fan.
