kishorkishor/Terrarium/3d/PRINT-SHEET.md

# Print sheet: three-bay terrarium enclosure

Files are in millimetres (STL has no unit; tell the shop **1 unit = 1 mm**). Print 1 of each.

| File | Part | Size in ft (L x W x H) | Size in inches | Size in mm |
|---|---|---|---|---|
| bay_terrarium_bay.stl | Terrarium bay (box) | 0.659 x 0.573 x 0.566 | 7.91 x 6.88 x 6.79 | 200.8 x 174.8 x 172.4 |
| bay_electronics_bay.stl | Electronics bay (box) | 0.288 x 0.573 x 0.566 | 3.46 x 6.88 x 6.79 | 87.8 x 174.8 x 172.4 |
| bay_air_bay.stl | Air-unit bay (box, fan end) | 0.265 x 0.573 x 0.566 | 3.18 x 6.88 x 6.79 | 80.8 x 174.8 x 172.4 |
| bay_damper_plate.stl | Sliding damper plate | 0.459 x 0.536 x 0.007 | 5.51 x 6.43 x 0.08 | 140.0 x 163.4 x 2.0 |
| bay_terrarium_lid.stl | Terrarium lid | 0.639 x 0.508 x 0.028 | 7.67 x 6.09 x 0.33 | 194.8 x 154.8 x 8.4 |
| bay_electronics_lid.stl | Electronics lid | 0.278 x 0.508 x 0.028 | 3.34 x 6.09 x 0.33 | 84.8 x 154.8 x 8.4 |
| bay_air_lid.stl | Air-unit lid | 0.245 x 0.508 x 0.028 | 2.94 x 6.09 x 0.33 | 74.8 x 154.8 x 8.4 |

## Assembled

| | ft | inches | mm |
|---|---|---|---|
| Overall length | 1.212 | 14.54 | 369.4 |
| Overall width (with bolt flanges) | 0.573 | 6.88 | 174.8 |
| Overall height (lids on) | 0.573 | 6.88 | 174.8 |
| Height with damper tab | 0.630 | 7.56 | 192 |
| Plant space inside terrarium bay | 0.623 x 0.492 x 0.558 | 7.48 x 5.91 x 6.69 | 190 x 150 x 170 |

## Material (transparent)

- Ask for **clear resin (SLA), polished or clear-coated** if the shop has a resin printer with a 200 mm build. This is the only printed option that is close to see-through.
- Otherwise **transparent / natural PETG**, 0.2 mm layers, 3 walls, 20-25 % infill, no supports. It comes out frosted: light passes, you see shapes, not detail.
- Do not use PLA (softens in warm humid air).
- Wall thickness is 2.4 mm. Bays print upright, open side up. Damper plate prints flat.

## Hardware

- M3 x 12 screws + nuts, 16 pcs (bay-to-bay flanges)
- M3 x 20 screw, 1 pc (holds damper open)
- 40 x 40 x 10 mm fan, 4 x M3 x 16
- Aquarium silicone for the inside seams of the terrarium bay
