kishorkishor/Terrarium/3d/preview_3bay_assembly.png

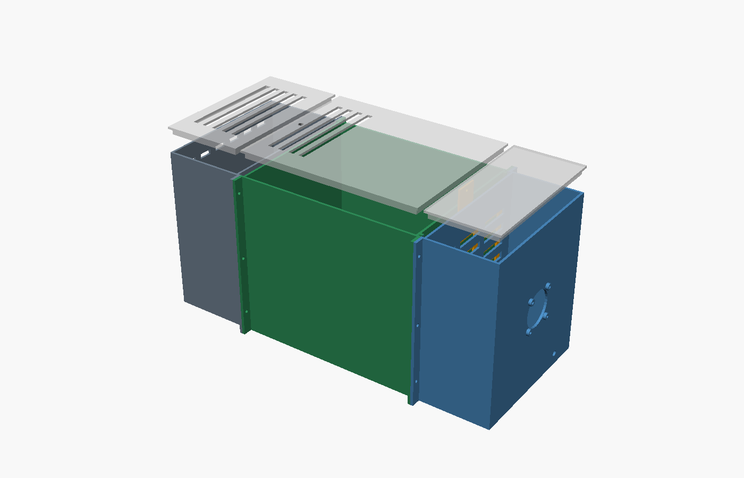
3d/preview_3bay_assembly.png
