kishorkishor/Terrarium/docs/figures/lab-step-2026-09-25-1910.png

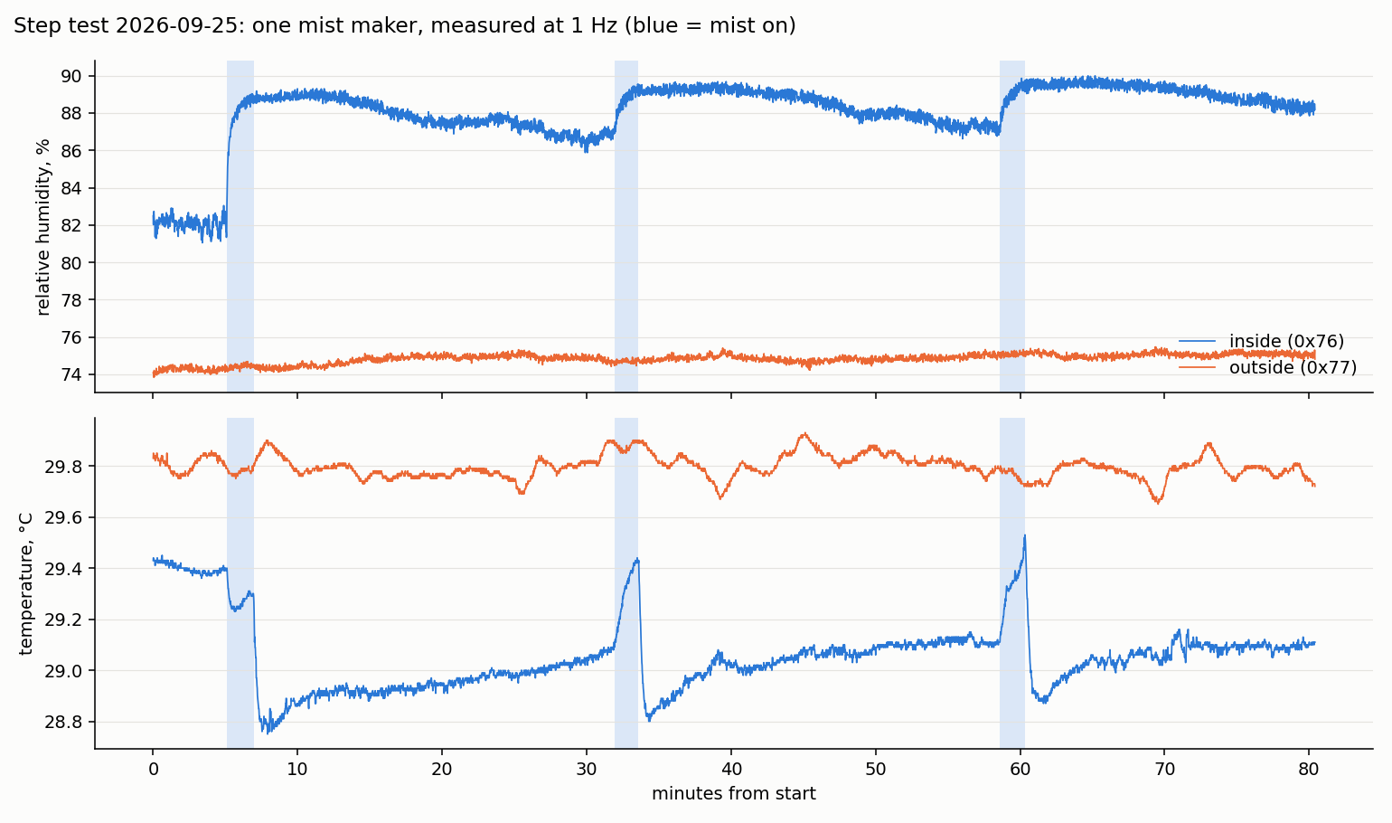
docs/figures/lab-step-2026-09-25-1910.png
