kishorkishor/Terrarium/tools/scan-result.txt

waiting for COM3 to be released...
port state: TIMEOUT
gave up waiting
