kishorkishor/Terrarium/3d/acrylic/PART-MAP_sheet_B_3mm.pdf

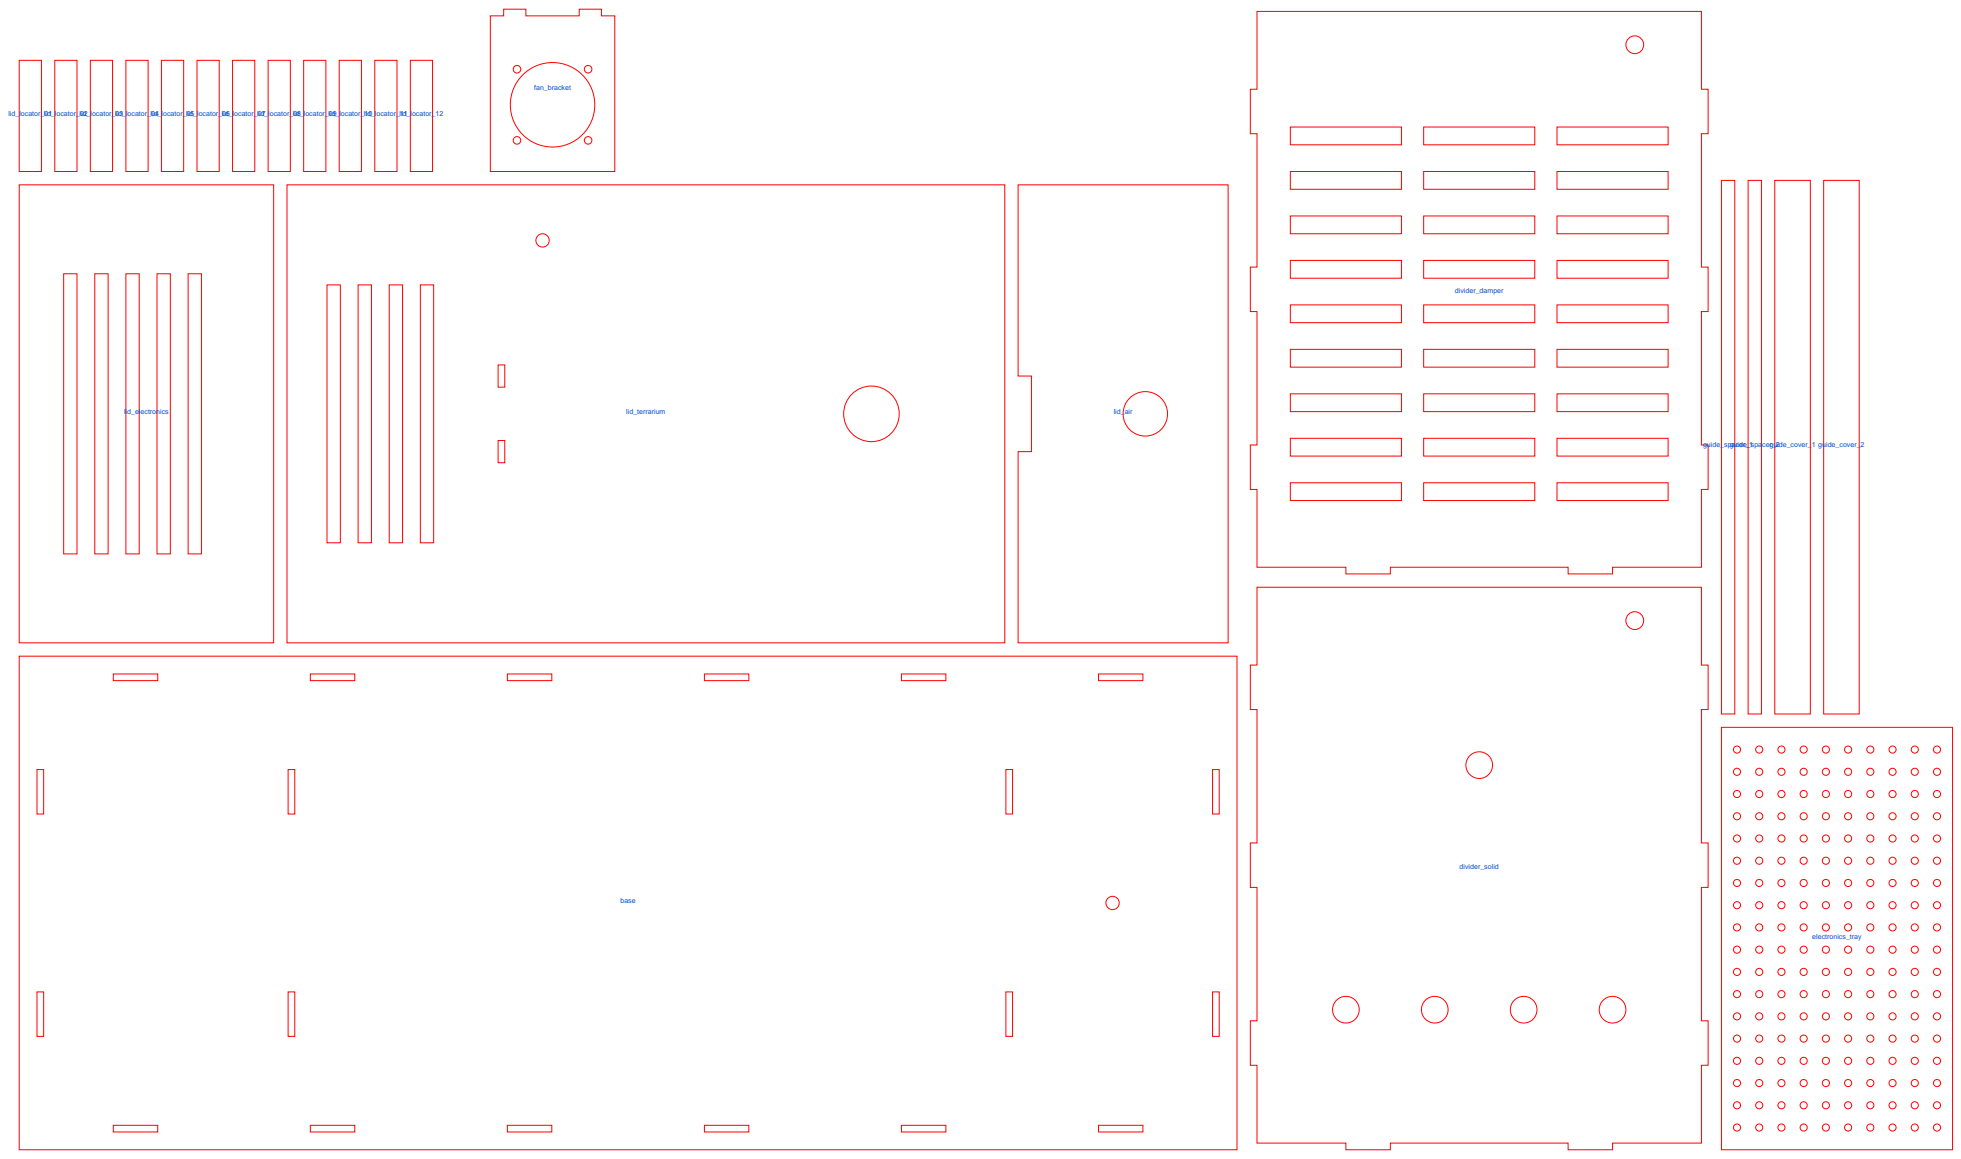
[picture p85: page 1]
base; lid_electronics; lid_terrarium; lid_air; divider_solid; divider_damper; electronics_tray; guide_spacer_1 guide_spacer_2 guide_cover_1 guide_cover_2; fan_bracket; lid_locator_01lid_locator_02lid_locator_03lid_locator_04lid_locator_05lid_locator_06lid_locator_07lid_locator_08lid_locator_09lid_locator_10lid_locator_11lid_locator_12
