kishorkishor/Terrarium/3d/acrylic/cut-files/sheet_B_3mm.pdf

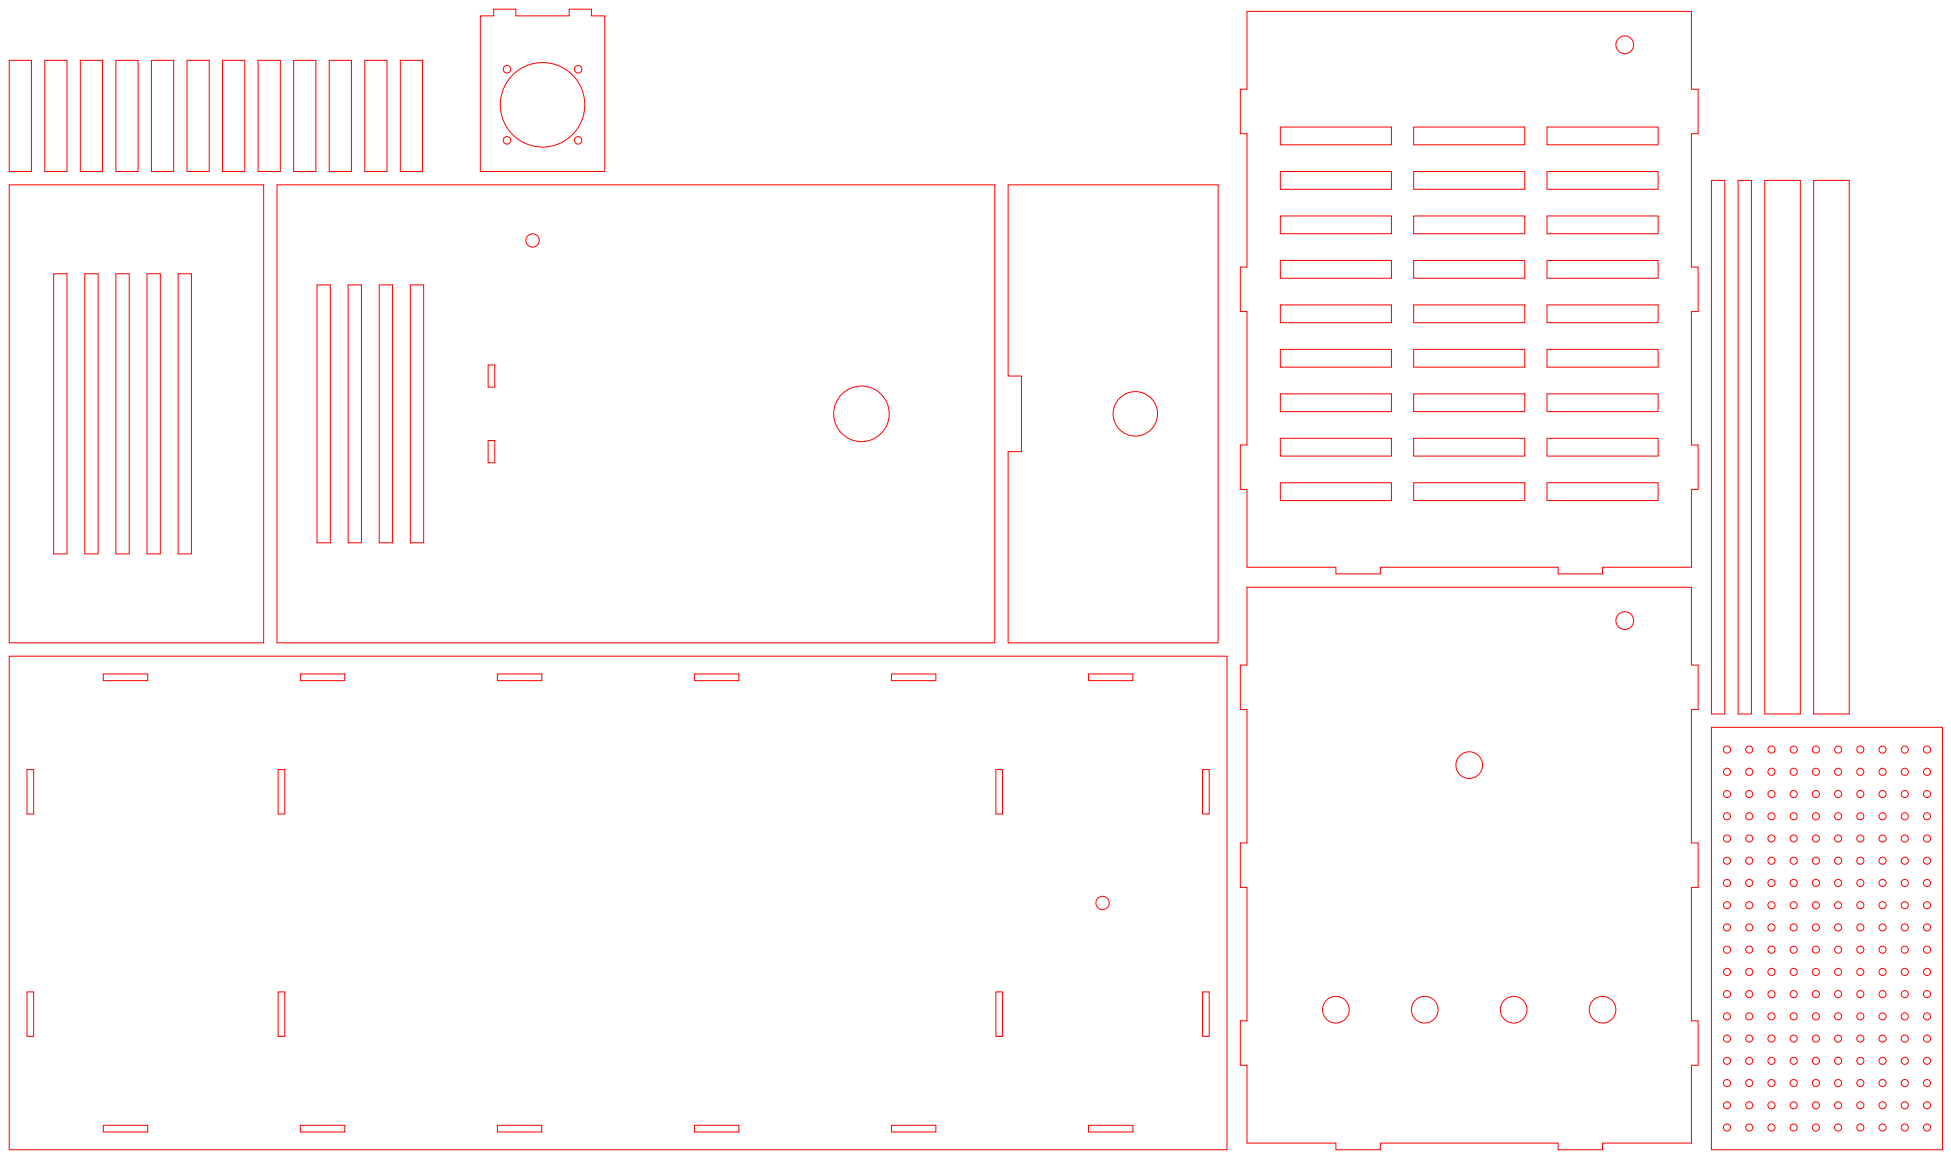
[picture p86: page 1]
