kishorkishor/Terrarium/(commit log)

2026-08-25 ESP32 automated terrarium: firmware, setup console, build guides and 3D parts
    [box.stl, canopy_corner.stl, canopy_rail.stl, disc_holder.stl, divider.stl, fan_duct.stl, fan_module.stl, grommet.stl]
2026-08-25 Set Wi-Fi from the dashboard without reflashing; bundle sensor libraries into the console
2026-08-28 Console v2: full manual control over USB or Wi-Fi, live-editable thresholds, Wi-Fi provisioning over serial; firmware hotspot-fallback and NTP retry fixes
    [terrarium.ino, terrarium_console.py]
2026-08-28 Add as-built wiring diagram, reusable start prompt, and EEE 4103 presentation deck
2026-08-31 TerrariumTester: standalone manual bench tester exe - toggle every output over USB with live sensor readout
2026-09-02 Detailed report: six-member team, prototype photo, architecture and control-flow figures, pin map, parameter and protocol tables, test matrix, survey appendix; deck gets 6th member and prototype photo
2026-09-16 Add leaf-wetness camera gap check: 15 verified neighbours, open items, framing and venues
2026-09-17 Add printable three-bay enclosure: electronics, terrarium and air-unit bays with bolt flanges, slide damper plate, lids; OpenSCAD source and STLs sized for a 220 mm bed
    [bay_air_bay.stl, bay_air_lid.stl, bay_damper_plate.stl, bay_electronics_bay.stl, bay_electronics_lid.stl, bay_terrarium_bay.stl, bay_terrarium_lid.stl, terrarium-3bay.scad]
2026-09-18 Add print sheet with part sizes in ft/in/mm and transparent-material notes
2026-09-18 Add onshape-import folder: seven numbered part STLs plus one assembled STL
    [0_WHOLE_BOX_assembled.stl, 1_electronics_bay.stl, 2_terrarium_bay.stl, 3_air_bay.stl, 4_damper_plate.stl, 5_electronics_lid.stl, 6_terrarium_lid.stl, 7_air_lid.stl]
2026-09-18 Add bigger transparent enclosure as laser-cut acrylic: parametric generator, AI/PDF/DXF/SVG cut sheets, per-part DXFs for Onshape, 3D model, component checklist
    [acrylic-assembled.stl, acrylic-assembly.scad, back.dxf, base.dxf, damper_plate.dxf, divider_damper.dxf, divider_solid.dxf, electronics_tray.dxf]
2026-09-18 Mark PDF, AI, STL and ZIP as binary so line-ending conversion cannot corrupt them
2026-09-18 Add cut list: quantities per file and per part
2026-09-25 Box humidity test: 1 Hz logger, scripted protocol, data and figure (2026-09-25)
    [box-2026-09-25-1521.csv, box-exp-2026-09-25-1558.csv, box-exp-2026-09-25-1645.csv]
2026-09-25 Lab rig for the paper: lab firmware (two BME280, two misters, watchdog, DIAG), logger with protocols and live page, step-test data and fit, brain simulator and plan docs
    [lab-baseline-2026-09-25-2046.csv, lab-log-2026-09-25-1835.csv, lab-step-2026-09-25-1904.csv, lab-step-2026-09-25-1905.csv, lab-step-2026-09-25-1908.csv, lab-step-2026-09-25-1910.csv]
2026-09-26 Lab session 2026-09-26: rule vs brain on the real box with injected faults; brain runner (laptop-in-the-loop), session analysis, watchdog-safe runner
    [lab-baseline-2026-09-25-2115.csv, lab-baseline-2026-09-26-1034.csv, lab-brain-2026-09-26-2237.brain.csv, lab-brain-2026-09-26-2237.csv, lab-brain-2026-09-26-2314.brain.csv, lab-brain-2026-09-26-2314.csv]
2026-09-26 Lab session 2026-09-27: alternating rule/brain blocks on the real box (100 % clean data); lab firmware hardening (no Wire.end, control-sensor fallback, stricter filter); session analysis fixes
    [lab-baseline-2026-09-26-2330.csv, lab-baseline-2026-09-26-2345.csv, lab-baseline-2026-09-27-0055.csv, lab-baseline-2026-09-27-0155.csv, lab-brain-2026-09-26-2343.brain.csv, lab-brain-2026-09-26-2343.csv, lab-brain-2026-09-26-2346.csv, lab-brain-2026-09-27-0125.brain.csv]
2026-09-28 Evening session 27 Sep: rule vs brain on a dry leaky box, dead-mister fault not detected (negative result); paper, results and data index updated; session figures named by start time
    [lab-baseline-2026-09-27-2033.csv, lab-baseline-2026-09-27-2133.csv, lab-brain-2026-09-27-1958.brain.csv, lab-brain-2026-09-27-1958.csv, lab-brain-2026-09-27-2003.brain.csv, lab-brain-2026-09-27-2003.csv, lab-brain-2026-09-27-2103.brain.csv, lab-brain-2026-09-27-2103.csv]
2026-09-28 Add 1 cm lid-cycle test; reject BME280 with a dead humidity channel
    The Adafruit driver turns the chip's "not measured" value (0x8000) into a
    steady ~61 %RH that passes range checks. Read the raw register every sample
    and check ctrl_hum after init.
    [lab-lidcycle-2026-09-28-1513.csv, lab-lidcycle-2026-09-28-1526-c2.brain.csv, lab-lidcycle-2026-09-28-1526.csv]
2026-09-28 Add 1 cm dry-start test results
    [lab-lidcycle-2026-09-28-1720.csv, lab-lidcycle-2026-09-28-1733-c2.brain.csv, lab-lidcycle-2026-09-28-1733.csv]
2026-09-28 Rework paper for course submission
    [paper_figures.py]
